Puthikunkim/capstone/software-team/SBOM.md

# Software Bill of Materials (SBoM)

This document lists all third party software dependencies used in this project, their versions, and their licenses.

> **Policy:** The total budget for software licenses, servers, cloud services, and infrastructure is **$0**.  
> The system is self-hosted and runs entirely on a local Windows laptop with no internet connectivity required.
