Puthikunkim/capstone/compsys-team/ProjectResource/Schematic/Adobe Scan 18 Mar 2026.pdf

D
8

6-

I

I

I

£!I ~ • II ···-,l. 1/1 ii/I 1.1/f • \,. 1• I~ f~ ••

2 3 4

liii1iiil ~ ' ( , I

Power bypass between battery and load A(.i<>~ I~ . I > MCU power : loo~f: n;4'1-.J' ~~11, • • ;i t;V I

--- ------------~-;---;, ,.~vi.:--------------::--:-~~:----_:-~:--:---------,/ ..

V0(..1 l\u1.-S~~, 'ti t I~ ~ ( .. , • t1"-1'ti~:{ r;1,.u~1vA-rtut.J ., / J f 1e.ttl1 ll->~\. ""---- LP~ /t'b ()" • v~Nt · V_bn/ I -~i<ooE,, ( '.fc,,'-,wcA {,!~II • (Or,F: (c,11u-f I\"~~ • SVO o-v '<ti '

-- -~(<?:._-'C:,fr-\/1· I I .... 2t_.::J':~~~')J''""""JC.(Hop) ( I/A B:,ttcry tcrmmnls , ,'>\) Lo d terminals • I I I 2V Power Connectors (1. V z 1 ,n • • • • " • • l!, I

~

\'l"\Cr' ;_., '\! LEDi I I [jP7. l"'f"l.___"m f~1~('110JJ LED21.)Vl!$~~L) I

P3 ~ Bl\-rr;~'< ~ ·• • ·o V ~ ~ I .2V0 . • /J~~,o....... ~ V_biu ..... . P2 n ~- :---1 ?o ~ I T ~ '\/b1,'X ().~I/ ~v l V c~v-l.jV) I -;> V bat t'~~ ,Z SVO I - - - -- I "~1f~~/' . ·• ~i~,o_\ 4 P'J!CA'\OI-. \Jc.i...11\CA&-~111-ct1~Gt 3 u2 2 /?, OVTP"f s - ~ - t'°o6-.{\.. I • ~ P4 k k k ', ~ ~\'IV .. .,. j1. P8 11.o Jl'P ~ - ...-i,.llJ. 00 ::. G,.,A_ V/ TP] 4 I • 6 Wl/1-.)~ > .I )'),1,.J .. ~..- f\ I ~--- ··::-.. • ~11>P..:, ) ~ ., ·,·" _,, I fuwE>~~~ I • ' ~ t-,otS&<: ~ 4w c)'.ole_ ~stl V - . t u, I 4M • I - ftl.1~"

-=-
_ t-•~ -=- R.~1lR.-t :').~ J:v_ .«.-:Gpv~) P·r l=l-~cc.oo-t~i'-1(J.<4~ .1..t.J~~- f":tt•1:

©ID -11.,.~"- ~&.~?~LG(... "~i~tCJ~ ... P:~c, -:- <oovt-- l-~l>1=-s-i:tv ""--_ 1~ \J s-~.LV - IA -=- V ((~-1.3) ll. -=- -=- I

--; • ~~ ,.... - <,is-,l\ G~ R LI J. = a tic-A- - "p. ;.' ~ .... \. l Jf~vs ..... .:: ) -~ll.. ' t_NDi. ~ 111A . • GND B

- --------------:---------~Tc,7;"~=~b5"";_,~tV ,,.::;,di-:~7:-~-,::;E;i~¢!~:r-~;--~4°":..:-~-:,~---;:.-J I ,---------------------~--------""'---~---""'-~"T--r,-----,'"'J---1'~ ---
- ~:- v_~ I N~a~1'1uf ftt.DJAf.(,( CJf~P Vi lta d C . , t F db k VE:.P: v- :'\J+ - - V bat ADC GP34 ,

1 • tr ,t,"dt. : o. g<t an u~en ee ac . , -: •. = ~\J. -..1..'Vo.,t~"v _ . _ ..

l :t:.rt-v--" ,i- ·-, • . • ( l c.1. ') - - - ..... I ... li.JltJ'•r• "r/. '' ~,

- - • • • • • • "'• " • -, • • ;. • • * • Vv\- ·- - V • ,, ~ ft n I bat ADC GP35 r\ '""'~ \V N Oct::. : • • ,. V ~- . " ., a - r . "'-\ s "-~ I

.- ;- ": o11,- -~Q~~1:.">vo~,-:.I\) '\J-+-:.,h ~u V""-='V· "' .... I •6Uf-f·f:~~,.,, ! o ' .. c., • : 12-i .. -v ·--=-v+ "' 1 •. '" •v0 vi - - . •

, °"'" 8 5V0 • ~ ltJ- .. .A -v :.) )./,,,.._ \/do;1-V!,. r, a.,.n_, I -luw/kfL,A r,\.S<- • ........ -. lk .. : . • ":") ·vz,-., - ~vr. . . ~ - -==;e=-0' :) I M'S• ..... ~J. I "'l,ilr\ ·.,J ~ I~~ ;: : UIA : ..• Low- PAs~; +-1<..18- 0~ ~ Hl.6>'-ffk,'t): : V I bat a ' ' \' •. P.'l- l ~ '-:,r 1"1 • F ll,"1 ~s ? .. I .. /i..2 ~ ••• , ...... _ 1 t·· -1.- _'i I ' ~ 1 :•Rn •v_bat_ADC .f "O _ -11 •ru..M 1 7 I\IOV{ V ' I 1 V ba Rl4 0~ , I ~ .,.,::i-7::::i;d k 'V, - ~ I I

: Of,.. ' lk 'V~ + t'out =:lk C2 : . I ut;yA.1/:\SriE.'.1 oA:1- 00 UIB IN1 1 'C
I Ji ' V \ \' I -svo • ~--(:>!- RI! (cl '') , 16 / • • \ _ _ • •• • .- •, ., • • •• I .JOOn: •. , l . A.. \,• l_bat_AD -1.. '-\ S" v

j I k ' ' '1. Or., I .,, I , ' • •u • -----+-+---=+ . lk '- • -
·-, \/~1 A~i ~ .. - .... ~ . I • , • Ics •• '.~~ . . t t,V\ -or~,:,. 11 I \,A1"'"«1
_- o1v1.0 .=- -..::;;;;::.....--~ - v-•·o [:--"---- cs'-) U---I . 4

GND_ {£~ GND ,1 o~_ ... -- .,, ... -~- .... -G~ • • V'"' ·; ~P2?. er.:~~tv11 .(l~"'t- ADc )-d _
/ -lN~1.~ ~ ; ',.r-12-6; Rut:.~ .:~-OJ··· -:::) ~-1":-:- ( (J~~o·~)I \Jov1 I/ /i

I f2\~: !.-.y.,ct ~~~ ..... ; ~ \\.d~ ( (j)

__ lltt\ ~- l·\~· e> - GND r ,. L:~ GND -: ---(.. (1: .-V ':"o =-~l~ // ' l . 1 / •/. 4 L' --.<. h , u ,,. V4'\ l)\J\ S<.:) I / 1 4'V\ )

, '("':t'). L""'':":ri ~·r1~«... '.~- ~ ,,- .. , . - ~w:· ~out::-~ =-o .• • .. ; .- .. o:. (>C -~ . I '- )l

# !~~P~~~_!.!::!:!_~_:_:~ P'!~----~~l~---------------------1 \l j

-------~--- ~ -+- • '1 : •• L-:,~·: _:"~'-S~(' -'\/~ {9-ioi,,IJ. (,( (j"4:i.,! ~ i"'~) Title CapstoncProject:Uni-Directiona!EncrgyMeter

Powet and Signal Conditioning Size Nwnber Revision 3

D

A4

Date: 2/2412026 Sheet! of 2

File: C:\Uscr..\.luni dir ene meter v3.SchJ)lilrawn By: TD, SK & AB

2 3 4
