Puthikunkim/capstone/compsys-team/ProjectResource/Lectures/L4 - Practical Circuits and RC Filters.pdf

Grant Covic and Duleepa Thrimawithana

## Signal Conditioning

# Electronics System Design

## ELECTENG 209

•

# Learning Objectives

Review of operational amplifier basics

- What are inverting and non-inverting amplifiers
- How are difference amplifiers created and why are they useful?
- Understanding practical signal conditioning circuits using single sided supplies
- What practical considerations are needed with voltage and current measurement circuits?
- How do we create RC filters and what are the design approaches in the frequency domain?
- Understanding the use and design of comparators for interrupt circuits
- Design guidelines for creating a regulated supply suited to your analogue and digital electronics.
2 Grant Covic and Duleepa Thrimawithana, Department of Electrical, Computer, and Software Engineering (2022)

# The Energy Monitor Hardware design

3

- Requires Voltage Sensing, Current Sensing as discussed earlier.
- Signal conditioning

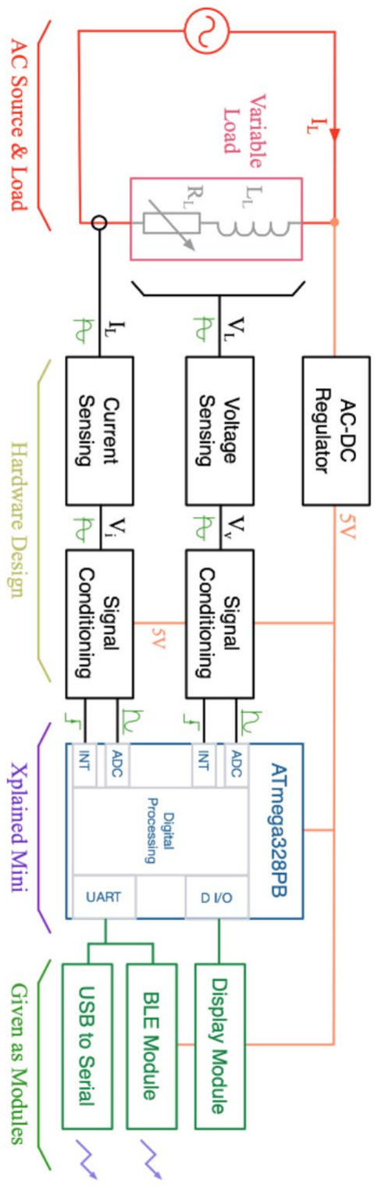
[picture p21: figure]

- Level shifting, amplification and noise reduction
- Generation of a suitable interrupt to trigger measurement from the microprocessor.
- Practical operation from a single 5V power regulator.

Grant Covic and Duleepa Thrimawithana, Department of Electrical, Computer, and Software Engineering (2022)

## Operation with Single Sided supplies

## Thevenin Equivalents

## Level Shifting

# Practical Signal Conditioning Circuits

# Signal Conditioning of the Voltage and Currents

23

The Analogue to Digital Converter (ADC) measurement in a microprocessor only samples positive voltages (0-5V),

while the AC signal has no DC component. We also normally only have one single supply to operate the op-amp off.

•

Therefore we need to
Add a DC offset to the signal, then amplify and filter as required
- Use an op-amp that is operating off a single 5V supply.
- The output will appear as a ±2.5V AC signal swing. 5 V

Range

ADC

0

v

VVVVVV

0

v

Grant Covic and Duleepa Thrimawithana, Department of Electrical, Computer, and Software Engineering (2022)

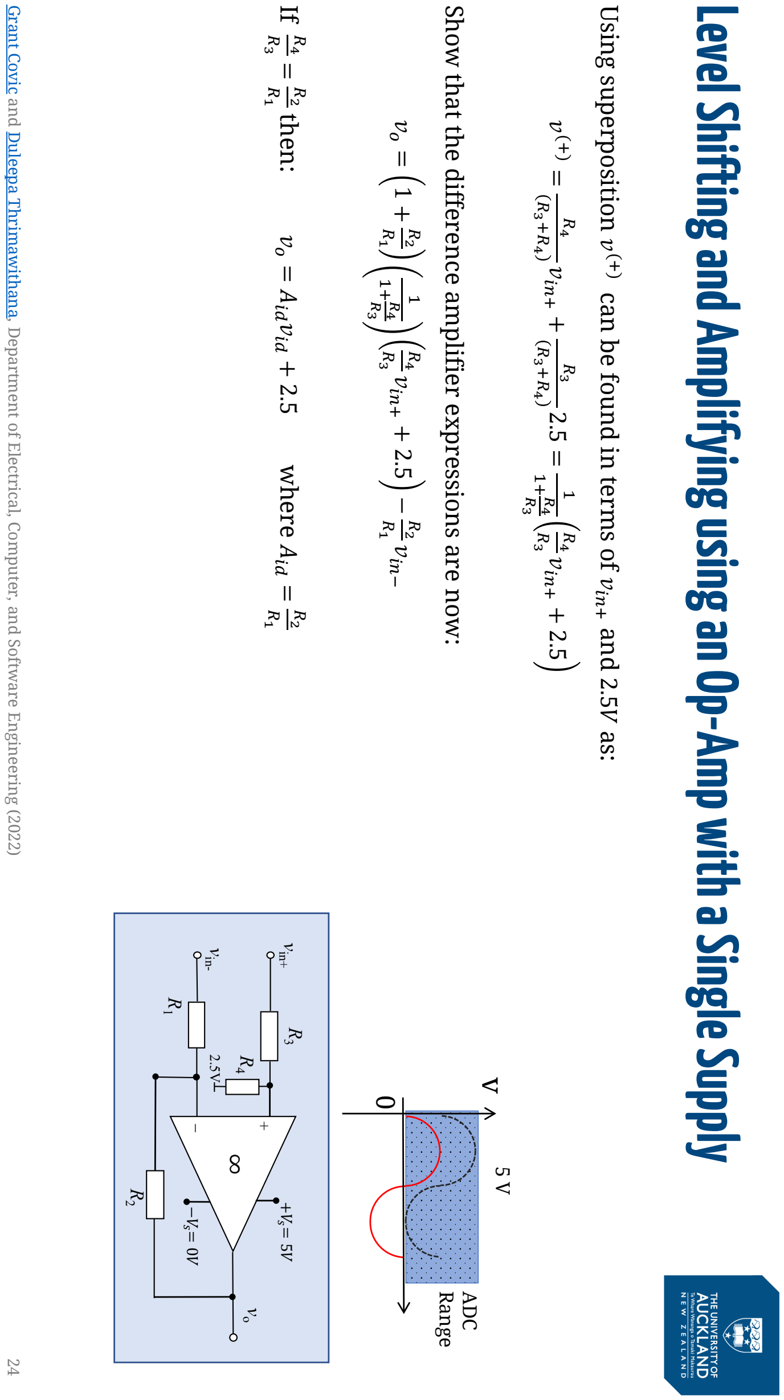
[picture p22: figure]
vviiii+ + RR3; RR3 vviiii+ + 2.5; vvoo = 1 + RR2; RR3 vviiii+ + 2.5 − RR2; vviiii−; RR1 then: vvoo =; AAiiiivviiii + 2.5 where; AAiiii; Range; ADC; ∞ vin-; R3 vin+; +VVss= 5VV; −VVss= 0VV

# Level Shifting and Amplifying using an Op-Amp with a Single Supply

Using superposition vv(+) can be found in terms of vviiii+ and 2.5VV as:

Show that the difference amplifier expressions are now:
Grant Covic and Duleepa Thrimawithana, Department of Electrical, Computer, and Software Engineering (2022)

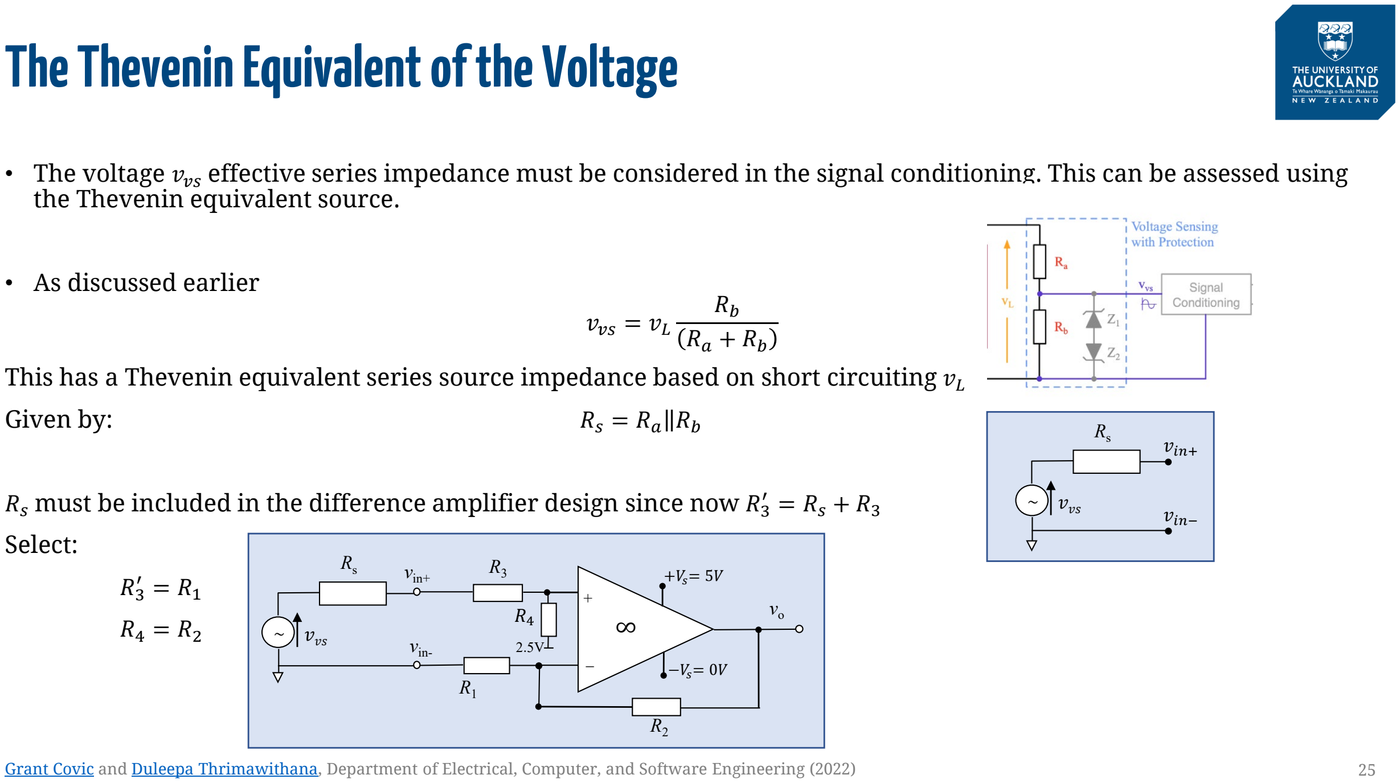
[picture p23: figure]
The Thevenin Equivalent of the Voltage; the Thevenin equivalent source.; • As discussed earlier; vvvvss = vvLL; RRbb RRaa + RRbb; Given by:; RRss = RRaa‖RRbb; Select:; vvvvvv; vviiii−; vviiii+; vin-; +VVss= 5VV; −VVss= 0VV

- The voltage vvvvss effective series impedance must be considered in the signal conditioning. This can be assessed using

This has a Thevenin equivalent series source impedance based on short circuiting vvLL

RRss must be included in the difference amplifier design since now RR3′ = RRss + RR3

Grant Covic and Duleepa Thrimawithana, Department of Electrical, Computer, and Software Engineering (2022)

# Output Voltage limitations of Op-Amps

Standard Op-Amps have outputs that cannot reach voltage supply rails, and current limits when sinking or sourcing. Voltage limits: The upper and lower voltage limits are LL+and LL−respectively. Trying to output a voltage above or below these limits will cause the signal to be clipped.
- E.G., the usable output range of the LM324/358 (in your design) has LL− = 5mmVV, LL+ = 3.5VV (when the supply is 5 V)
- A rail to rail Op-Amp could be used to improve accuracy
- Output could reach close to supply rails thus allowing to utilize full ADC range of 0 V to 5 V

0

vamp

Rail to rail Op-Amp

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
1.75V

+VVss= 5VV

−VVss= 0VV

VVVVVV

Rs

~
RRLL

IIoo

IL IF
0

voMAX

Standard Op-Amp

5 V

Grant Covic and Duleepa Thrimawithana, Department of Electrical, Computer, and Software Engineering (2022) | 26

# Output Current limitations of Op-Amps

Current Limits: the specified current limits (typically 20mA), include the total of the load and feedback circuit which the op-amp must supply, but the capability of the 358 to sink current at low voltage is poor.
- If there is an output load RRLL, when does the maximum current flow?
- At the peak voltage (3.5V), IIoooooooo = IIFF + IILL. If IIoooooooo > IILLLLoo then the waveform will clip. Choose resistors in kkΩ
- If there is an output filter there may be issues sinking the current into the op-amp to bring the load voltage down to < 1V that may mean we need smaller values for RRLL, RR2 and RR1to reduce the capacitor voltage in time

0

voMAX

Standard Op-Amp

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
1.75V

+VVss= 5VV

−VVss= 0VV

VVVVVV

Rs

~
RRLL

IIoo

IL IF

R1
R2

vo +

−

∞

R3

RR4

1.75V

+VVss= 5VV

−VVss= 0VV

VVVVVV

Rs

~
RRLL
Io | IL
IF | CL
vL | In general, choose:
R’s < 500k
C’s > 100pF

At minimum vvoo → 0

Grant Covic and Duleepa Thrimawithana, Department of Electrical, Computer, and Software Engineering (2022)

# Ex: Voltage Measurement

Design a differential amplifier, that can level shift vvvv measured by the voltage sensing circuit in the figure below to be within 0 to 3.5 V (within the op-amp and ADC range). Ignore the lower limitation on the Op-Amp.
- Design for a level shift of 3.5V/2 = 1.75 V
- Peak to peak level of sensed signal

vvvv(pppp−pppp) = 24 × 2 × 2 × 10pp 220pp+10pp = 2.95VV

The differential amplifier gain should be no more than 1.4, but choosing AAiiii~1 is sufficient
- Aim to achieve a 3 V signal swing at output, (0.25 V off the rail limit).
- The RMS Thevenin voltage source and resistance are: vvvvss = 24 × 10pp 220pp+10pp = 1.04VVRRooVV and RRss = 220pp×10pp 220pp+10pp = 9.6kkΩ
- If AAiiii = RR2RR1 = 1, then make RR1 = RR2 = RRss + RR3 .
- We can choose RR1 = RR2 = 100kkΩ and RR3 = 90.4kkΩ ≈ 22kkΩ + 68kkΩ by connecting two E12 value resistors in series.
24VVRRRRVV | RL

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
vvvv

RR2

1.75V

+VVss= 5VV

−VVss= 0VV

10kkΩ

220kkΩ

vvLL

Grant Covic and Duleepa Thrimawithana, Department of Electrical, Computer, and Software Engineering (2022) | 28

# Level Shifting with a Cap

A DC bias derived through for example a voltage bias and an AC coupling capacitor can be used for level-shifting
- An example of voltage measurement is shown in figure
- An AC coupling capacitor, CCaaii, used to add the sensed voltage, vvvv, with a 2.5VV bias derived through two RR1’s

CCaaii together with Thevenin resistances of vvvv and bias voltage all together form a high-pass filter
This arrangement can be used to eliminate the need for an Op-Amp
- The disadvantage is that this network cannot amplify the measured signal and will couple any high-frequency noise present, which is automatically suppressed by the op-amp due to its internal filtering.
- The capacitor can introduce some phase shift in the signal.
Grant Covic and Duleepa Thrimawithana, Department of Electrical, Computer, and Software Engineering (2022) | 29

# Ex: Current Measurement

Op-amp range 3.5V

ADC Range 0-5V

0

vout

1.75V

3.16V

0.34V

2.03V

1.47V

0

vi

0.141V

-0.141V

28mV

28mV

iL = 1 A and iL = 0.2 A

24VVRRRRVV

RL

~

10kkΩ

100kkΩ

vo

+

−

∞

10kkΩ

vvii 100kkΩ 1.75V

+VVss= 5VV

−VVss= 0VV

0.1Ω

vL iL

A 100 mΩ shunt resistor is used to sense the current flowing through a variable load.
The load current is in the range 0.2 ARMS to 1 ARMS.

Design a differential amplifier, that can amplify and level shift this signal to be within 0 to 3.5 V (op-amp range).

- Max and min peak-peak signal sensed by the shunt

vvii,oooooo(pppp−pppp) = ii pppp−pppp RRss = 2 2 × 1AARRooVV × 100mmΩ = 282mmVV

vvii,ooLLMM(pppp−pppp) = ii pppp−pppp RRss = 2 2 × 0.2AARRooVV × 100mmΩ = 56mmVV

Again design to achieve around a 3 V signal swing at output (0.25 V off either rail)

AAiiii = RR2RR1 = 3VV 0.282VV = 10.64

- Choosing a gain of AAiiii~ 10 would satisfy this.
- Choose RR1 = 10kkΩ and RR2 = 100kkΩ (E12 series)
- Min and Max voltage swings are: 0.56V and 2.82V

5V

Grant Covic and Duleepa Thrimawithana, Department of Electrical, Computer, and Software Engineering (2022) | 30

## Frequency domain filtering

## Frequency domain Bode plots

## A simple RC Circuit

# RC Filters and the Frequency Response

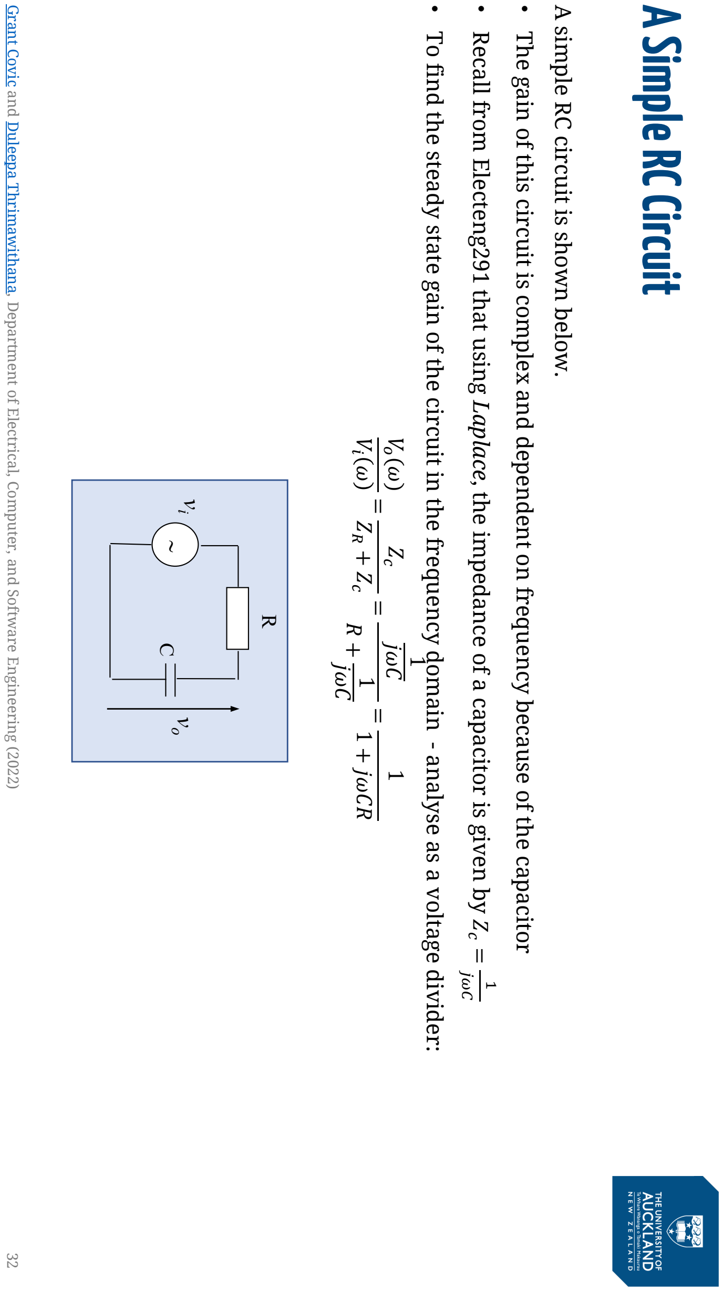
[picture p24: figure]
A simple RC circuit is shown below.; A Simple RC Circuit; ZZii = 1; jjωωωω; VVoo(ωω); VVii ωω; ZZii; ZZRR +; jjωωCC; = 1 1 + jjωωCCRR

The gain of this circuit is complex and dependent on frequency because of the capacitor

- Recall from Electeng291 that using Laplace, the impedance of a capacitor is given by
- To find the steady state gain of the circuit in the frequency domain - analyse as a voltage divider:

Grant Covic and Duleepa Thrimawithana, Department of Electrical, Computer, and Software Engineering (2022)

•

If the gain of a circuit is complex, then like any complex number if can be expressed in terms of its magnitude and phase.

# Frequency Domain Bode Plots

For zz = aa + jjjj

The magnitude of this complex number is: zz = aa + jjjj = aa2 + jj2

## The phase of this complex number is: ∠zz = tan−1 aabb

- In the case of the complex gain expression for the RC circuit, both phase and magnitude are changing with ωω

Bode plots are used to view separately how the magnitude and phase vary with frequency.
frequency range

However it is convenient to look at the impact using a logarithmic scale because the impact can be seen over a very wide

- often over many orders of magnitudes. Our ear also has a logarithmic response which makes this assessment useful. The “bel” scale was defined as the log-base-ten of the ratio of two signal intensities related to the power or
energy in the signal. As there are 10 decibels per bel the power ratio is defined as:

## 10llllll10 PPooPPii the power ratio in decibels (dB)

Power is proportional to the square of the voltage and therefore this is re-expressed as

## 20llllll10 VVooVVii (the voltage ratio in dB)

Here the voltages are in terms of their rms quantities.
33 Grant Covic and Duleepa Thrimawithana, Department of Electrical, Computer, and Software Engineering (2022)
In engineering base 10 is assumed as the default when

# Frequency Domain Bode Plots

log HH(ωω) is used.

- The Bode magnitude is a plot of the gain expression in dB 20 log VVoo ωω VVii ωω against log ωω

## - The Bode phase is a plot of tan−1 VVoo ωω VVii ωω against log ωω

•

Simple log rules are useful to remember
log AAAA = log AA + log AA and log ⁄AA AA = log AA − log AA

Creating the Bode plot

## - Defining the time constant TT = RRCC, then GG ωω = 1 1+jjωωjj

- Matlab can be used to plot the Bode expression for any given value of T.

34

T=10;

clc

% Time constant = 10s

num=1; % define numerator as 1

den=[T, 1]; % define denominator as sT+1 = jωT+1

sys = tf(num,den) % define the system transfer function

figure(1) % set up a figure to plot the system

bode(sys) % create the bode plot

grid % add a grid

Grant Covic and Duleepa Thrimawithana, Department of Electrical, Computer, and Software Engineering (2022)

For

Sketching approximate Bode plots

# Frequency Domain Bode Plots

GG ωω = 1

1+jjωωjj ,

Bode magnitude in dB is: GG ωω iidd = 20 log 1 1+jjωωjj = −20 log 1 + jjωωTT = − 20 log 1 + jj ⁄ ωω ( ⁄1 TT)

Bode phase is: ∠GG ωω = ∠ 1 1+jjωωjj = −∠ 1 + jjωωTT = − tan−1 ⁄ ωωTT 1 = − tan−1 ⁄ ωω ( ⁄1 TT)

The breakpoint frequency can be defined as ωωbb = ⁄1 TT

- When ωω = ωωbb, then GG(ωωbb) iidd ≅ −20 log 1 + jj1 = −20 log 2 = −3ddAA ∠GG ωω = − tan−1 ⁄1 1 = −45°

Asymptotes can be determined either side of ωωbb
- When ωω ≪ ωωbb, then GG ωω iidd = −20 log 1 + ⁄ jjωω ωωbb ≅ −20 log 1 = 0ddAA ∠GG ωω ≪ ωωbb = − tan−1 ⁄0 1 = 0
- When ω ≫ ωb, then G ω id = −20 log 1 + ⁄ jω ωb ≅ −20 log ⁄ jω ωb dA ∠G ω ≫ ωb = − tan−1 ⁄ ω ωb = −90°
Example: ωω = 10ωωbb gives GG(10ωωbb) iidd = −20 log ⁄ jj10ωωbb ωωbb = −20ddAA, ∠GG 10ωωbb − tan−1 10 = −84.3°

ω = 100ωωbb gives G(100ωωbb) id = −20 log jj100 = −40ddAA, ∠G 100ωωbb − tan−1 100 = −89.4°

35 Grant Covic and Duleepa Thrimawithana, Department of Electrical, Computer, and Software Engineering (2022)

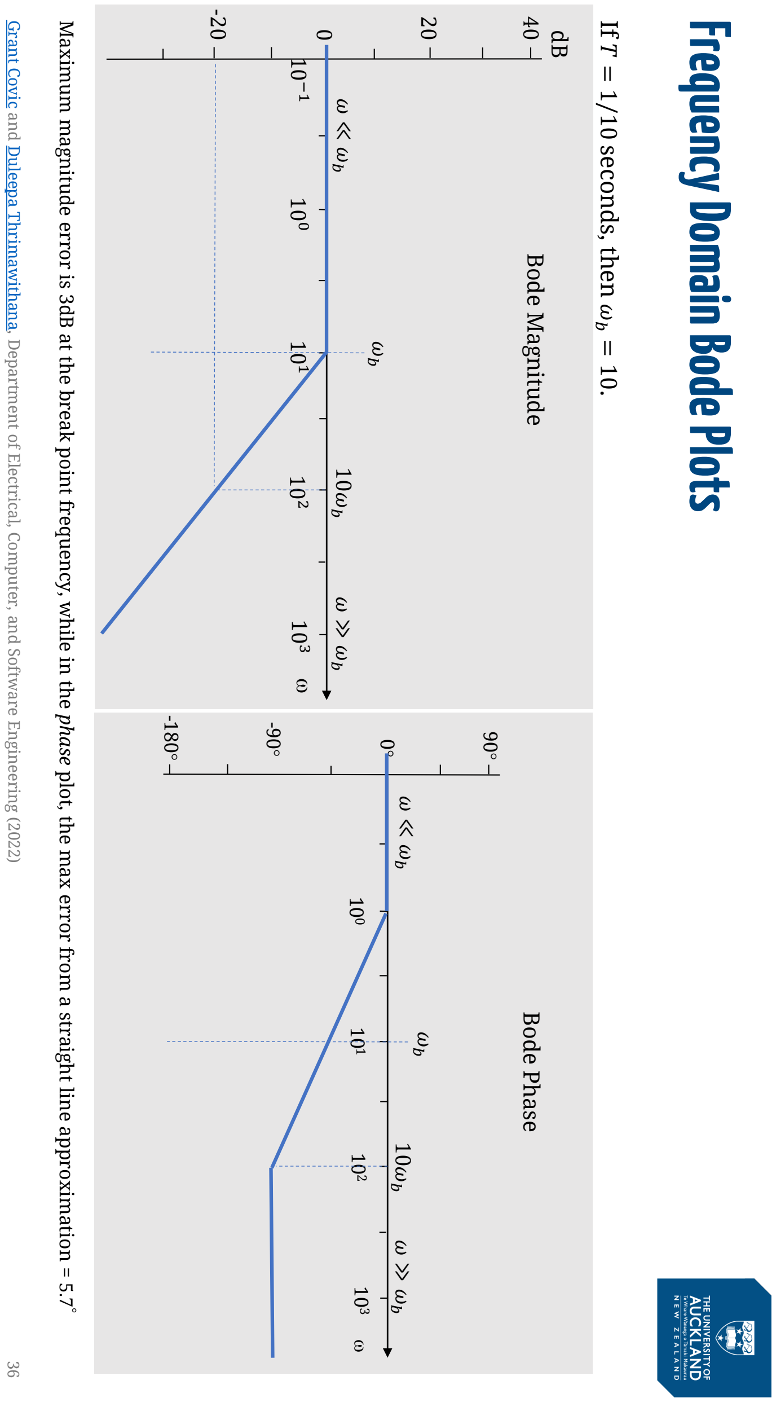
[picture p25: figure]
Frequency Domain Bode Plots; TT = 1/10 seconds, then ωωbb = 10.; ωωbb; ωω ≪ ωωbb ωω ≫ ωωbb 100 101 102 103 ω; ωω ≪ ωωbb ωω ≫ ωωbb; 10ωωbb; Bode Magnitude Bode Phase

Maximum magnitude error is 3dB at the break point frequency, while in the phase plot, the max error from a straight line approximation = 5.7°

Grant Covic and Duleepa Thrimawithana, Department of Electrical, Computer, and Software Engineering (2022)

components

From Electeng291 notes recall that a periodic waveform in the time domain is constructed of various frequency

All real world signals are made up of various frequencies.

# Frequency Domain Filtering

– and the magnitude of these can be determined from the Fourier series:

•

For example consider the square wave shown. When this waveform is passed through the filter: Frequencies at least a decade below ωωbb = 2ππffbb will have their magnitude and phase preserved.

- Frequencies above ωωbb will have their magnitude reduced (attenuated) and will also be shifted in phase.
- Ex: Assume an input waveform as: vvii = sin ωωfftt + 0.33 sin 3ωωfftt + nnlliivvnn

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
vvoocan be phase distorted if ωωff → ωωbb

third harmonic reduced and phase shifted

-1/3V

1/3V 0

vo

1V

-1V

-1/3V

1/3V

vvoo when ωωff ≪ ωωbb

no amplitude loss and no phase distortion

Ex: Square wave time domain v.s.

frequency component amplitudes & phases
Grant Covic and Duleepa Thrimawithana, Department of Electrical, Computer, and Software Engineering (2022)

# Questions?
