Puthikunkim/capstone/compsys-team/ProjectResource/Lectures/negativeFeebackLoop.pdf

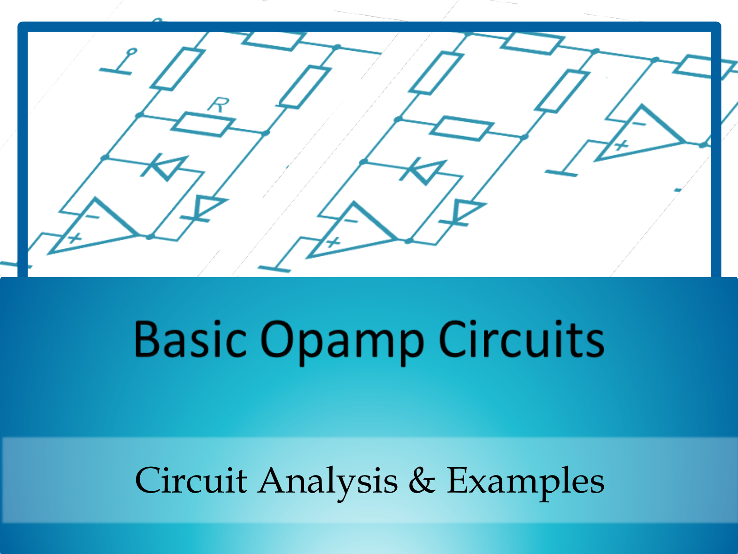
[picture p26: page 1]

### Circuit Analysis & Examples

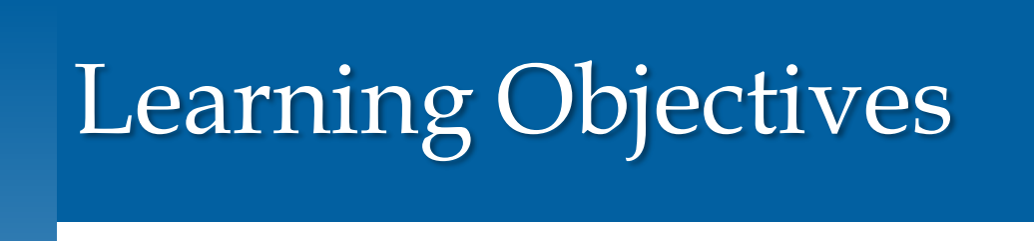
[picture p27: figure]
Learning Objectives

Prepared by Dulsha Kularatna-Abeywardana for ELECTENG 292

- Study the following commonly used circuits which are designed using opamps:
– Standard voltage amplifiers
✓Inverting amplifier
✓Non-inverting amplifier
– Summing amplifiers
– Differential amplifier
– Voltage follower
– Current to voltage converter – Integrator & differentiator

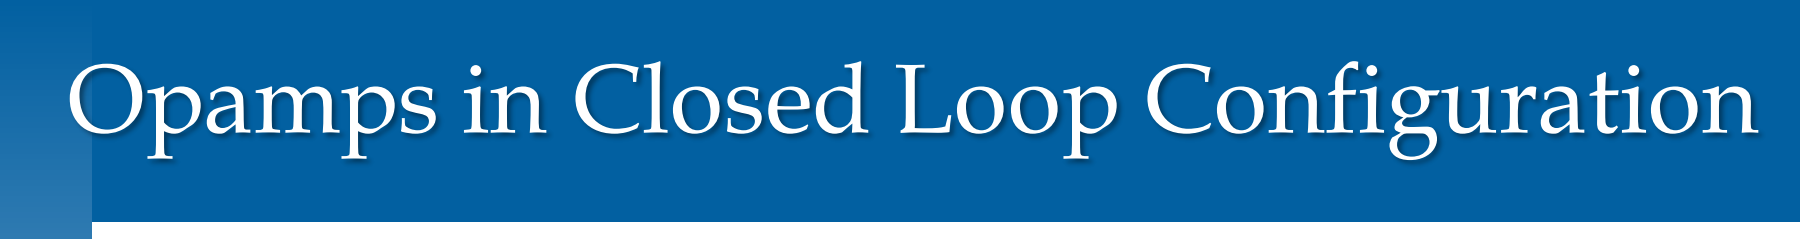
[picture p28: figure]
Opamps in Closed Loop Configuration

Prepared by Dulsha Kularatna-Abeywardana for ELECTENG 292

- Opamps are not very useful in their open loop configuration as the gain is too high.
- We will now investigate opamp circuits which have their output fed back to the input.
- This is known as the closed loop configuration.
- The closed loop gain G is dependent on the component values of the opamp circuit.
- G is independent of the open loop gain A.

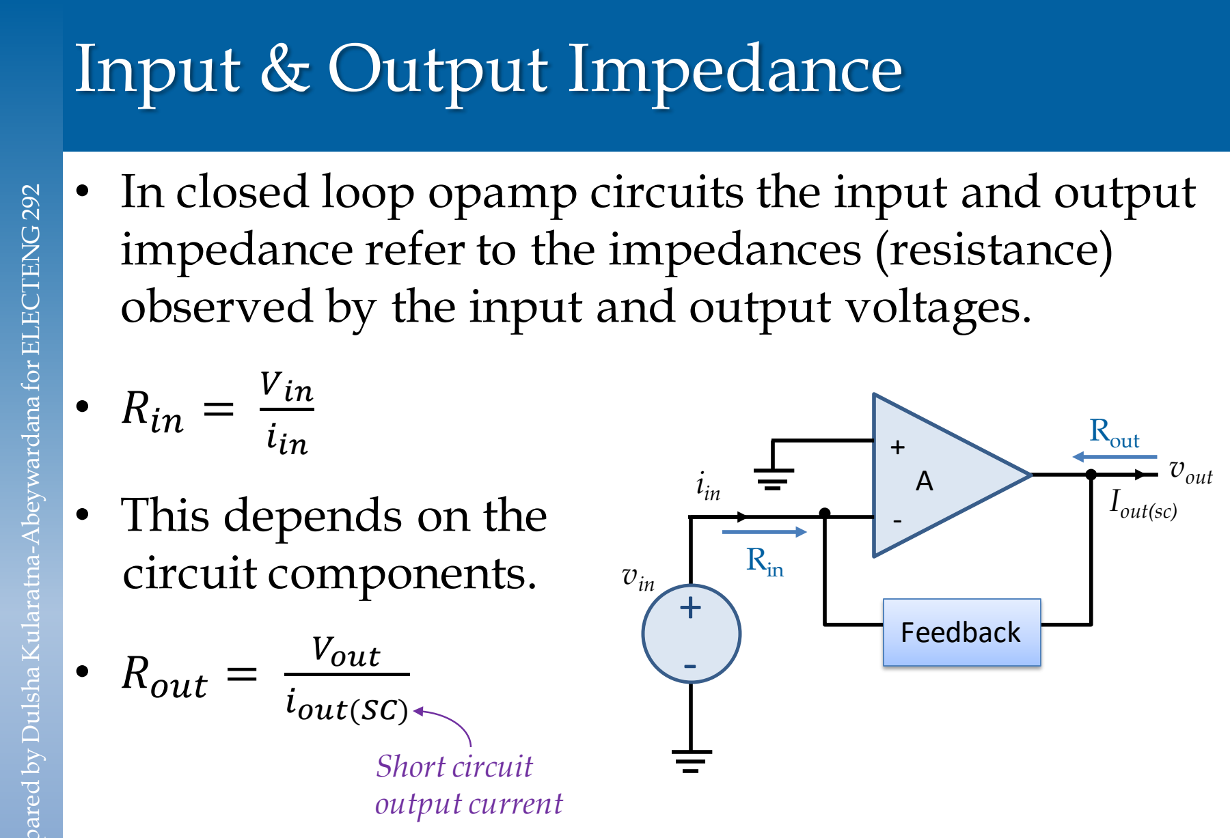
[picture p29: figure]
Input & Output Impedance • RRiiii =; VViiii iiiiii; • This depends on the circuit components. • RRoooooo =; VVoooooo iioooooo(SSSS); vout; Iout(sc); vin; Feedback; iin; Rin; Rout; Short circuit output current

Prepared by Dulsha Kularatna-Abeywardana for ELECTENG 292

- In closed loop opamp circuits the input and output impedance refer to the impedances (resistance) observed by the input and output voltages.

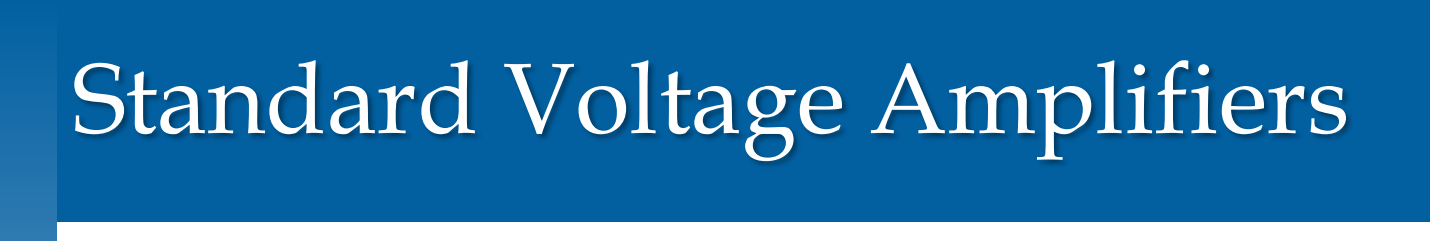
[picture p30: figure]
Standard Voltage Amplifiers

Prepared by Dulsha Kularatna-Abeywardana for ELECTENG 292

- Two basic configurations:
– Inverting amplifier: Input and output are opposite in polarity
– Non-inverting amplifier: Input and output have the same polarity

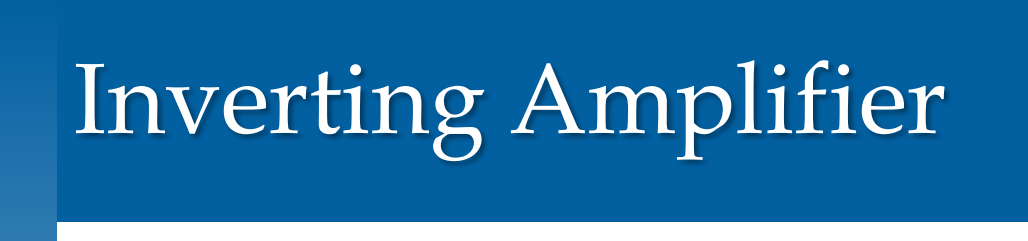
[picture p31: figure]
Inverting Amplifier

Prepared by Dulsha Kularatna-Abeywardana for ELECTENG 292

- The output has the opposite polarity to the input voltage.

Vin

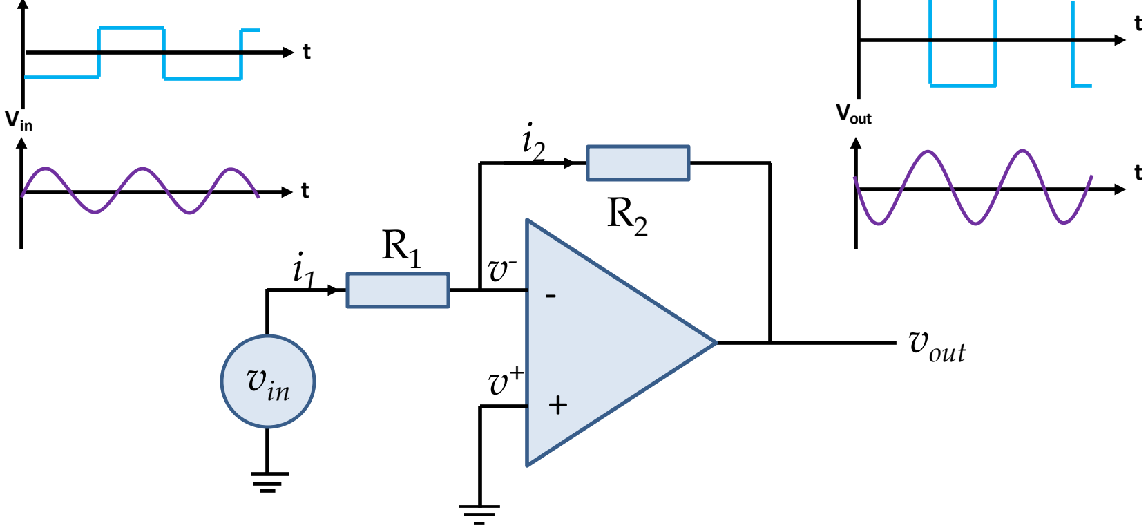
[picture p32: figure]
vout; vin; Vin; Vout

Vout

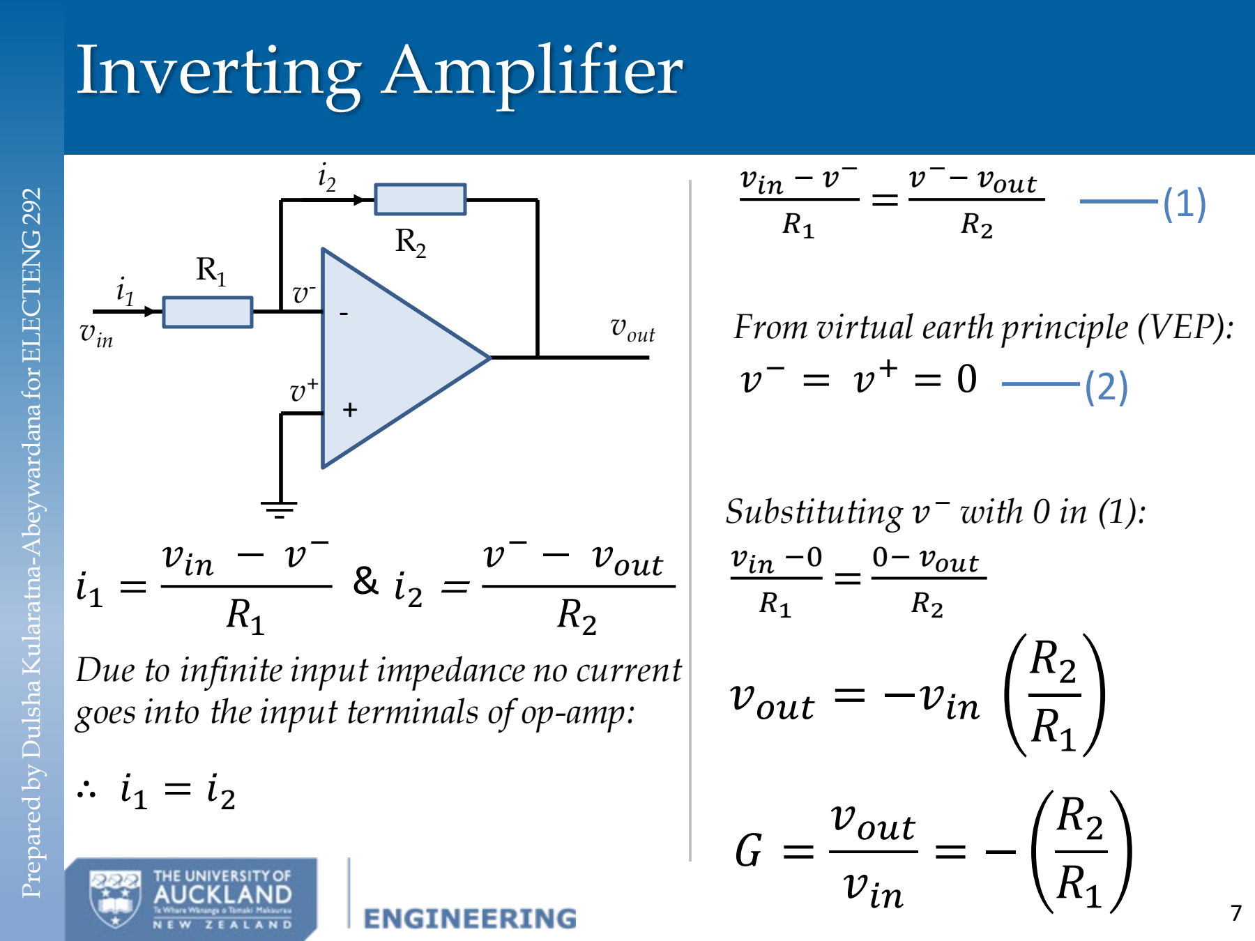
[picture p33: figure]
Inverting Amplifier; vout; vin; vv− − vvoooooo RR2; vviiii − vv− RR1 ∴ ii1 = ii2; vviiii − vv− RR1; vv−− vvoooooo RR2; From virtual earth principle (VEP):; vvoooooo = −vviiii; vviiii −0 RR1; 0− vvoooooo RR2; Substituting vv− with 0 in (1):; vvoooooo vviiii

Prepared by Dulsha Kularatna-Abeywardana for ELECTENG 292

Due to infinite input impedance no current goes into the input terminals of op-amp:

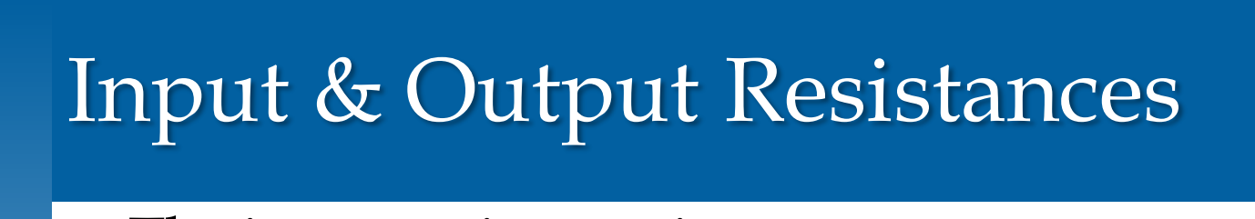
[picture p34: figure]
Input & Output Resistances

Prepared by Dulsha Kularatna-Abeywardana for ELECTENG 292

- The input resistance is:

## RRiiii =

VViiii
iiiiii

=

VViiii
ii1

= RR1

- To avoid signal loss a high input resistance is needed.
- A large resistance must be chosen for R1.
- If a large gain is required (G = R2/R1), R2 might become impractically large.
- Inverting amplifiers suffer from a low input resistance.
- The output voltage and current are taken at the terminals of the ideal voltage source at output, the output resistance is zero.

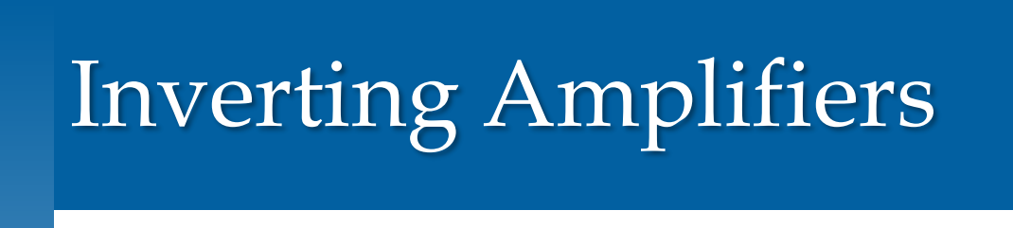
[picture p35: figure]
Inverting Amplifiers

Prepared by Dulsha Kularatna-Abeywardana for ELECTENG 292

- It follows the negative feedback.
- The gain factor of these amplifiers is very high.
- The output generated will be out of phase with the applied input signal.
- The potential values at both inverting and non-inverting terminals will be maintained at zero.
- Practical uses include:
– Phase shifter as the output is 180-degrees out of phase – Integration
– To balance signals
– Amplifiers for sensors

## Inverting Amplifier: Example

# ii1 = vviiii − vv−

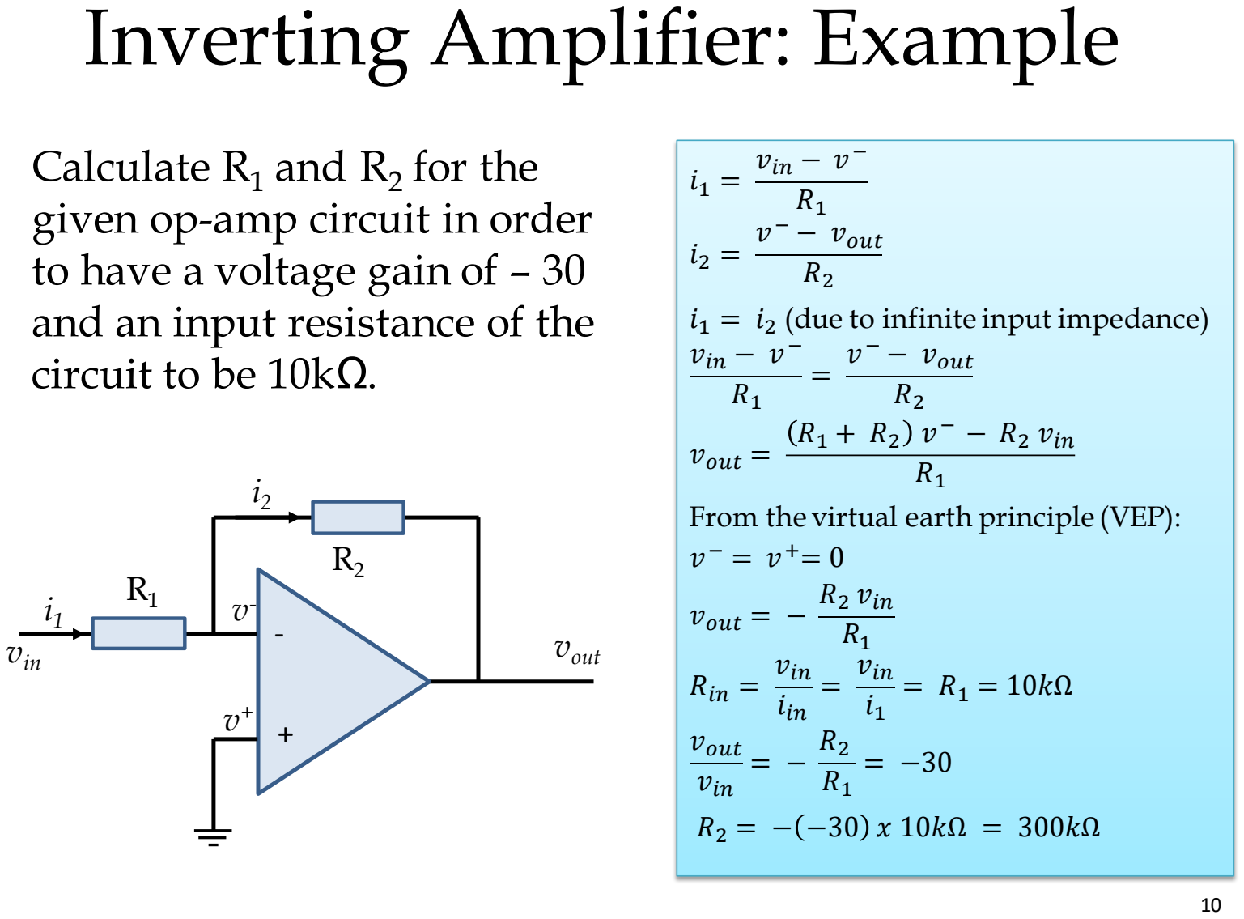
[picture p36: page 10]

Calculate R1 and R2 for the given op-amp circuit in order to have a voltage gain of – 30 and an input resistance of the circuit to be 10kΩ.

RR1

# ii2 = vv− − vvoooooo

RR2
ii1 = ii2 (due to infinite input impedance)

# vviiii − vv−

RR1

# = vv− − vvoooooo

RR2

# vooo = RR1 + RR2 v− − RR2 vii

RR1

From the virtual earth principle (VEP):

# vv− = vv+= 0

# vooo = − RR2 vii

RR1

# Rii = vii

iiiiii

= vviiii
ii1

# = RR1 = 10kkΩ

vvoooooo
vviiii

= − RR2
RR1

= −30

# RR2 = − −30 xx 10kkΩ = 300kkΩ

vout

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
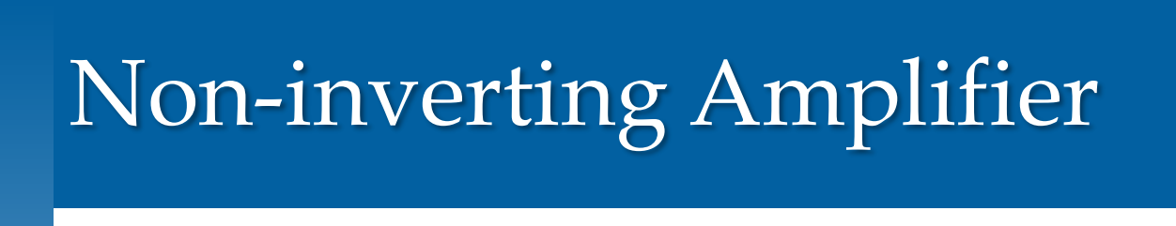
[picture p37: figure]
Non-inverting Amplifier

Prepared by Dulsha Kularatna-Abeywardana for ELECTENG 292

- Known as the ‘non-inverting amplifier’ because the output has the same polarity as input voltage.

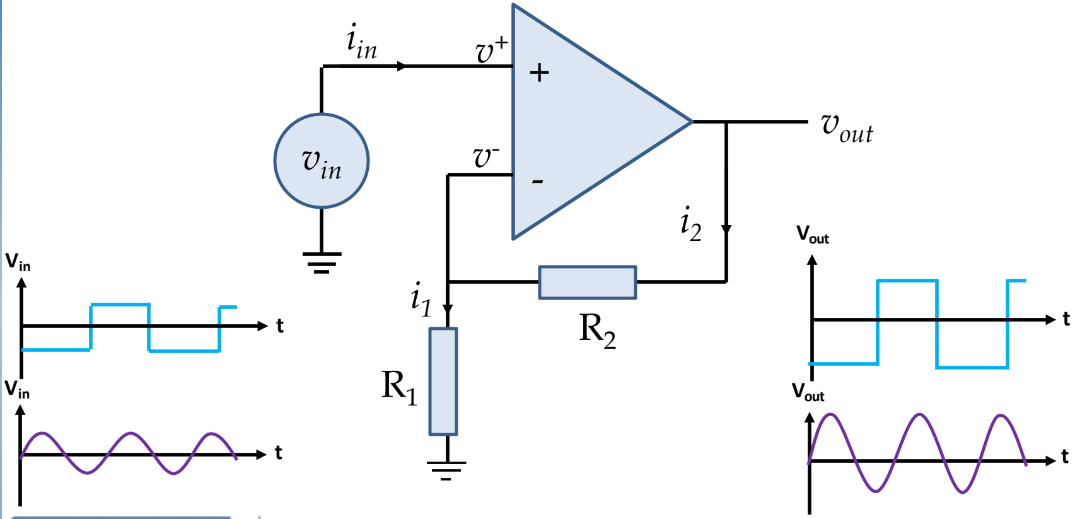
[picture p38: figure]
vout; - vin; iin; Vin; Vout

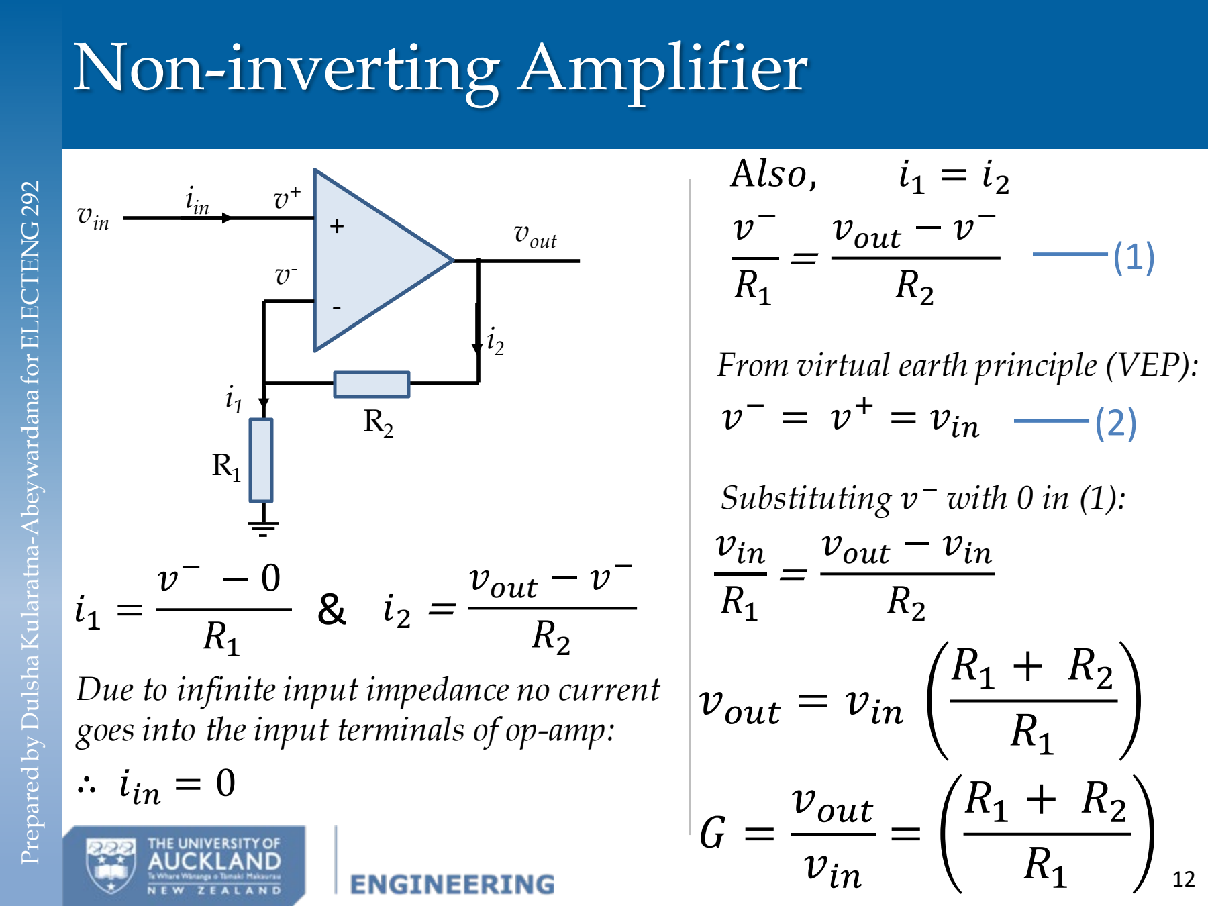
[picture p39: figure]
Non-inverting Amplifier; vvoooooo − vv− RR2; Allllll, ii1 = ii2; From virtual earth principle (VEP):; vv− = vv+ = vviiii; vout; vin; iin; ∴ iiiiii = 0; vvoooooo = vviiii; Substituting vv− with 0 in (1):; vviiii RR1; vvoooooo − vviiii RR2; vvoooooo vviiii

Prepared by Dulsha Kularatna-Abeywardana for ELECTENG 292

Due to infinite input impedance no current goes into the input terminals of op-amp:

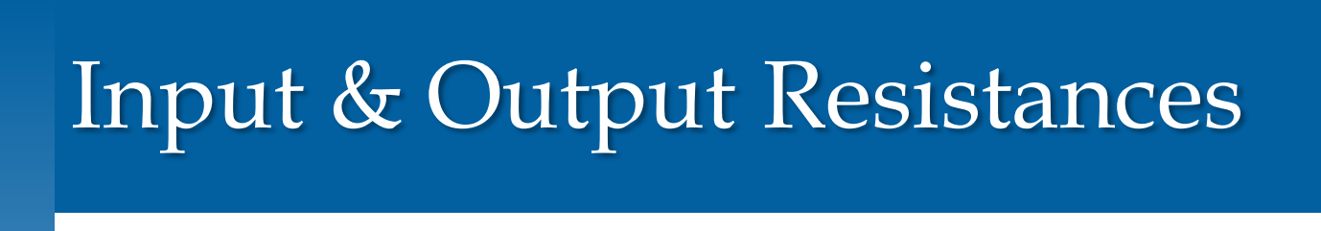
[picture p40: figure]
Input & Output Resistances

Prepared by Dulsha Kularatna-Abeywardana for ELECTENG 292

- The input resistance is:

# RRiiii =

VViiii
iiiiii

=

VViiii
0

= ∞

- This is advantageous in some cases.
- The output voltage and current are taken at the terminals of the ideal voltage source at output, the output resistance is zero.

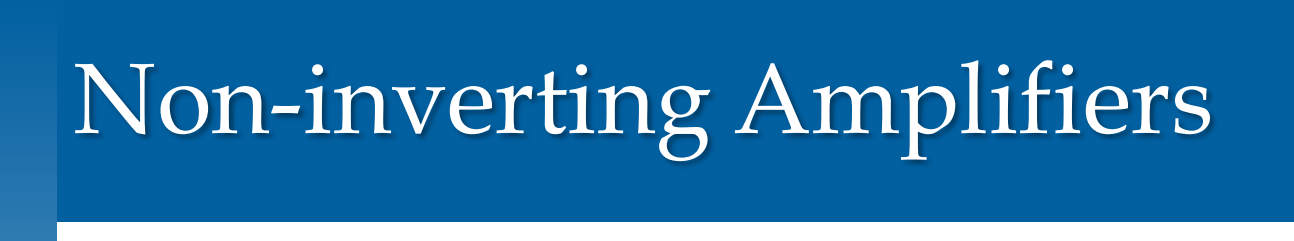
[picture p41: figure]
Non-inverting Amplifiers

Prepared by Dulsha Kularatna-Abeywardana for ELECTENG 292

- The voltage gain is always greater than one.
- The voltage gain is positive, and the output is inphase with the input signal (for AC) and the output polarity has the same as the input (for DC).
- These are used in
– Circuits that require a high input impedance
– To isolate the respective cascaded circuits

## Non-inverting Amplifier: Example

=> ∞

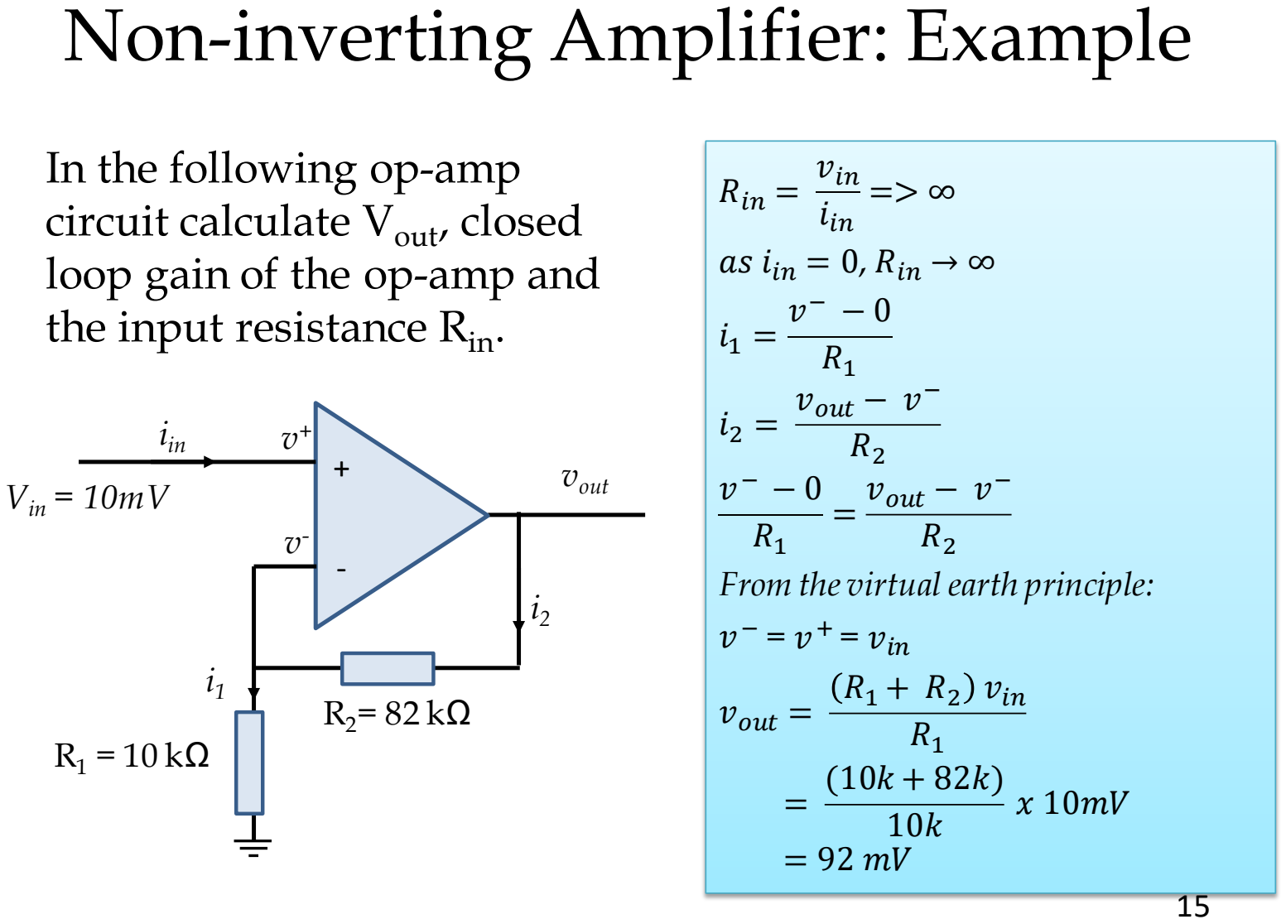
[picture p42: page 15]

In the following op-amp
circuit calculate Vout, closed loop gain of the op-amp and the input resistance Rin.

RRiiii =

vviiii
iiiiii

# aa iiiiii = 0, RRiiii → ∞

ii1 =

vv− − 0
RR1
ii2 =

# vvoooooo − vv−

RR2
vv − − 0
RR1

=

# vvoooooo − vv−

RR2

From the virtual earth principle:

# vv − = vv + = vviiii

## vvoooooo =

# RR1 + RR2 vviiii

RR1
=

# (10kk + 82kk) 10kk xx 10mm

= 92 mm

v⁺

v-

vout

R2= 82 kΩ
R1 = 10 kΩ

+

Vin = 10mV

iin

i1

i2

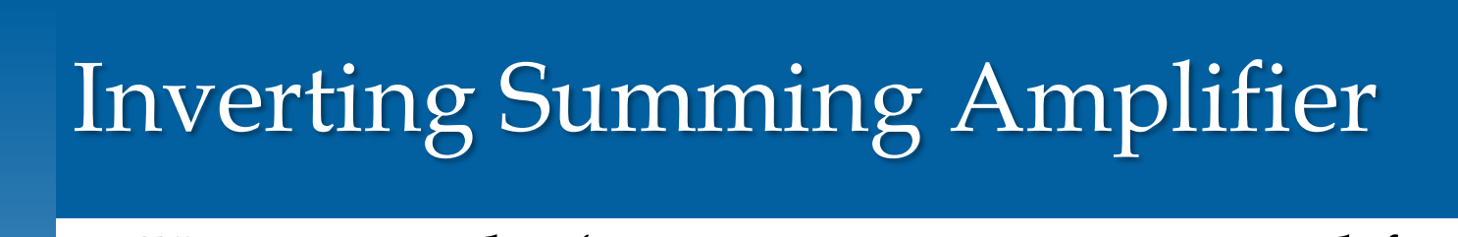
[picture p43: figure]
Inverting Summing Amplifier

Prepared by Dulsha Kularatna-Abeywardana for ELECTENG 292

- Known as the ‘inverting summing amplifier’ as the output is a weighted sum of the input voltages,

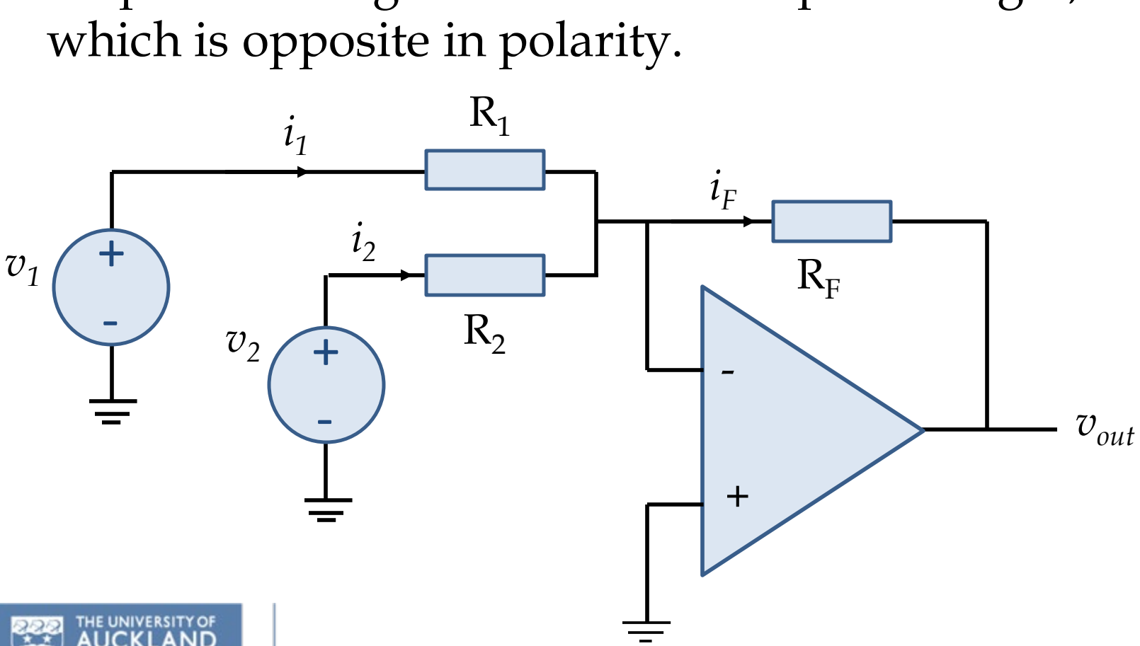
[picture p44: figure]
which is opposite in polarity.; vout

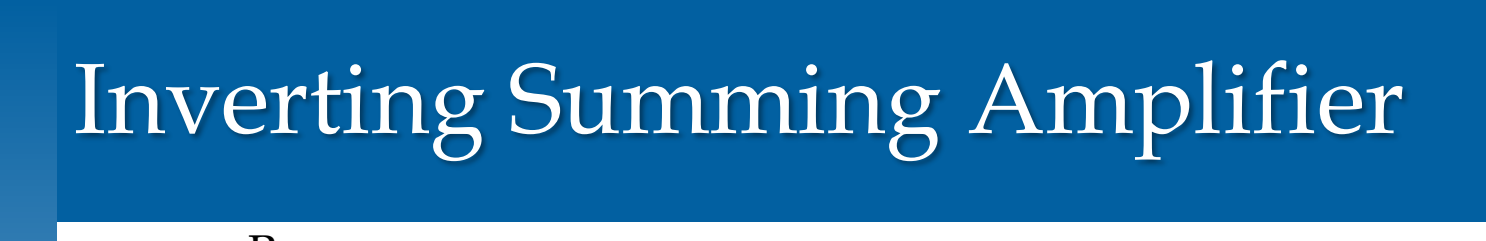
[picture p45: figure]
Inverting Summing Amplifier

Prepared by Dulsha Kularatna-Abeywardana for ELECTENG 292

vout

R1

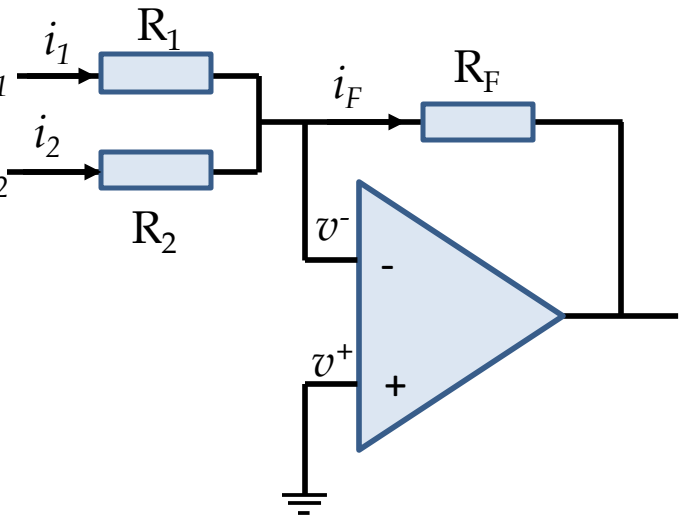
[picture p46: figure]

v2

v1

ii2 =

# vv2 − vv−

RR2

ii1 =

# vv1 − vv−

RR1
iiFF =

# vv− − vvoooooo

RRFF

&

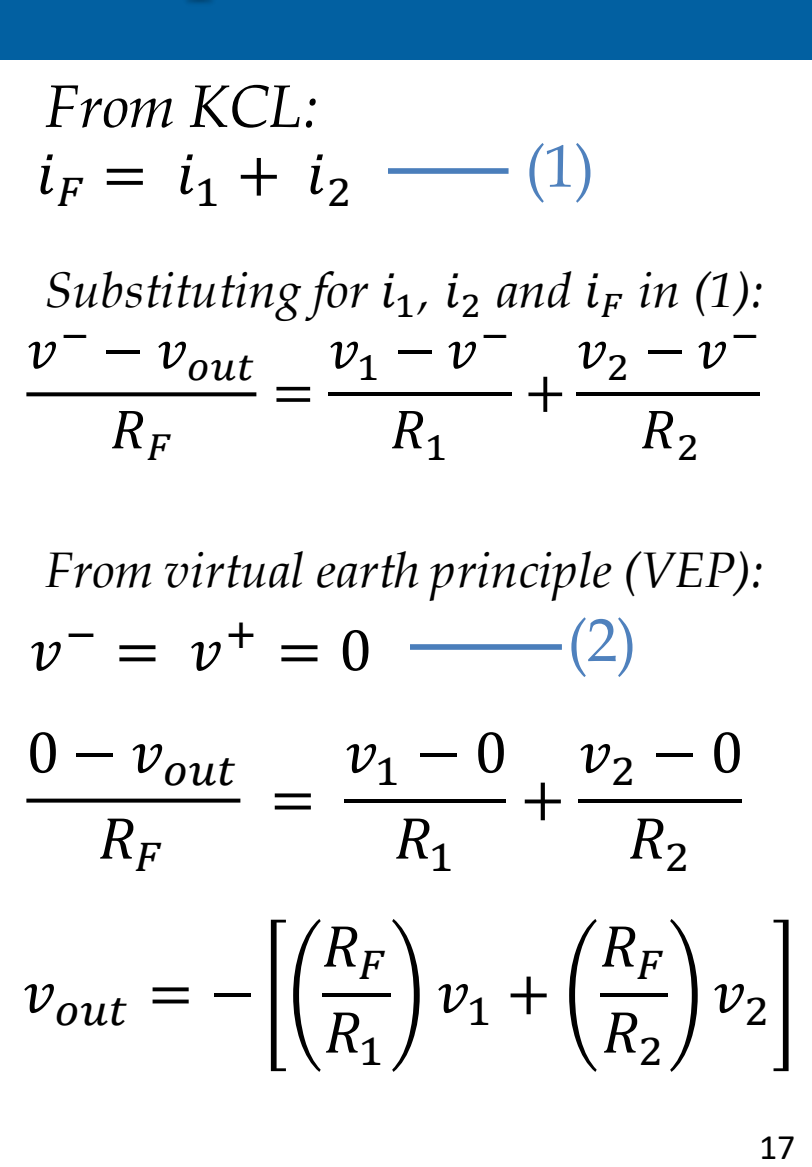
[picture p47: figure]
From KCL:; From virtual earth principle (VEP):; iiFF = ii1 + ii2 vv− − vvoooooo RRFF; vvoooooo = − RRFF RR1; RRFF RR2; 0 − vvoooooo RRFF

Substituting for ii1, ii2 and iiFF in (1):

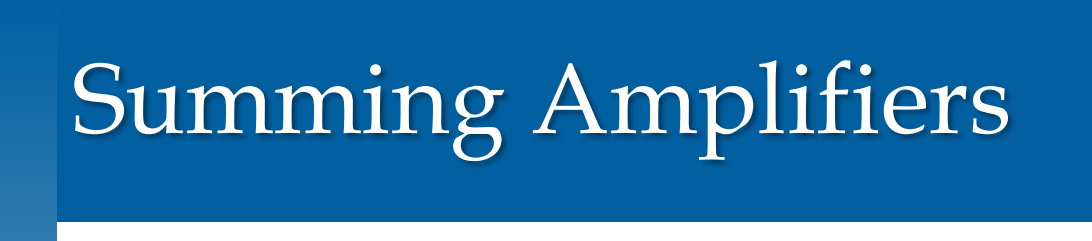
[picture p48: figure]
Summing Amplifiers

Prepared by Dulsha Kularatna-Abeywardana for ELECTENG 292

- Summing amplifiers can also be designed in the non-inverting configuration.
- These non-inverting summing amplifiers are useful when a phase-shift or inversion of the input is signal is undesirable.
- Summing amplifiers are used in:
– Digital to Analog Converters (DAC)
– Audio mixers

## Digital to Analog Converter (DAC)

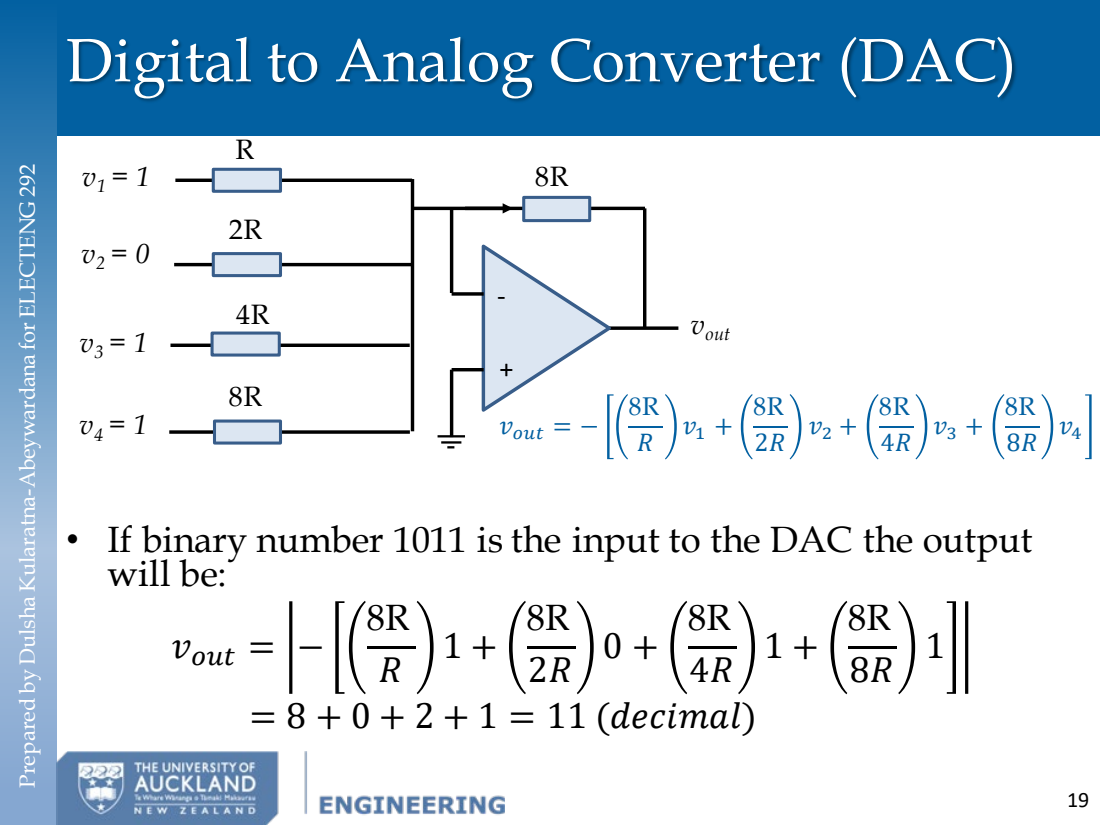
[picture p49: page 19]
vvoooooo = − 8R; = 8 + 0 + 2 + 1 = 11 (dddddd ); vout

Prepared by Dulsha Kularatna-Abeywardana for ELECTENG 292

• If binary number 1011 is the input to the DAC the output will be:

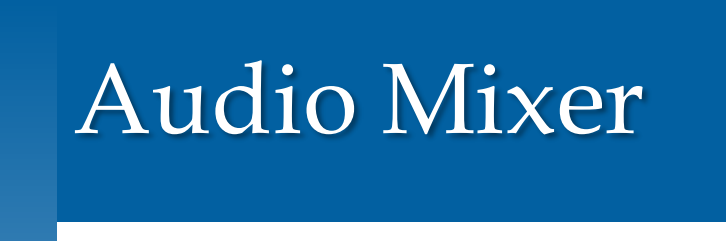
[picture p50: figure]
Audio Mixer

Prepared by Dulsha Kularatna-Abeywardana for ELECTENG 292

- Summing amplifiers are used for adding multiple signals in audio mixers.

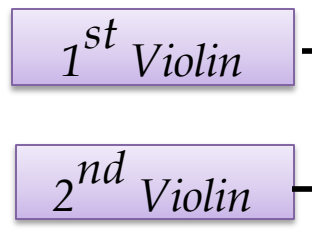
[picture p51: figure]
nd Violin; st Violin
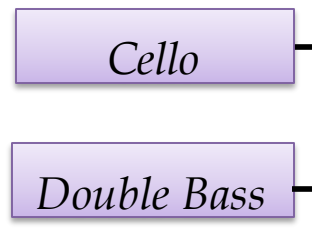
[picture p52: figure]
Double Bass; Cello

vout

RF

R1

+

R2

R3

R4

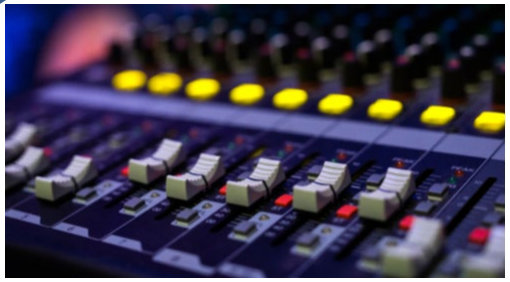
[picture p53: figure]

Image source: https://resources.pcb.cadence.com/blog/2020-summing-amplifierinversion-properties-and-op-amp-varieties (https://resources.pcb.cadence.com/blog/2020-summing-amplifier-inversion-properties-and-op-amp-varieties)

## Inverting Summing Amplifier: Example

# vv− = vv+= 0

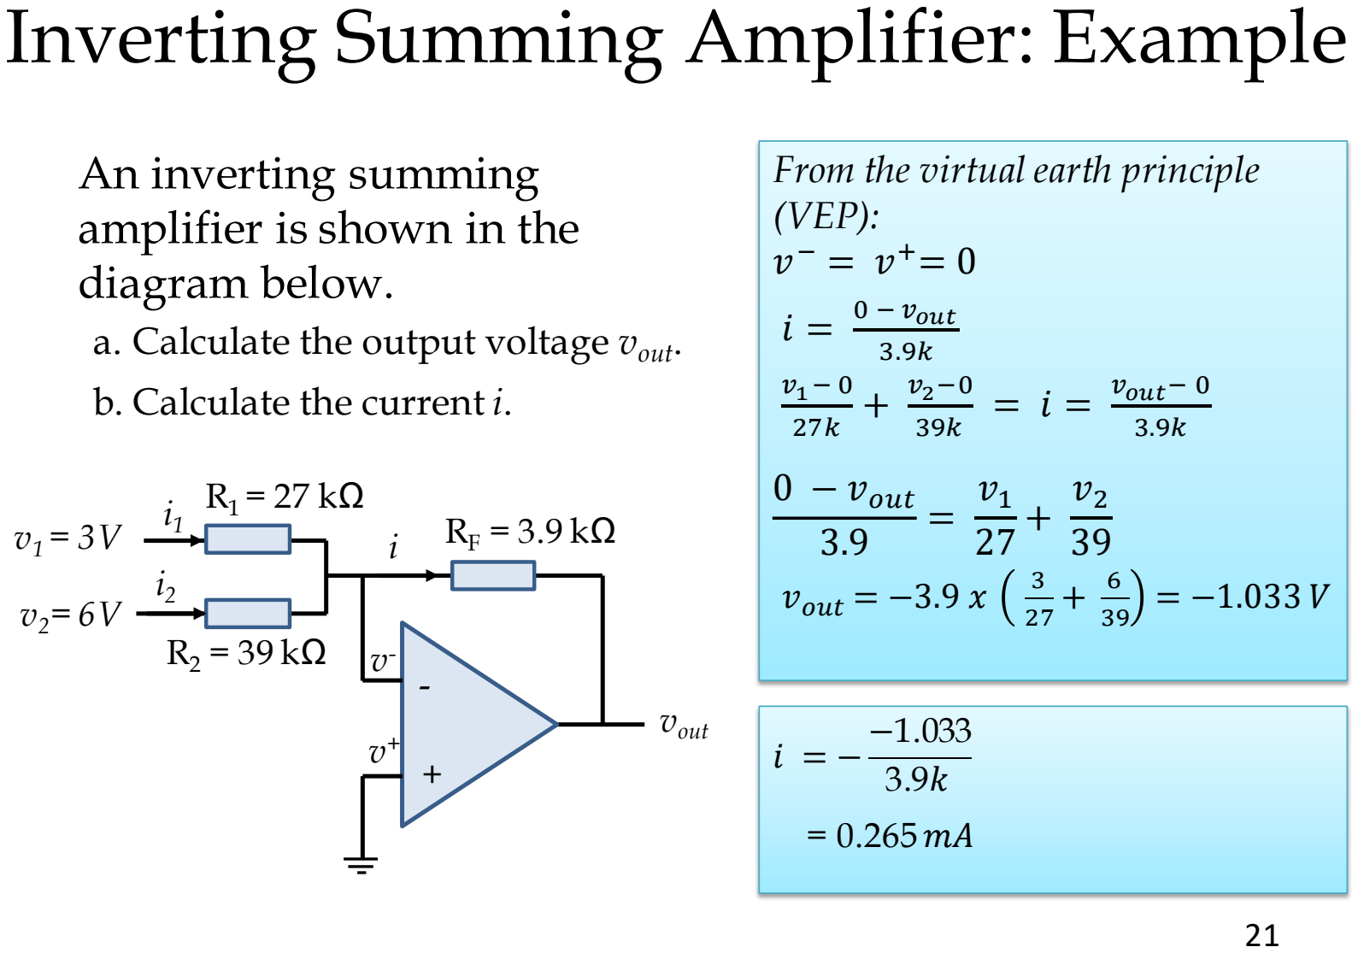
[picture p54: page 21]

An inverting summing
amplifier is shown in the
diagram below.
a. Calculate the output voltage vout.
b. Calculate the current i.

From the virtual earth principle (VEP):
ii =

# 0 − vvoooooo

3.9kk
vv1− 0
27kk

+ vv2−0
39kk

= ii =

# vvoooooo− 0

3.9kk

# 0 − vvoooooo

3.9

=

vv1
27 +

vv2
39

# vvoooooo = −3.9 xx

3
27

+ 6
39

= −1.033 VV

v-

v⁺

vout

RF = 3.9 kΩ

R1 = 27 kΩ

+

v2= 6V

v1 = 3V

R2 = 39 kΩ

i1
i2

i
ii = − −1.033
3.9kk

# = 0.265 mmAA

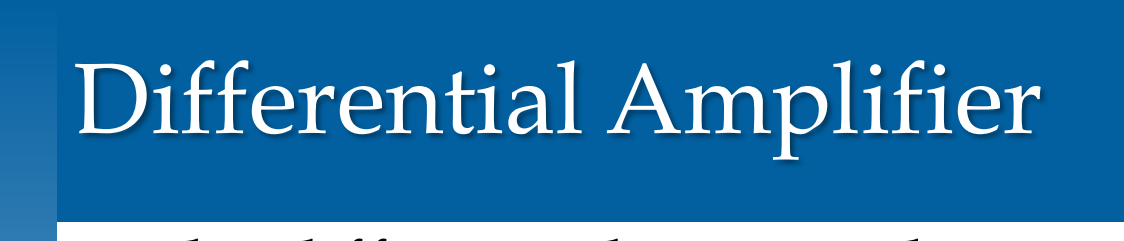
[picture p55: figure]
Differential Amplifier
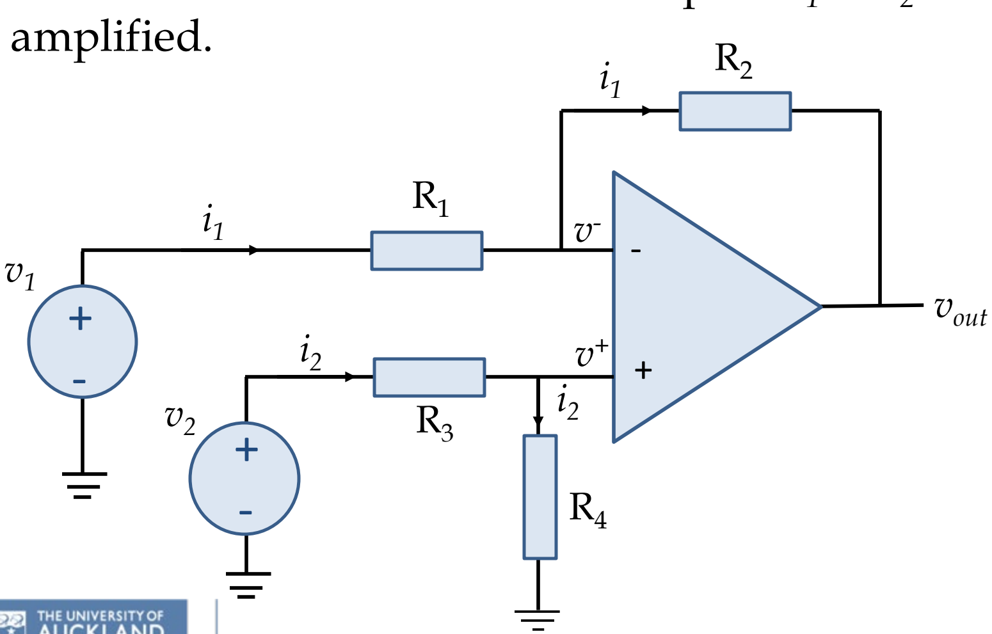
[picture p56: figure]
amplified.; vout

Prepared by Dulsha Kularatna-Abeywardana for ELECTENG 292

- The difference between the two inputs v1 & v2 is

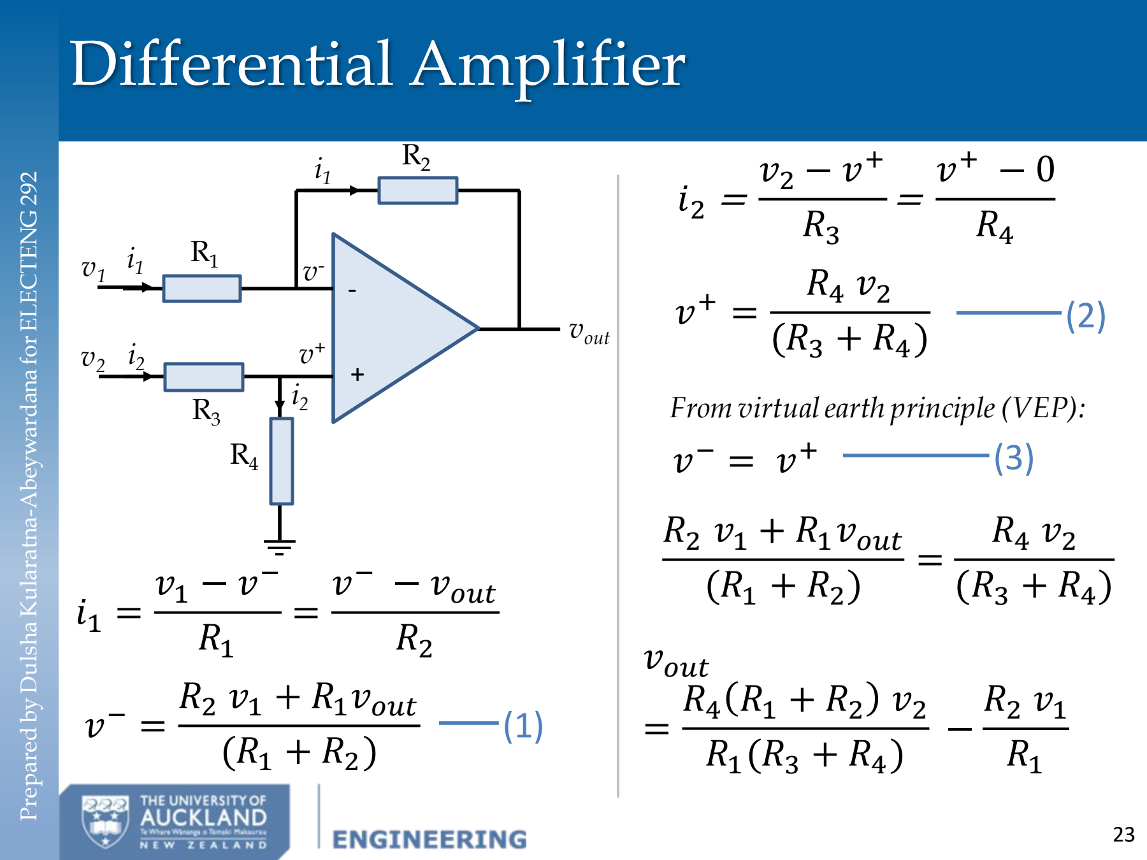
[picture p57: figure]
Differential Amplifier ii2 =; vv− − vvoooooo RR2; From virtual earth principle (VEP):; vout; RR2 vv1 + RR1vvoooooo (RR1 + RR2); vvoooooo =

Prepared by Dulsha Kularatna-Abeywardana for ELECTENG 292

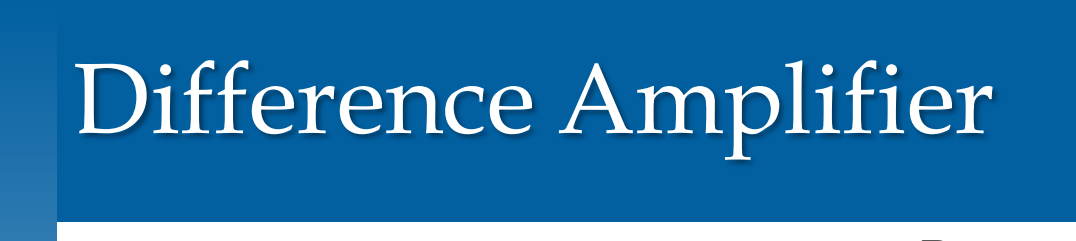
[picture p58: figure]
Difference Amplifier
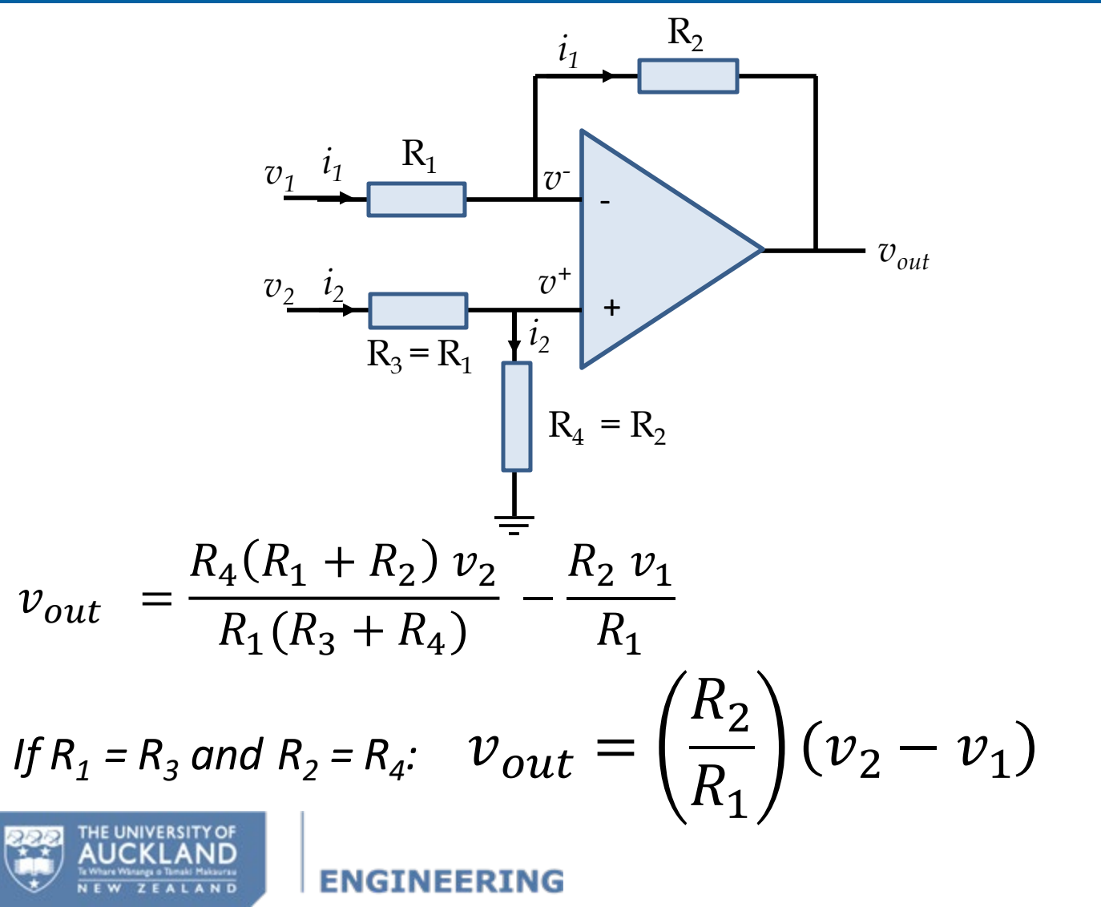
[picture p59: figure]
vout; 3 and R; vvoooooo

Prepared by Dulsha Kularatna-Abeywardana for ELECTENG 292

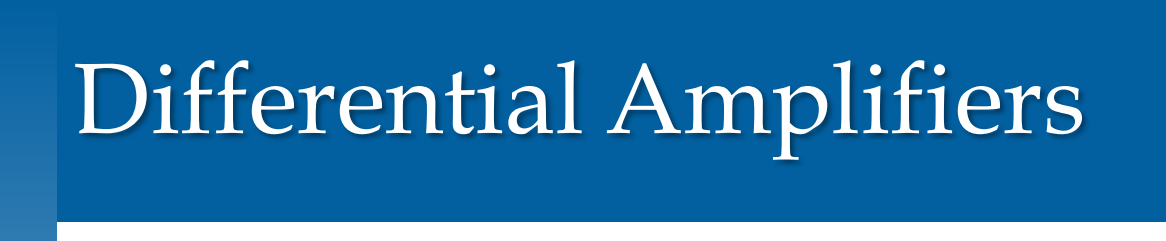
[picture p60: figure]
Differential Amplifiers

Prepared by Dulsha Kularatna-Abeywardana for ELECTENG 292

- Used to amplify the difference between two input voltages while suppressing any voltage common to the two inputs.
- These are used in:
– Noise suppression
– Instrumentation amplifiers – Motor control circuits
– Volume control circuits

## Differential Amplifier: Example

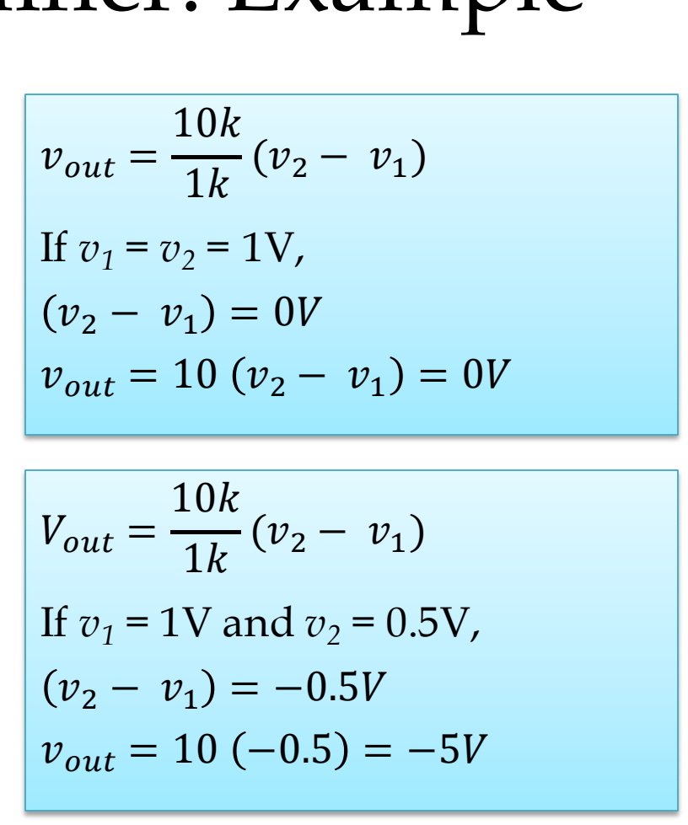
[picture p61: figure]
vooo =; vv2 − vv1 = 0VV vooo = 10 vv2 − vv1 = 0VV Vooo =; If v1 = 1V and v2 = 0.5V,; vv2 − vv1 = −0.5VV vooo = 10 −0.5 = −5VV

An operational amplifier
circuit is shown below:
a. If v1 = v2 = 1V, what is the output voltage?
b. If v1 = 1V and v2 = 0.5V, what will the output voltage be?

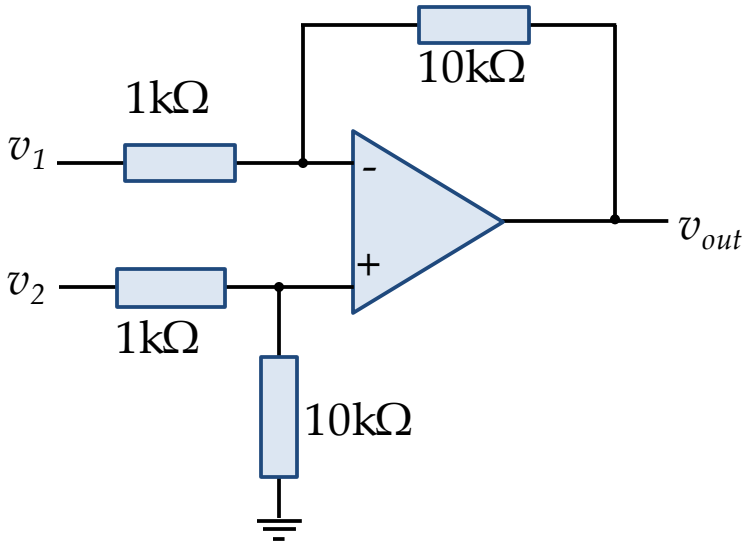
[picture p62: figure]
vout

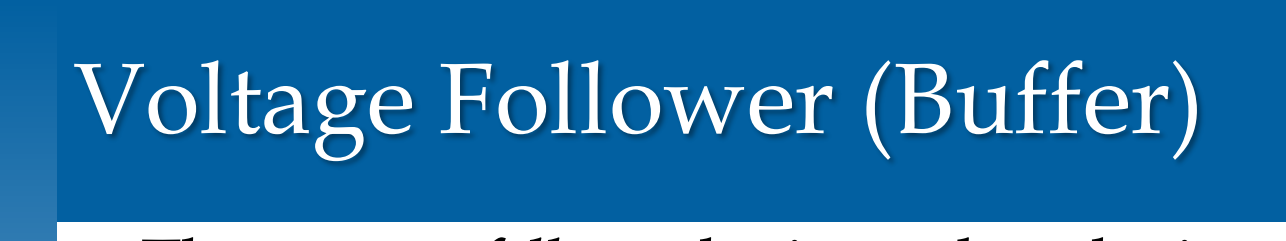
[picture p63: figure]
Voltage Follower (Buffer)

Prepared by Dulsha Kularatna-Abeywardana for ELECTENG 292

- The output followsthe input but the input signal does not get ‘loaded’ by the output stage, and to ensure that the output stage does not draw current from the input signal.
- Also referred to as unity-gain amplifier or buffer.
- Used to isolate input and output in a circuit.

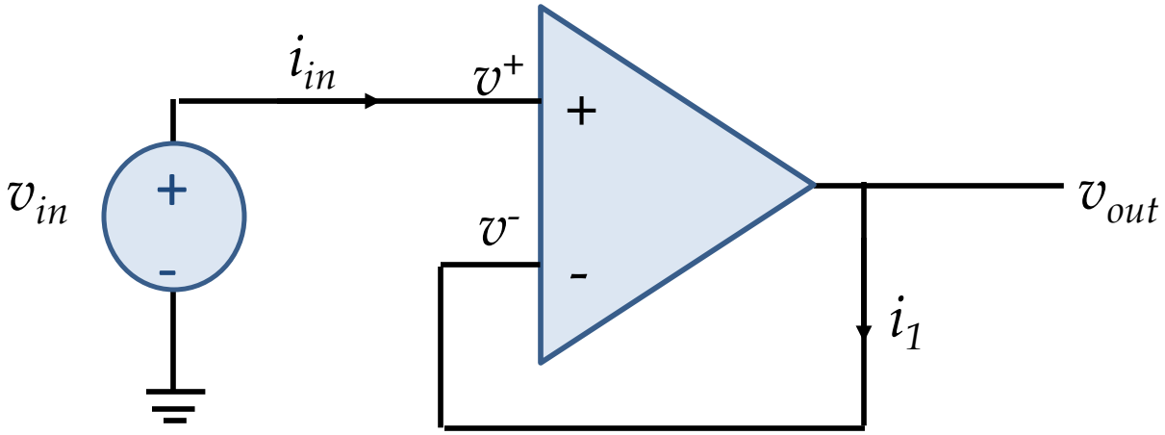
[picture p64: figure]
vout; vin; iin

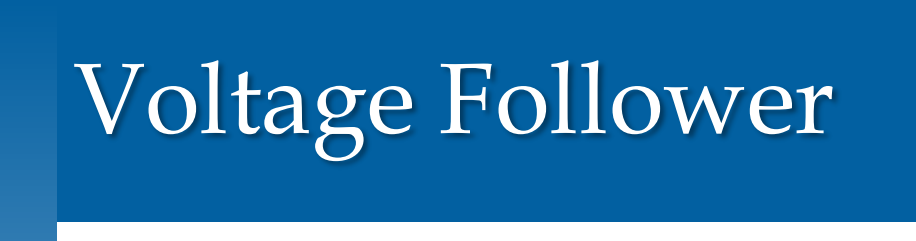
[picture p65: figure]
Voltage Follower

Prepared by Dulsha Kularatna-Abeywardana for ELECTENG 292

# iiiiii = 0

ii1 = 0

From virtual earth principle (VEP):

# vv− = vv+

(2)

# vv+ = vviiii

vout

+

vin

iin

i1

v⁺
v⁻

# vv− = vvoooooo

(1)

# vii = vooo

Due to infinite input impedance no current goes into the input terminals of op-amp:

## RRiiii =

vviiii
iiiiii

=

vviiii
0

= ∞

# RRoooooo = 0

Input & output resistances:

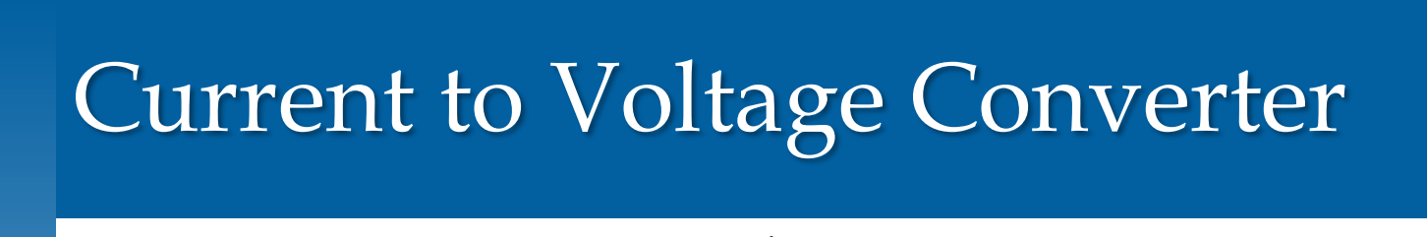
[picture p66: figure]
Current to Voltage Converter

Prepared by Dulsha Kularatna-Abeywardana for ELECTENG 292

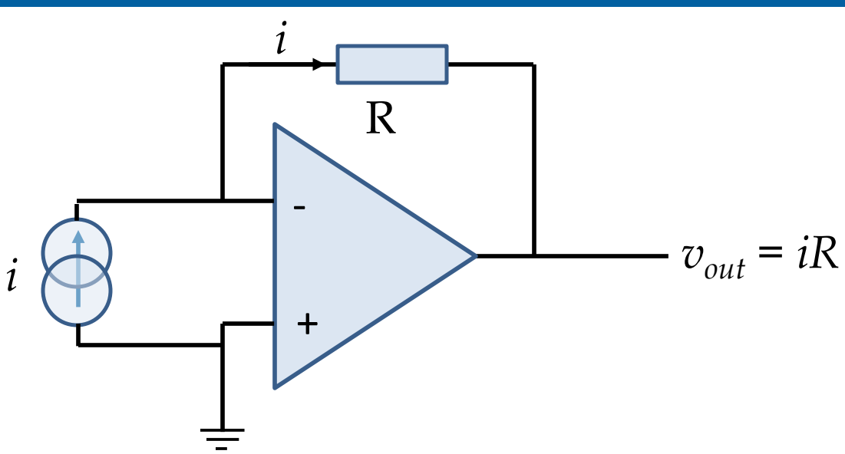
[picture p67: figure]
vout = iR

- If the resistance R is fixed vout is dependent on i.
- These are often used in photodetectors where light is turned to a current and then output as a voltage which is directly proportional to the current.

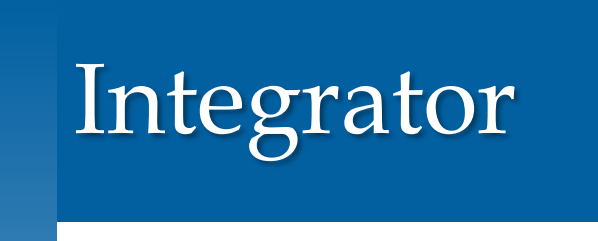
[picture p68: figure]
Integrator

Prepared by Dulsha Kularatna-Abeywardana for ELECTENG 292

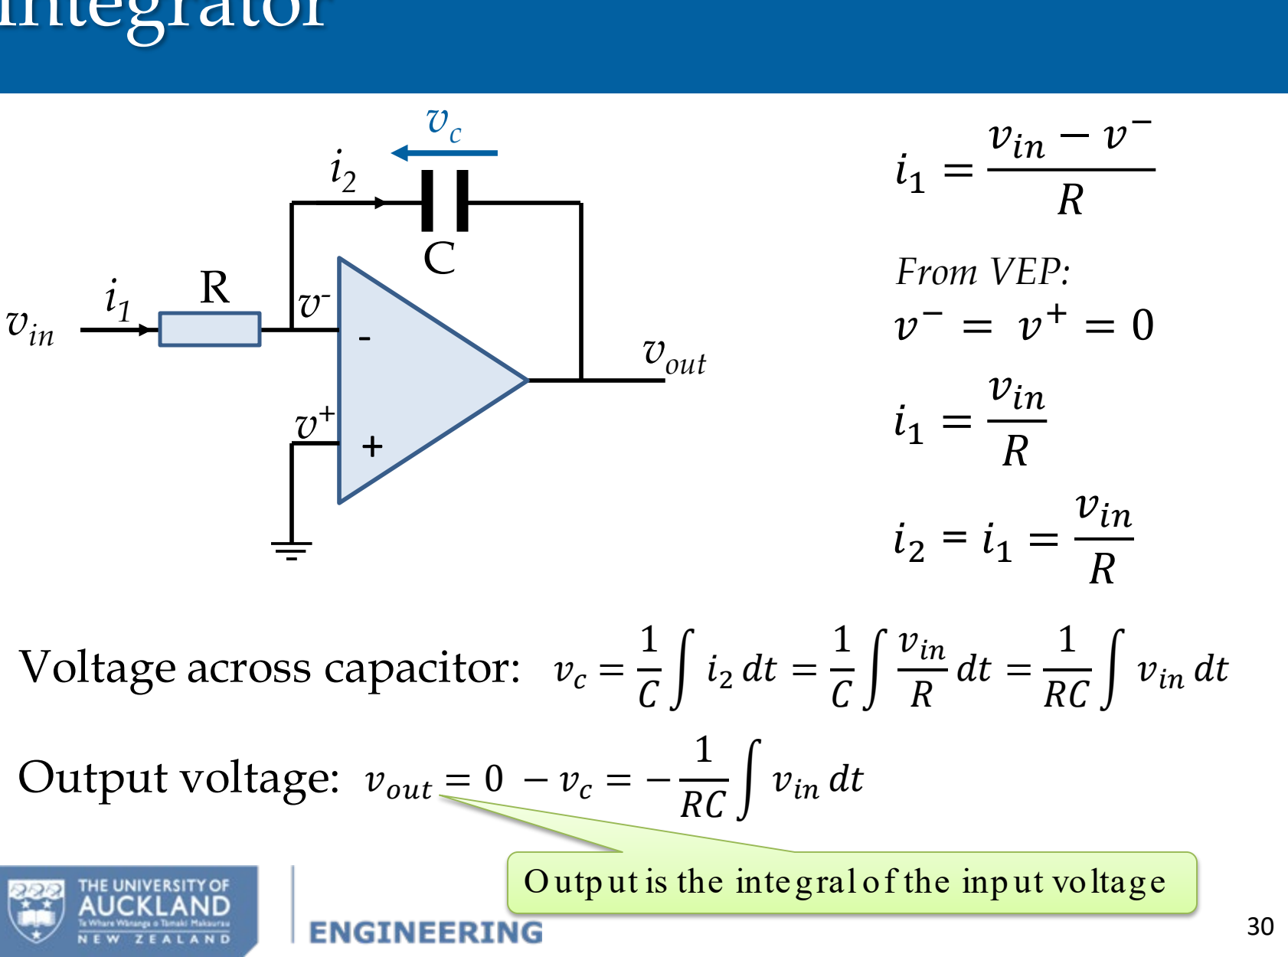
[picture p69: figure]
Voltage across capacitor:; Output voltage:; vout; vin; vviiii RR; vviiii − vv− RR; From VEP:; vvcc =; 1 CC  ii2 dddd =; CC  vviiii RR dddd =; 1 RRCC  vviiii dddd; vvoooooo = 0 − vvcc = − 1 RR  vviiii dddd

O utp ut is the integral of the inp ut voltage

## Integrator Waveforms

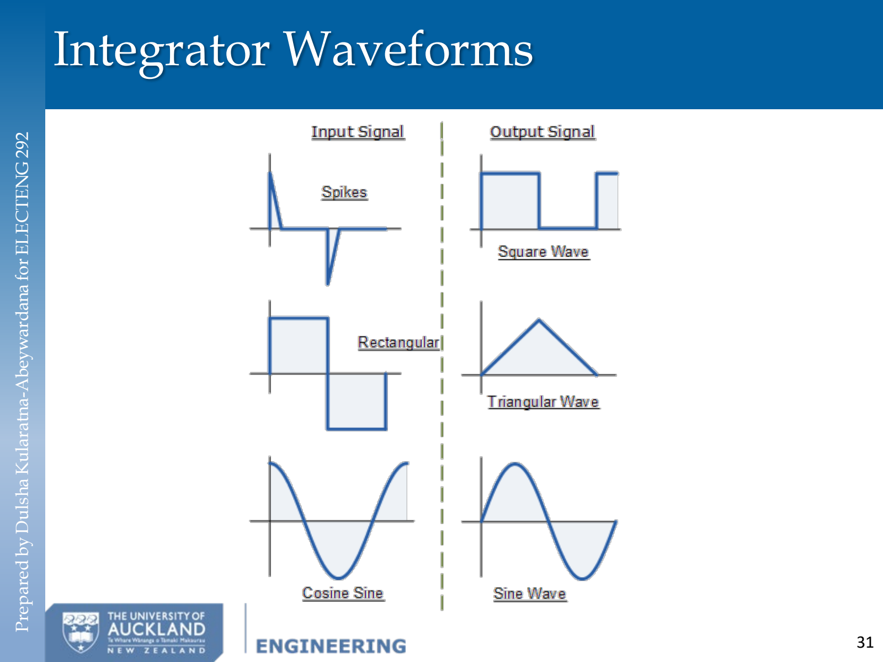
[picture p70: page 31]

Prepared by Dulsha Kularatna-Abeywardana for ELECTENG 292

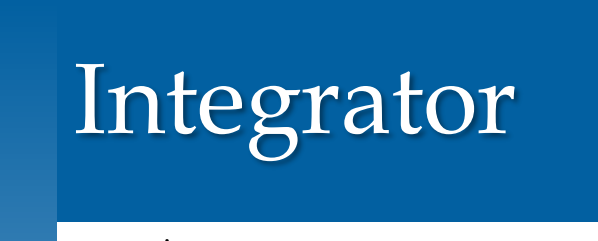
[picture p71: figure]
Integrator

Prepared by Dulsha Kularatna-Abeywardana for ELECTENG 292

- A square wave can be used to generate a triangular wave using this integrator circuit.
- If the input signal has a low frequency the capacitor may appear as an open circuit and then the opamp will behave as if it was in the open loop configuration.
- To avoid this in real integrators a resistor is connected in parallel with the capacitor.
- Op-amp integrating amplifiers are used in: – Calculus operations performers in analogue computers

– Analogue-to-digital converters
– Ramp generators
– Wave shaping applications

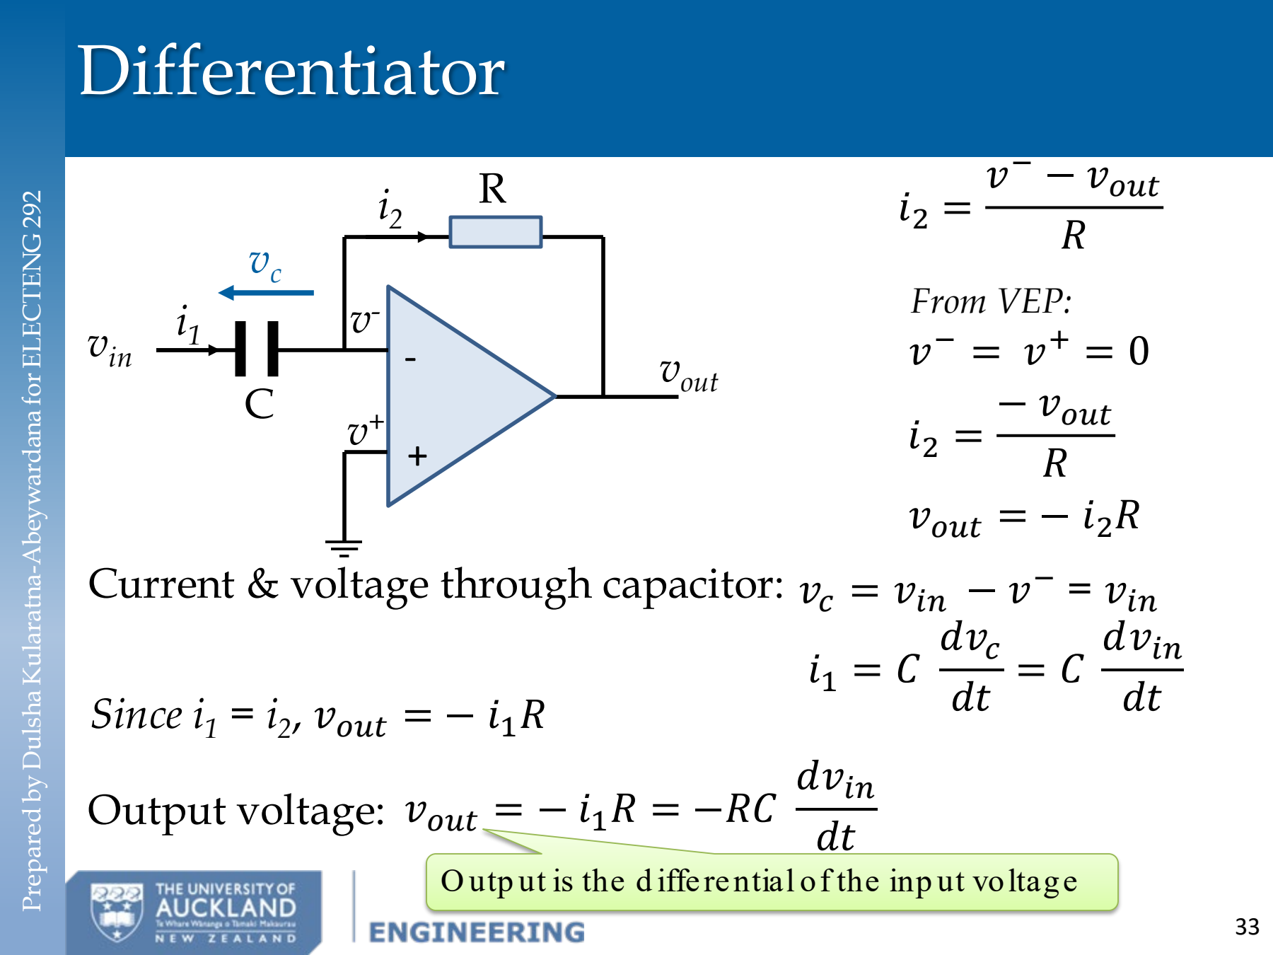
[picture p72: figure]
Differentiator; Current & voltage through capacitor:; vout C; vin; vvoooooo = − ii2RR; vv− − vvoooooo RR; From VEP:; vv− = vv+ = 0 ii2 = − vvoooooo RR; ddvvcc dddd; ddvviiii dddd; Output voltage:; vvcc = vviiii − vv− = vviiii; Since i1 = i2, vvoooooo = − ii1RR vvoooooo = − ii1RR = −RR

Prepared by Dulsha Kularatna-Abeywardana for ELECTENG 292

O utp ut is the d ifferential of the inp ut voltage

## Differentiator Waveforms

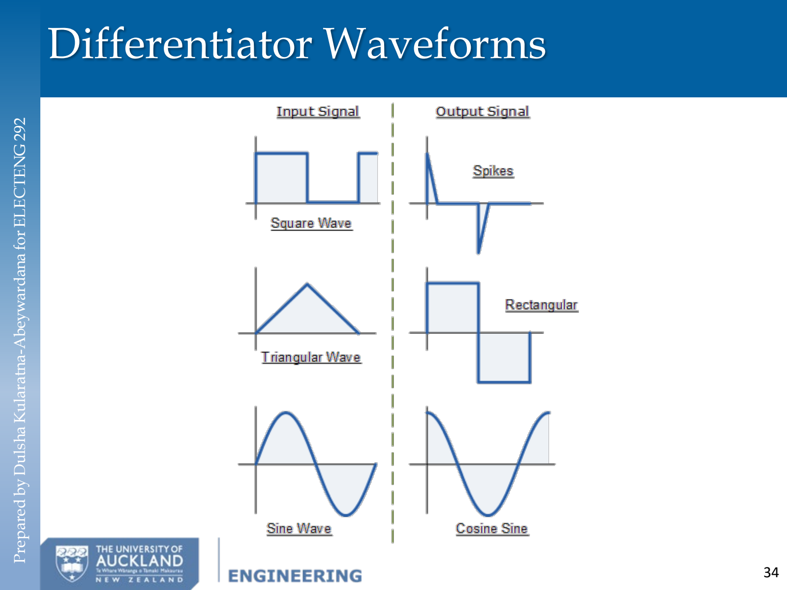
[picture p73: page 34]

Prepared by Dulsha Kularatna-Abeywardana for ELECTENG 292

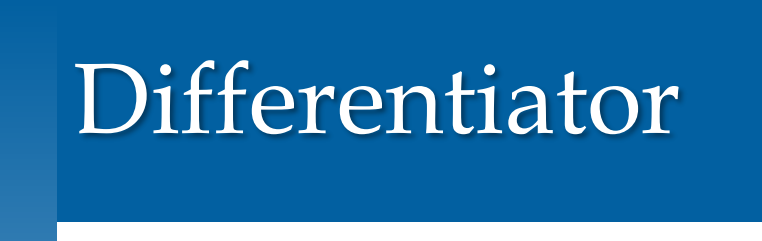
[picture p74: figure]
Differentiator

Prepared by Dulsha Kularatna-Abeywardana for ELECTENG 292

- One of the most widely used circuits.
- Essentially a high pass filter.
- It can be used as:
– Square wave generators for a triangle wave input – Wave shaping and signal processing circuits
– Calculation modules in analogue computers
– PID controllers
– rate-of-change detectors in frequency modulators
