Puthikunkim/capstone/compsys-team/ProjectResource/Lectures/positiveFeedbackLoop.pdf

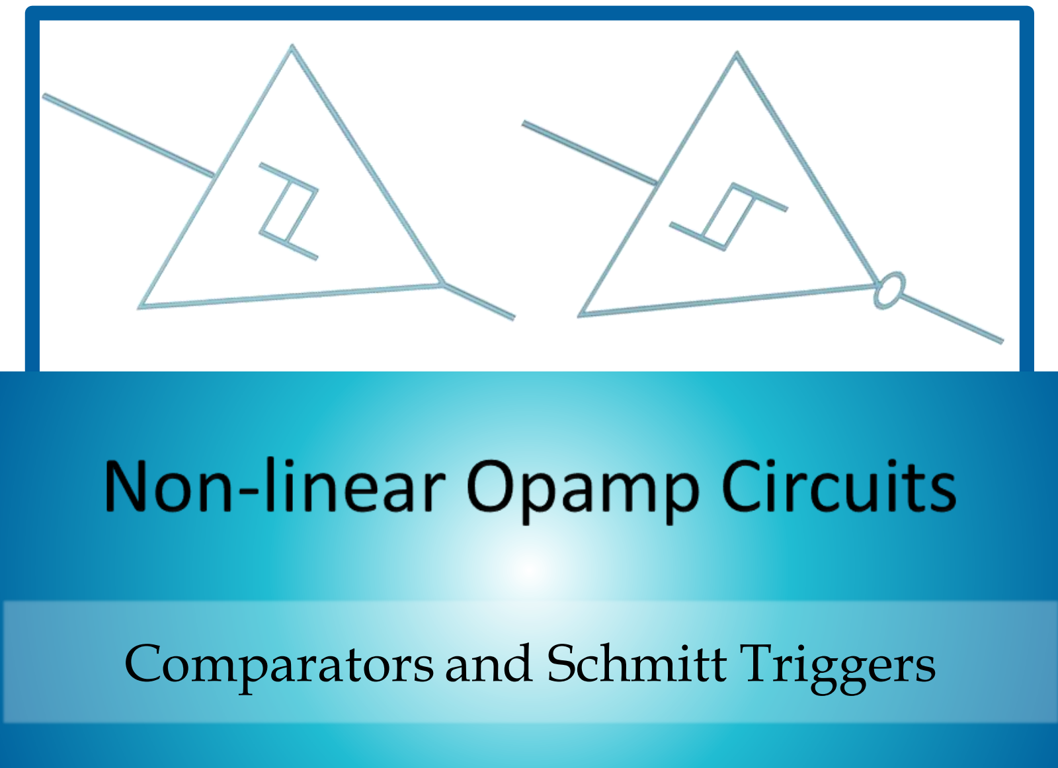
[picture p75: page 1]

# Comparators and Schmitt Triggers

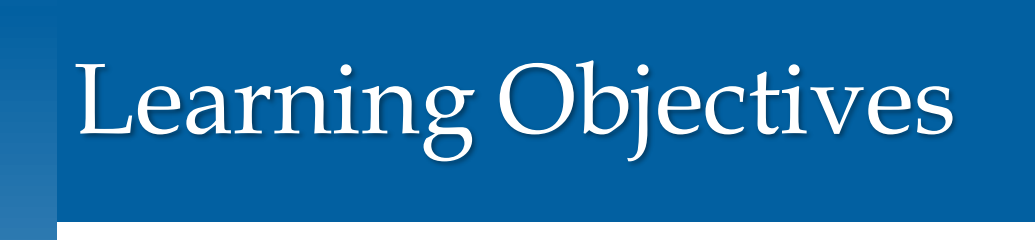
[picture p76: figure]
Learning Objectives

Prepared by Dulsha Kularatna-Abeywardana for ELECTENG 292

## - Understand the difference between linear and non-

linear opamp circuits.

## - Understand and analyse opamps used in the

positive feedback configuration.

## - Analyse and design Schmitt triggers and

comparators.

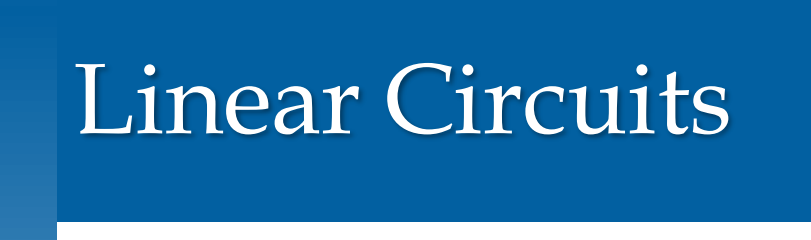
[picture p77: figure]
Linear Circuits

Prepared by Dulsha Kularatna-Abeywardana for ELECTENG 292

### - Linear circuits produce an output which is a linear

combination of its input signals.
- Linear circuit obey the superposition principle.
- They amplify and process electronic signals without distortion.
- The parameters of a linear circuit such as resistance,

### capacitance, inductance are constant and do not change with

respect to the voltage and current.

### - For example, if a sinusoidal input voltage or current of frequency f is applied at the input the steady-state output of

the circuit is also sinusoidal with frequency f.
- Linear circuit examples: Amplifiers, differentiators, integrators, linear electronic filters etc.

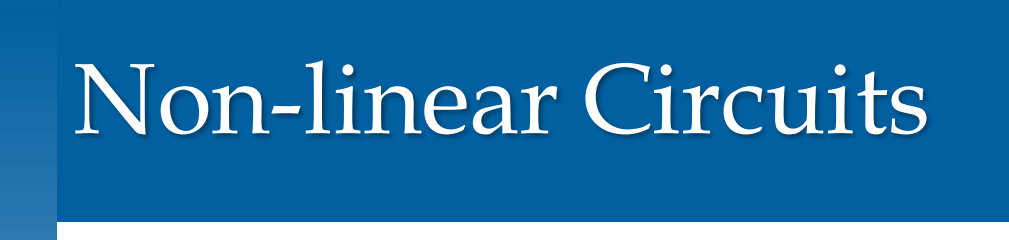
[picture p78: figure]
Non-linear Circuits

Prepared by Dulsha Kularatna-Abeywardana for ELECTENG 292

- A nonlinear circuit’s parameters such as resistance,

### inductance, capacitance, waveform and frequency are varied

with respect to current and voltage and do not stay constant.
- Non-linear circuit can shape (or distort) an input signal, whether sinusoidal or not.

### - Significant in both the frequency and time domains in circuits

with saturation and feedback.

### - For example, if a sinusoidal input voltage or current of frequency f is applied at the input the steady-state output

cannot be expected to also be a sinusoidal with frequency f.
- Non-linear circuit examples: Schmitt triggers, comparators,

### modulators, rectifiers, radio receiver detectors, digital logic

circuits.

# Opamp Feedback Types

## - Feedback loop between output and input can be

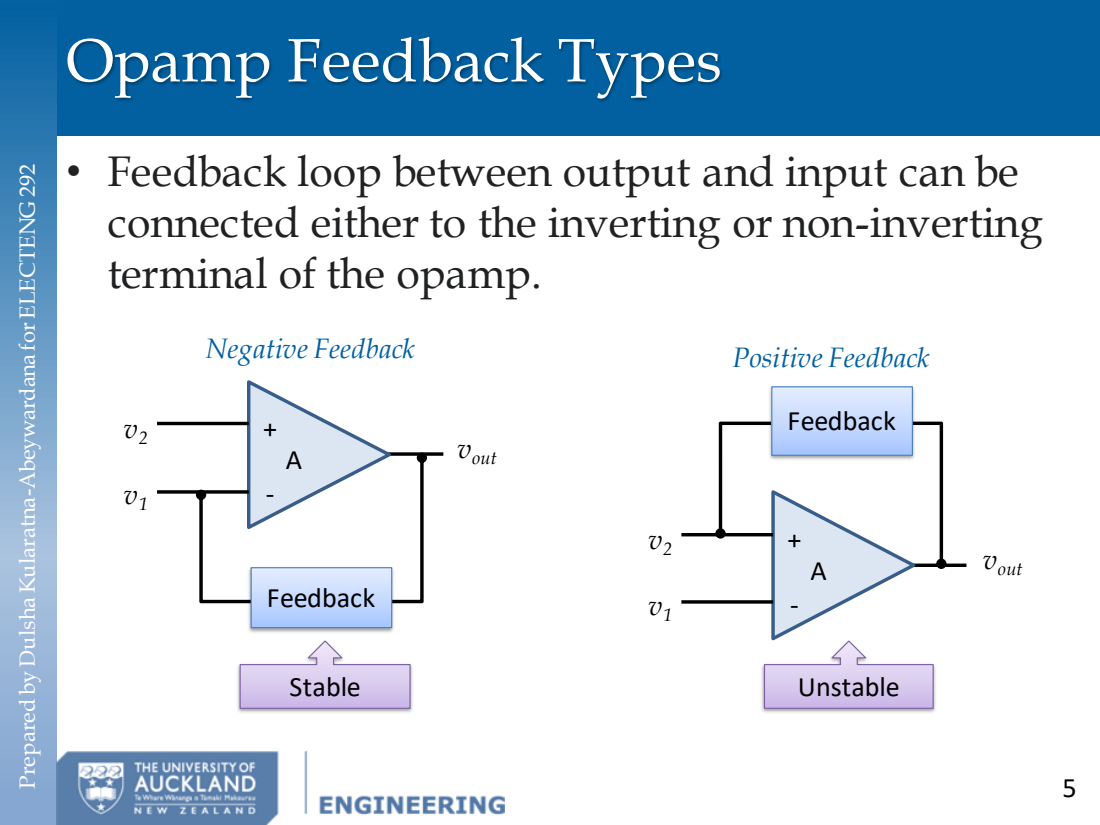
[picture p79: page 5]
vout; Feedback; Negative Feedback; Positive Feedback; Stable; Unstable

Prepared by Dulsha Kularatna-Abeywardana for ELECTENG 292
connected either to the inverting or non-inverting
terminal of the opamp.

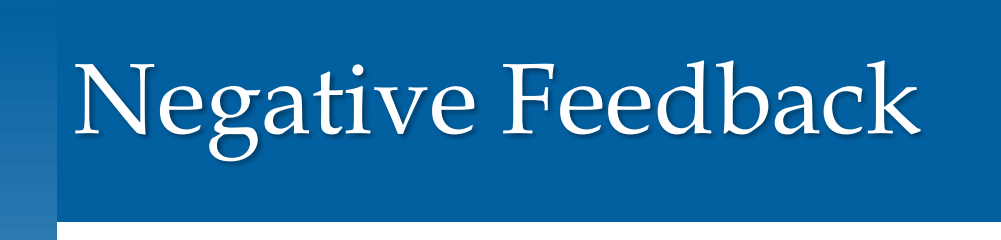
[picture p80: figure]
Negative Feedback

Prepared by Dulsha Kularatna-Abeywardana for ELECTENG 292

- Negative feedback allows to create all these practical circuits, with precisely set gains, rates, and other significant parameters.

### - Negative feedback makes these circuits stable and self-

correcting.

### - The basic principle of negative feedback is that the output is

driven to equilibrium (balance).

### - With negative feedback, the output voltage “fed back” to the inverting input, the circuit tends to prevent itself from driving the output to full saturation and instead drives the output voltage only as high or as low as needed to balance the two

inputs’ voltages.

### - All opamp circuits we analysed so far have been in the negative

feedback arrangement.

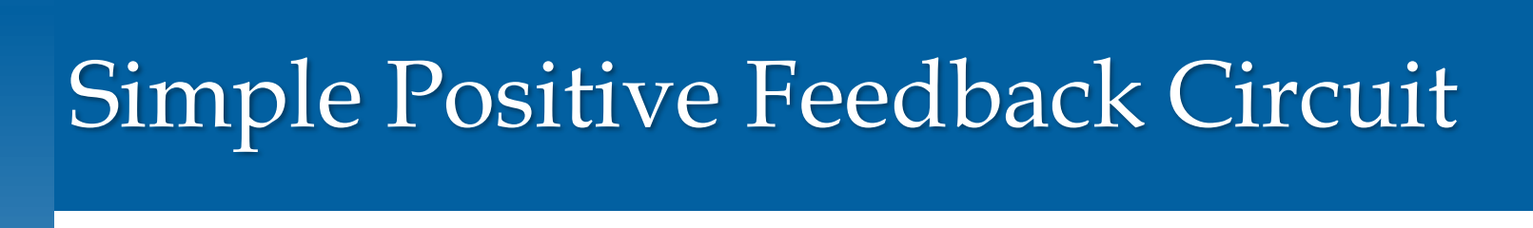
[picture p81: figure]
Simple Positive Feedback Circuit

Prepared by Dulsha Kularatna-Abeywardana for ELECTENG 292

- The output voltage is fed back to the noninverting input in a back and forth iterative process, which will result in full positive output saturation.
- Similarly if the noninverting input starts out negative the op-amp’s output will be driven to negative saturation.
- This is a bistable stable circuit with two possible states (saturated positive or saturated negative).
- Once the output reaches one of those saturated states, it will remain unchanged.

vout

+

v

+

v

- Connecting a straight piece of wire from output to the non-inverting input.
- Inverting input is disconnected from the feedback loop, and can be connected to any external voltage.
- If the non-inverting input voltage becomes positive, the op-amp will drive its output positive as well as the opamp internally makes vout = A (v

+ − v

−).

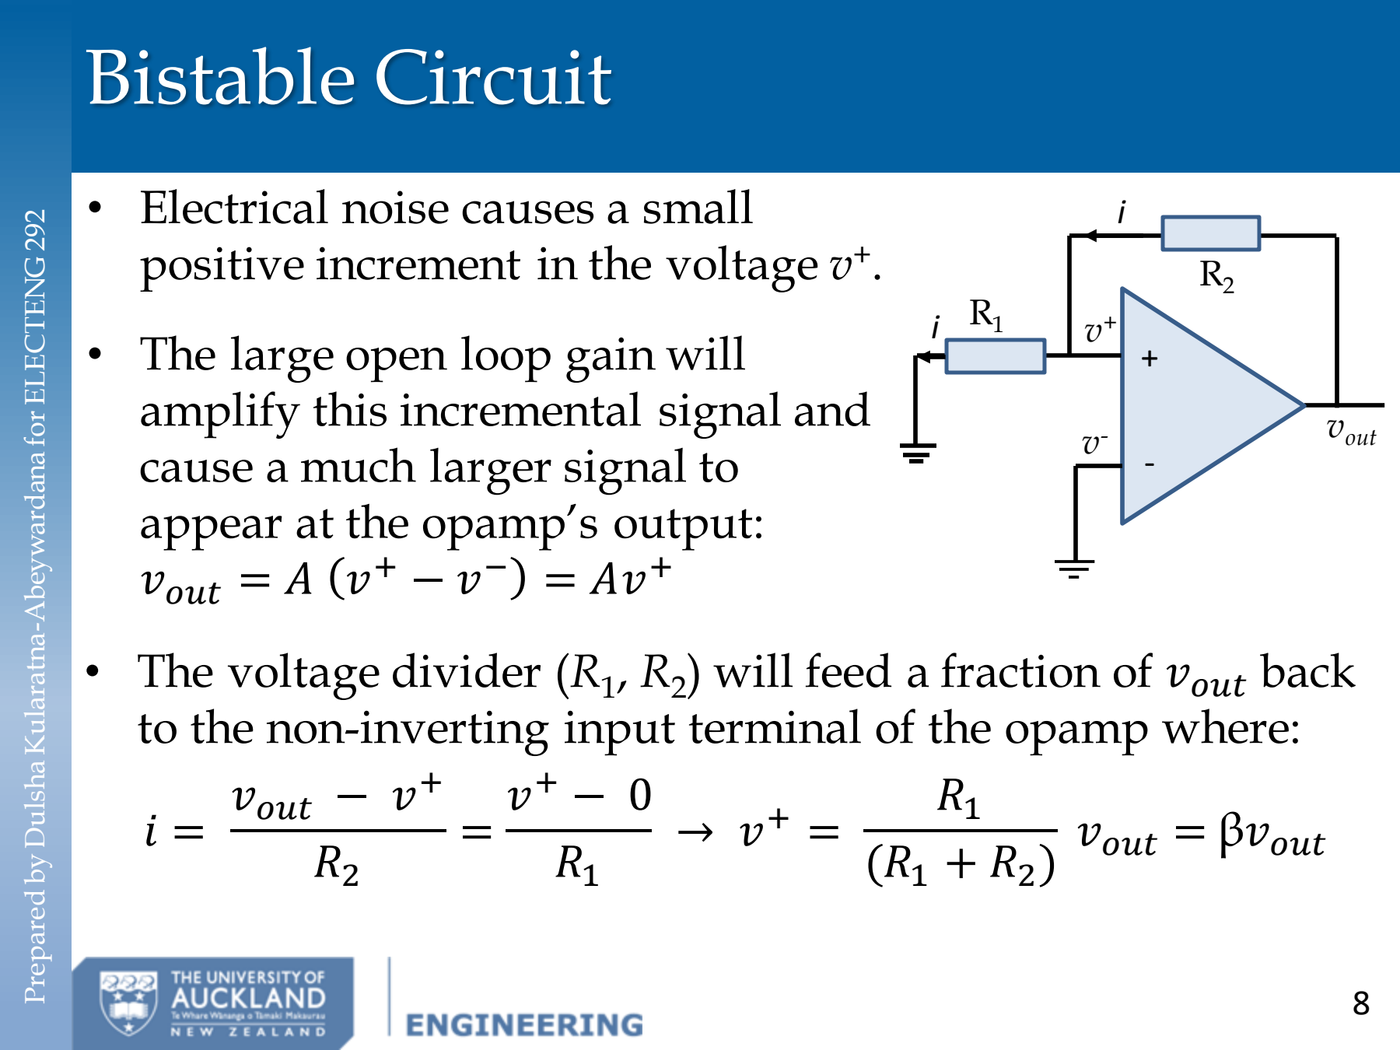
[picture p82: figure]
Bistable Circuit; • The voltage divider (R1 , R2; ) will feed a fraction of vout back; vout − v; vout = βvout; vout; • Electrical noise causes a small positive increment in the voltage v; • The large open loop gain will amplify this incremental signal and cause a much larger signal to appear at the opamp’s output: vout = A v

Prepared by Dulsha Kularatna-Abeywardana for ELECTENG 292

## to the non-inverting input terminal of the opamp where:

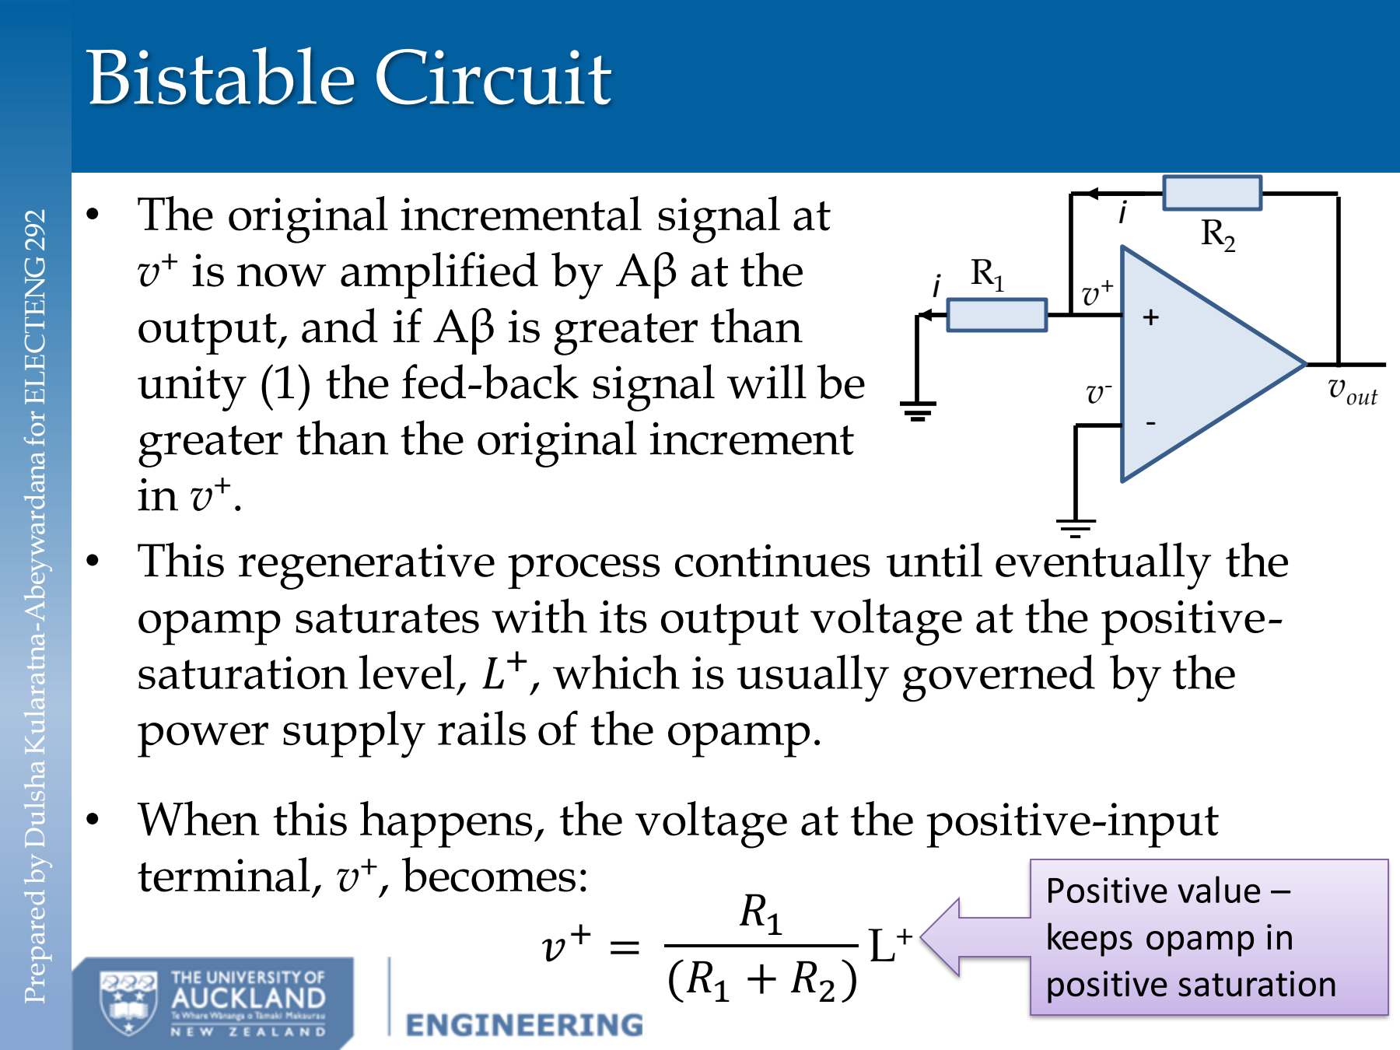
[picture p83: figure]
Bistable Circuit; saturation level, L; +, which is usually governed by the power supply rails of the opamp.; terminal, v; +, becomes:; Positive value – keeps opamp in positive saturation; • The original incremental signal at v; + is now amplified by Aβ at the output, and if Aβ is greater than unity (1) the fed-back signal will be greater than the original increment in v; vout

Prepared by Dulsha Kularatna-Abeywardana for ELECTENG 292

## - This regenerative process continues until eventually the

### opamp saturates with its output voltage at the positive-

### - When this happens, the voltage at the positive-input

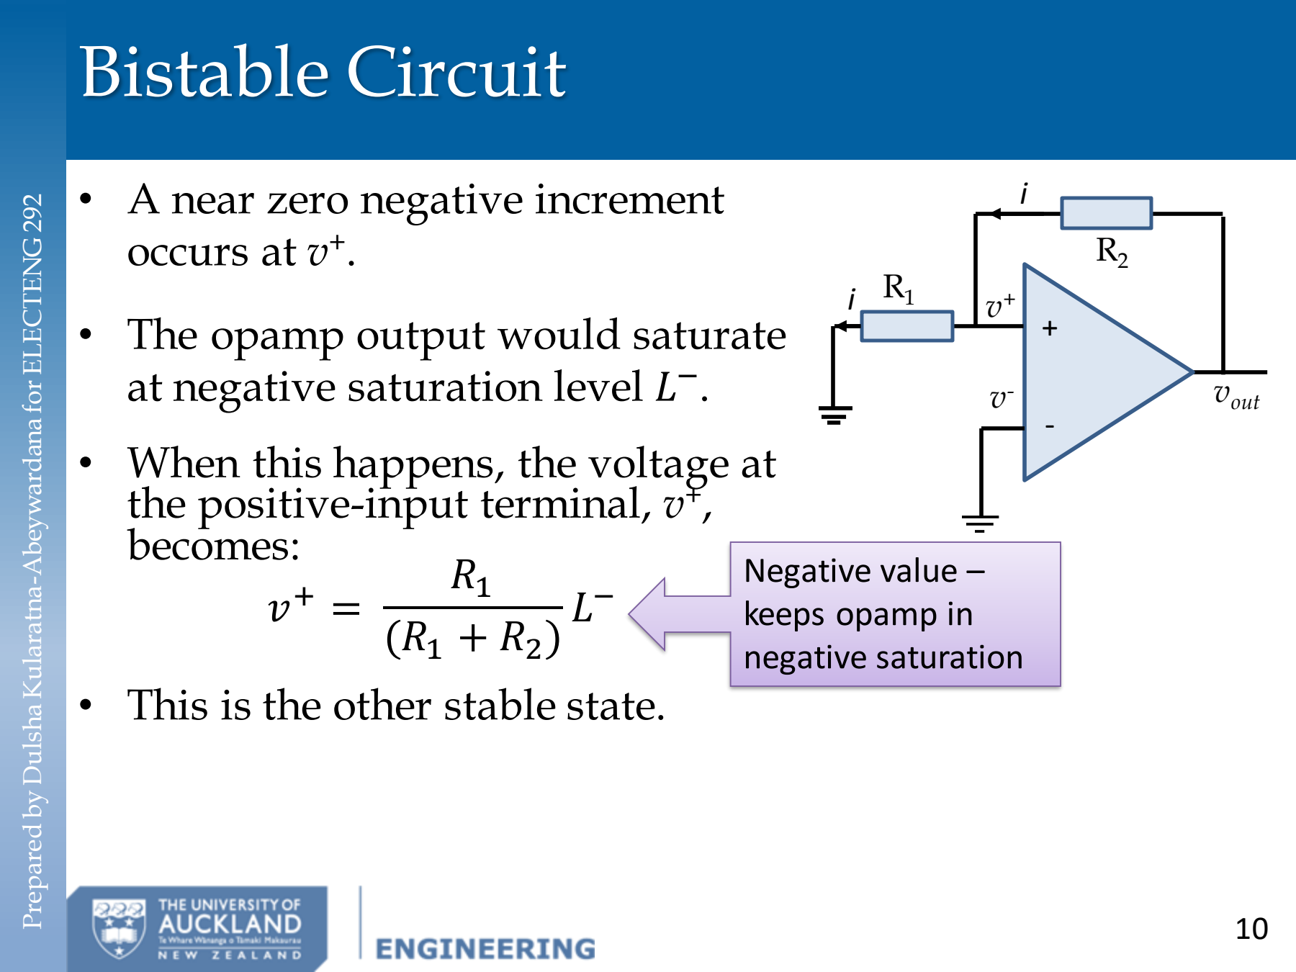
[picture p84: figure]
Bistable Circuit; • A near zero negative increment occurs at v; • The opamp output would saturate at negative saturation level L; • When this happens, the voltage at the positive-input terminal, v; becomes: v; • This is the other stable state.; Negative value – keeps opamp in negative saturation; vout

Prepared by Dulsha Kularatna-Abeywardana for ELECTENG 292

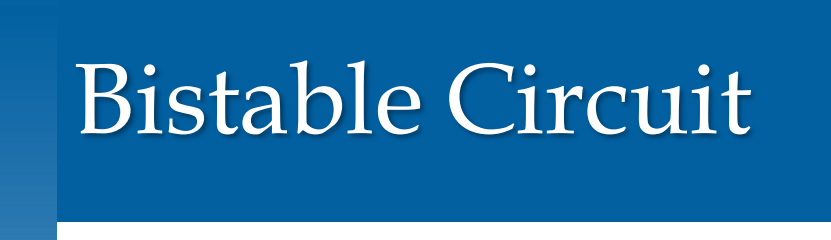
[picture p85: figure]
Bistable Circuit

Prepared by Dulsha Kularatna-Abeywardana for ELECTENG 292

### - The circuit can exist in either of these two states

indefinitely.

## - Circuit cannot exist in the state for which v

## + = 0 and vout = 0

for any length of time.

### - This state of unstable equilibrium (also known as a

## metastable state) can be easily driven into one of the two

stable states by any disturbance, such as electrical noise.

## - In negative feedback circuits a virtual short circuit appears

### between the op amp’s input terminals and maintains this

virtual short circuit in the face of disturbances.

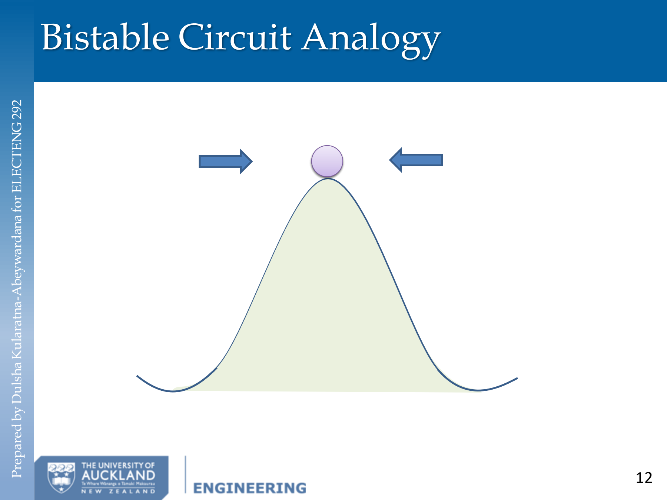
[picture p86: figure]
Bistable Circuit Analogy

Prepared by Dulsha Kularatna-Abeywardana for ELECTENG 292

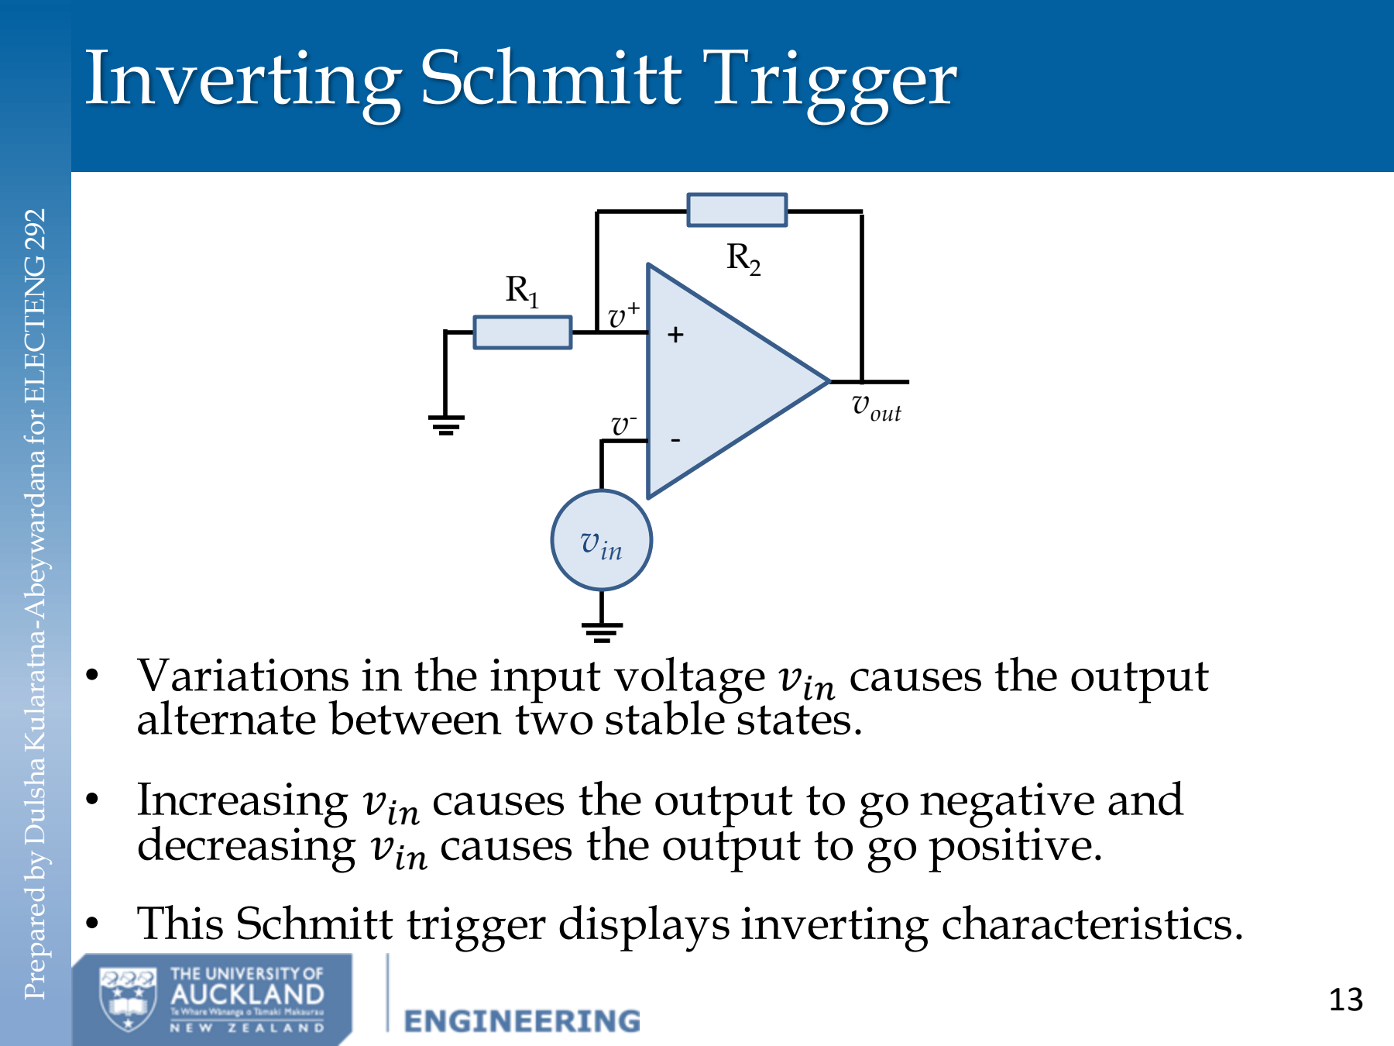
[picture p87: figure]
Inverting Schmitt Trigger; alternate between two stable states.; vout; vin

Prepared by Dulsha Kularatna-Abeywardana for ELECTENG 292

### - Variations in the input voltage vin causes the output

## - Increasing vin causes the output to go negative and

decreasing vin causes the output to go positive.

- This Schmitt trigger displays inverting characteristics.

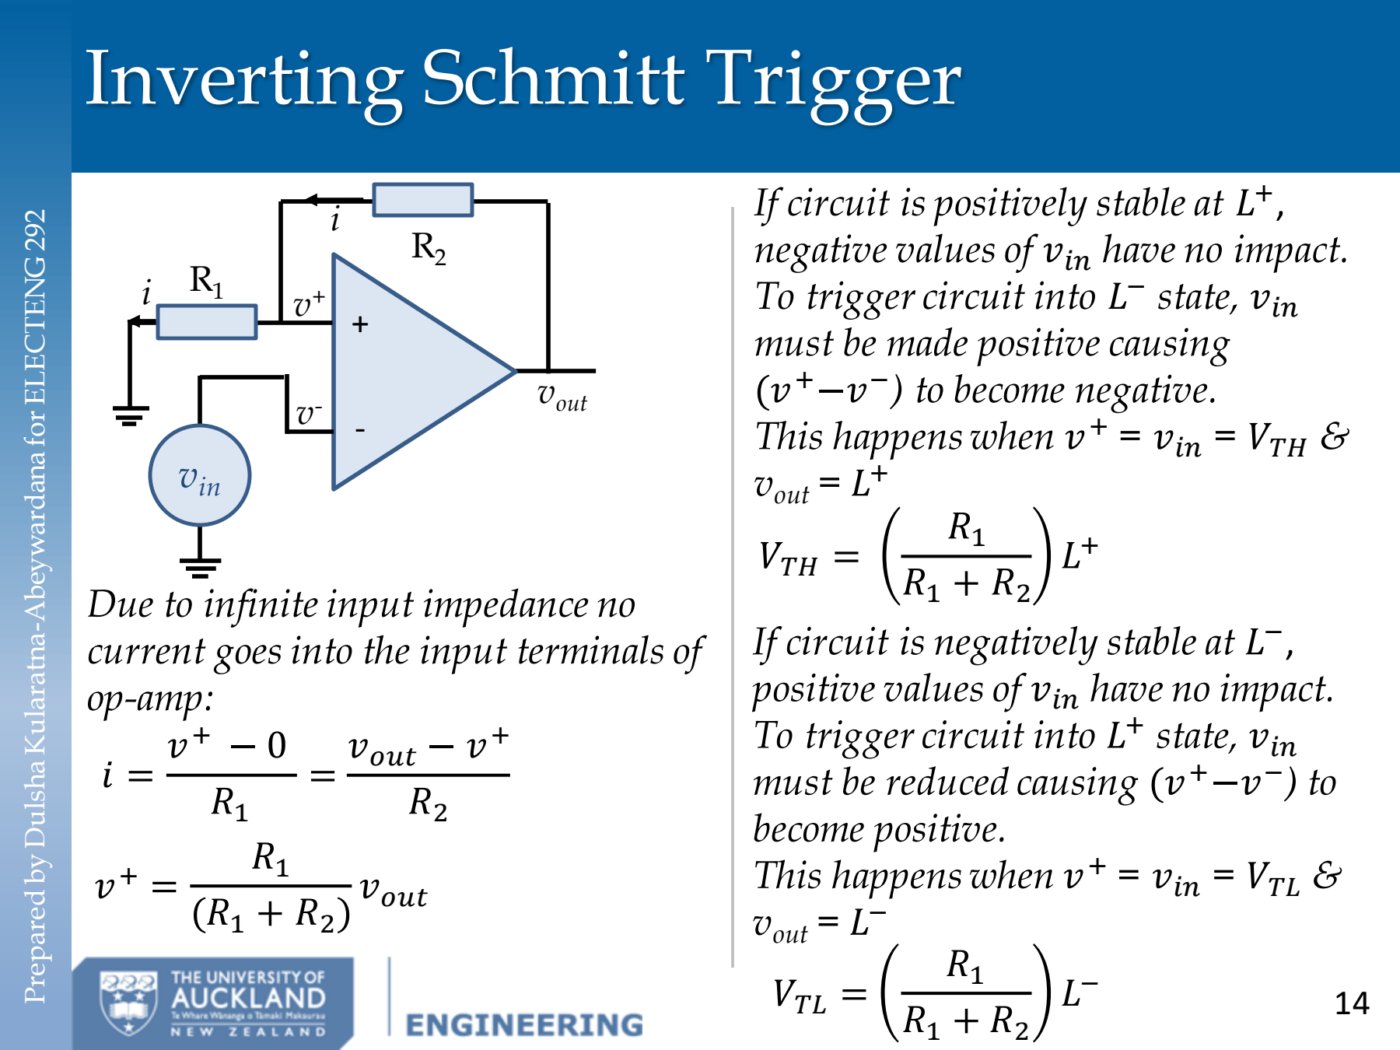
[picture p88: figure]
Inverting Schmitt Trigger; vout − v; Due to infinite input impedance no; op-amp:; vout; If circuit is positively stable at L; , negative values of vin have no impact. To trigger circuit into L; − state, vin must be made positive causing (v; −) to become negative. This happens when v; + = vin = VTH &; vout = L; VTH =; If circuit is negatively stable at L; −, positive values of vin have no impact. To trigger circuit into L; + state, vin must be reduced causing (v; become positive. This happens when v; + = vin = VTL &; VTL =; vin

Prepared by Dulsha Kularatna-Abeywardana for ELECTENG 292

current goes into the input terminals of

Prepared by Dulsha Kularatna-Abeywardana for ELECTENG 292

vout

vin

# Transfer Characteristics

- Assume vout is at one of its two possible levels, L

+, and thus v

+ = βL

+.

- As vin is gradually increased beyond v

+(= βL

+) the differential input to the opamp becomes negative and causes the output to become negative according to: vout = A v

+ − v

− .

- The voltage divider then causes v+ to go negative, thus increasing the net negative input to the opamp and keeps the regenerative process going.
- Opamp output saturates at L

−, and thus v

+ = βL

−.

- Increasing vin further has no impact on the circuit’s behaviour.

vout

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
Prepared by Dulsha Kularatna-Abeywardana for ELECTENG 292

vout

vin

# Transfer Characteristics

- vout is now in its negative saturation level, L

−, and thus v

+ = βL

−.

- As vin is gradually decreased beyond v

+(= βL

−) the differential input to the opamp becomes positive and causes the output to become positive according to: vout = A v

+ − v

− .

- The voltage divider then causes v+ to go positive, thus increasing the net positive input to the opamp and keeps the regenerative process going.
- Opamp output saturates at L

+, and thus v

+ = βL

+.

- Decreasing vin further has no impact on the circuit’s behaviour.

L

+

L

−

VTL | VTH

vout

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
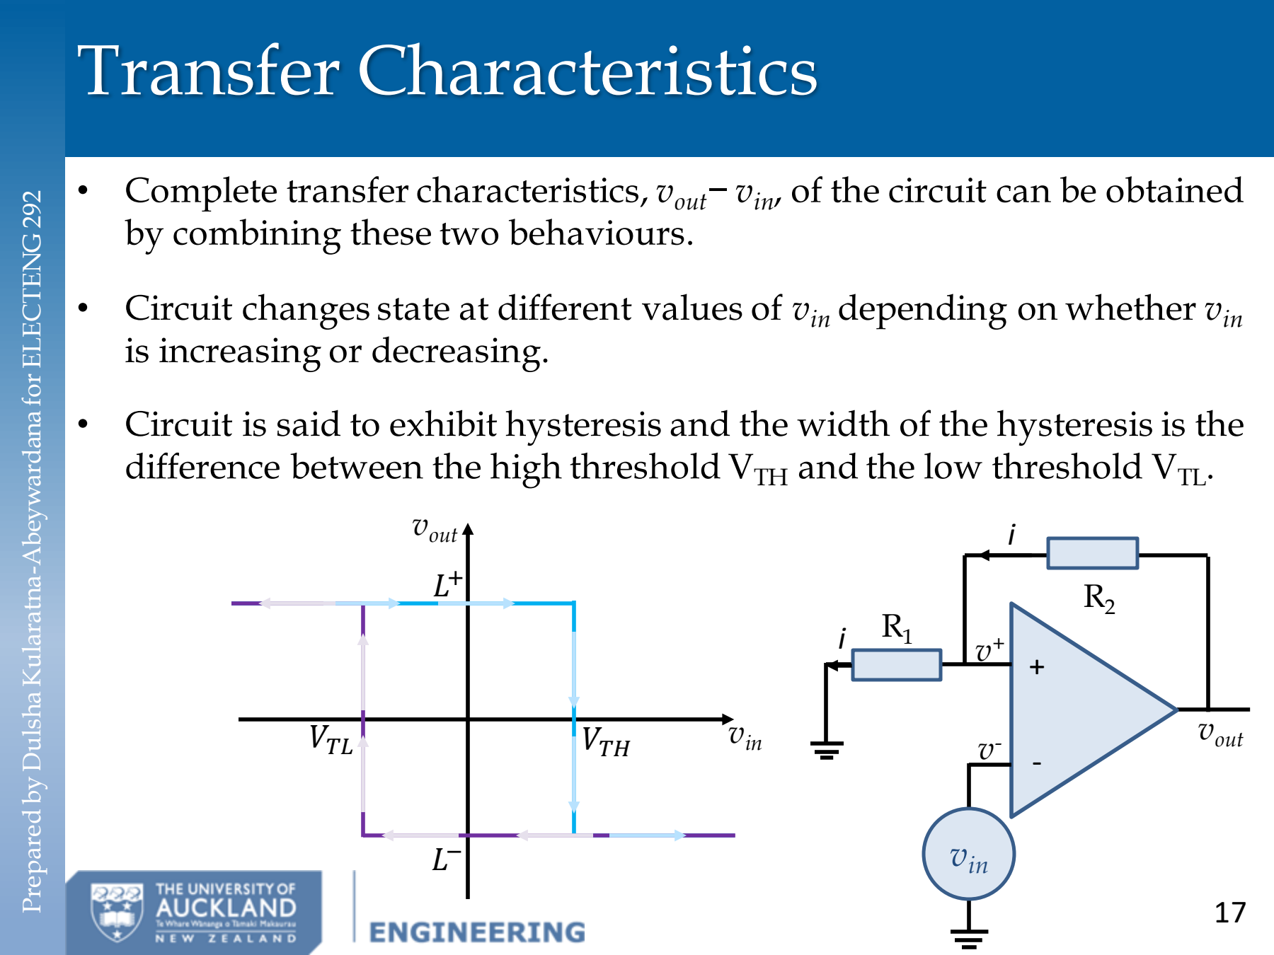
[picture p89: figure]
vout; vin; Transfer Characteristics; by combining these two behaviours.; is increasing or decreasing.; VTL; VTH

Prepared by Dulsha Kularatna-Abeywardana for ELECTENG 292

- Complete transfer characteristics, vout− vin, of the circuit can be obtained
- Circuit changes state at different values of vin depending on whether vin
- Circuit is said to exhibit hysteresis and the width of the hysteresis is the difference between the high threshold VTH and the low threshold VTL.

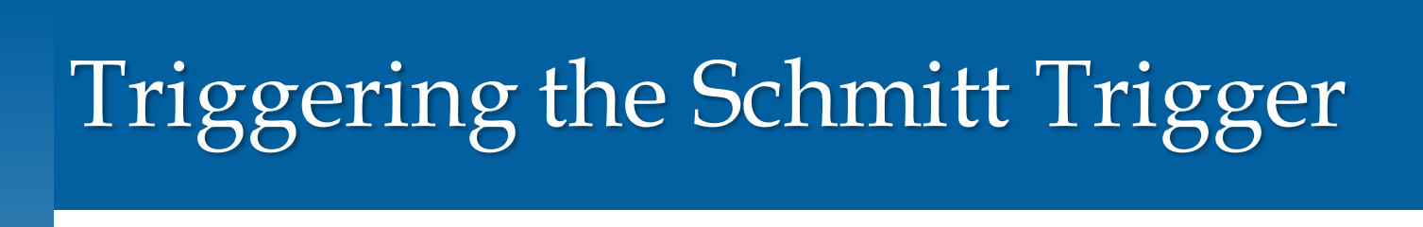
[picture p90: figure]
Triggering the Schmitt Trigger

Prepared by Dulsha Kularatna-Abeywardana for ELECTENG 292

### - If the circuit is in the L

### + state it can be switched to the L

−

### state by applying an input vin of value greater than the

## positive threshold voltage VTH = βL

+.

### - The net negative input between the opamp’s input terminals triggers a regenerative cycle that drives the

## output to the stable state of L

−.

## - Since vin only triggers the switching process it can be a

short pulse, or a trigger signal.

### - Similarly applying a negative trigger signal at vin of

## magnitude greater than the negative threshold voltage

### VTL = βL

−.

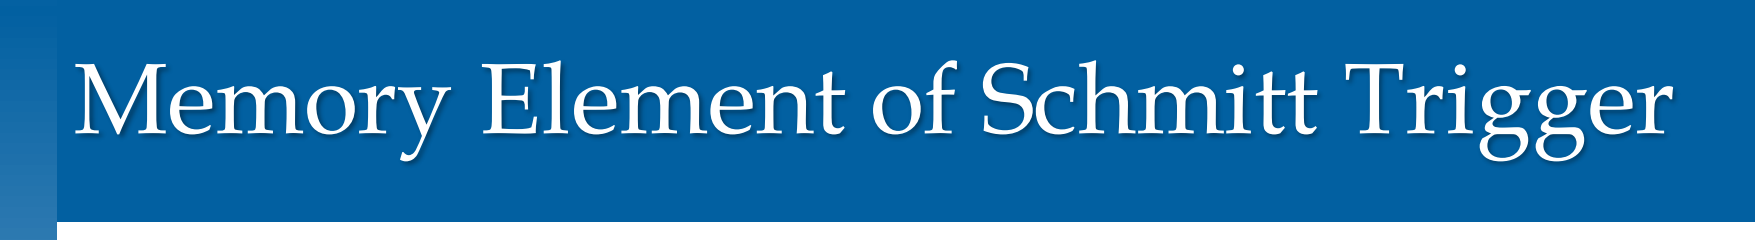
[picture p91: figure]
Memory Element of Schmitt Trigger

Prepared by Dulsha Kularatna-Abeywardana for ELECTENG 292

## - For input voltages in the range VTL < vin < VTH, the output can be either L+ or L−, depending on the

state that the circuit is already in.

## - The output is determined by the previous value of

the trigger signal.

- The circuit exhibits memory.

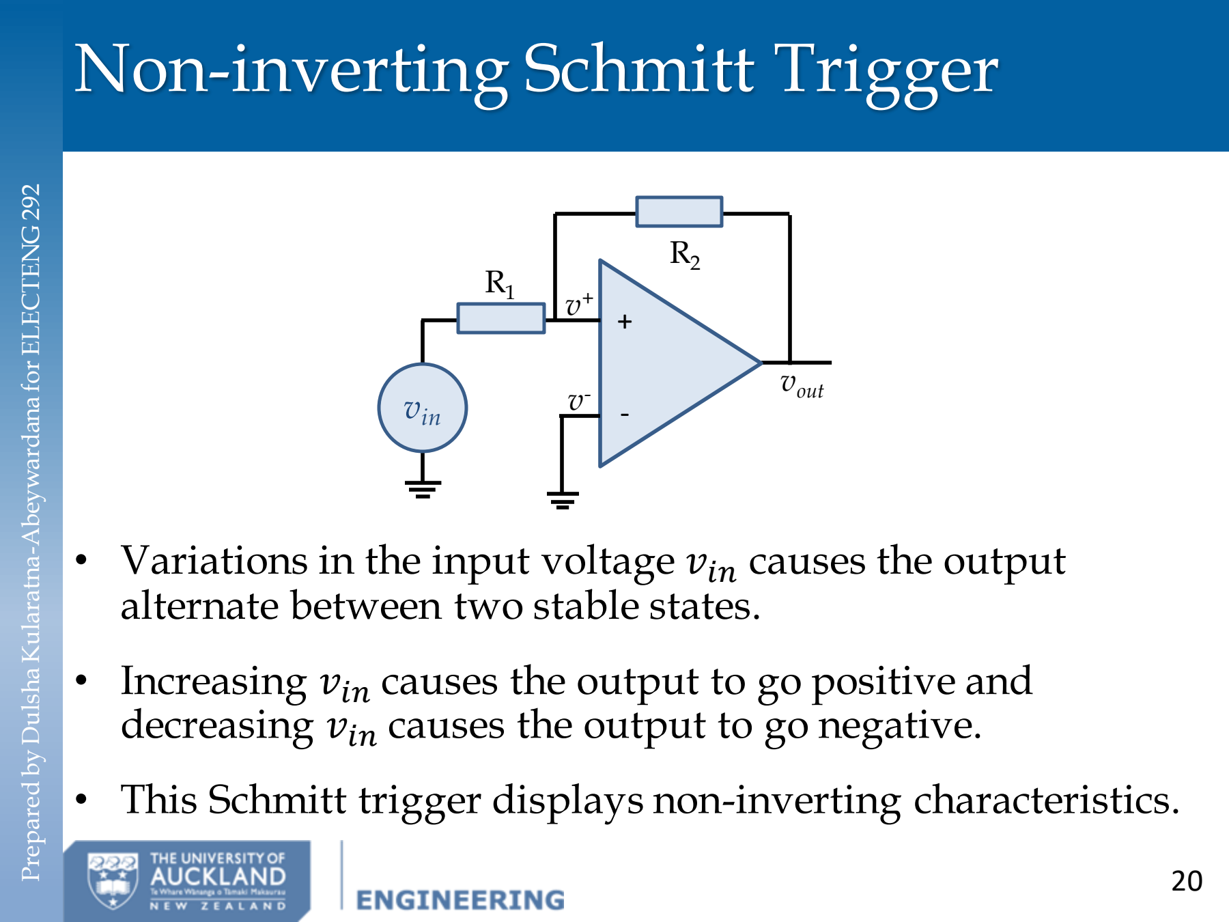
[picture p92: figure]
Non-inverting Schmitt Trigger; alternate between two stable states.; vout; vin

Prepared by Dulsha Kularatna-Abeywardana for ELECTENG 292

## - Variations in the input voltage vin causes the output

## - Increasing vin causes the output to go positive and

decreasing vin causes the output to go negative.

- This Schmitt trigger displays non-inverting characteristics.

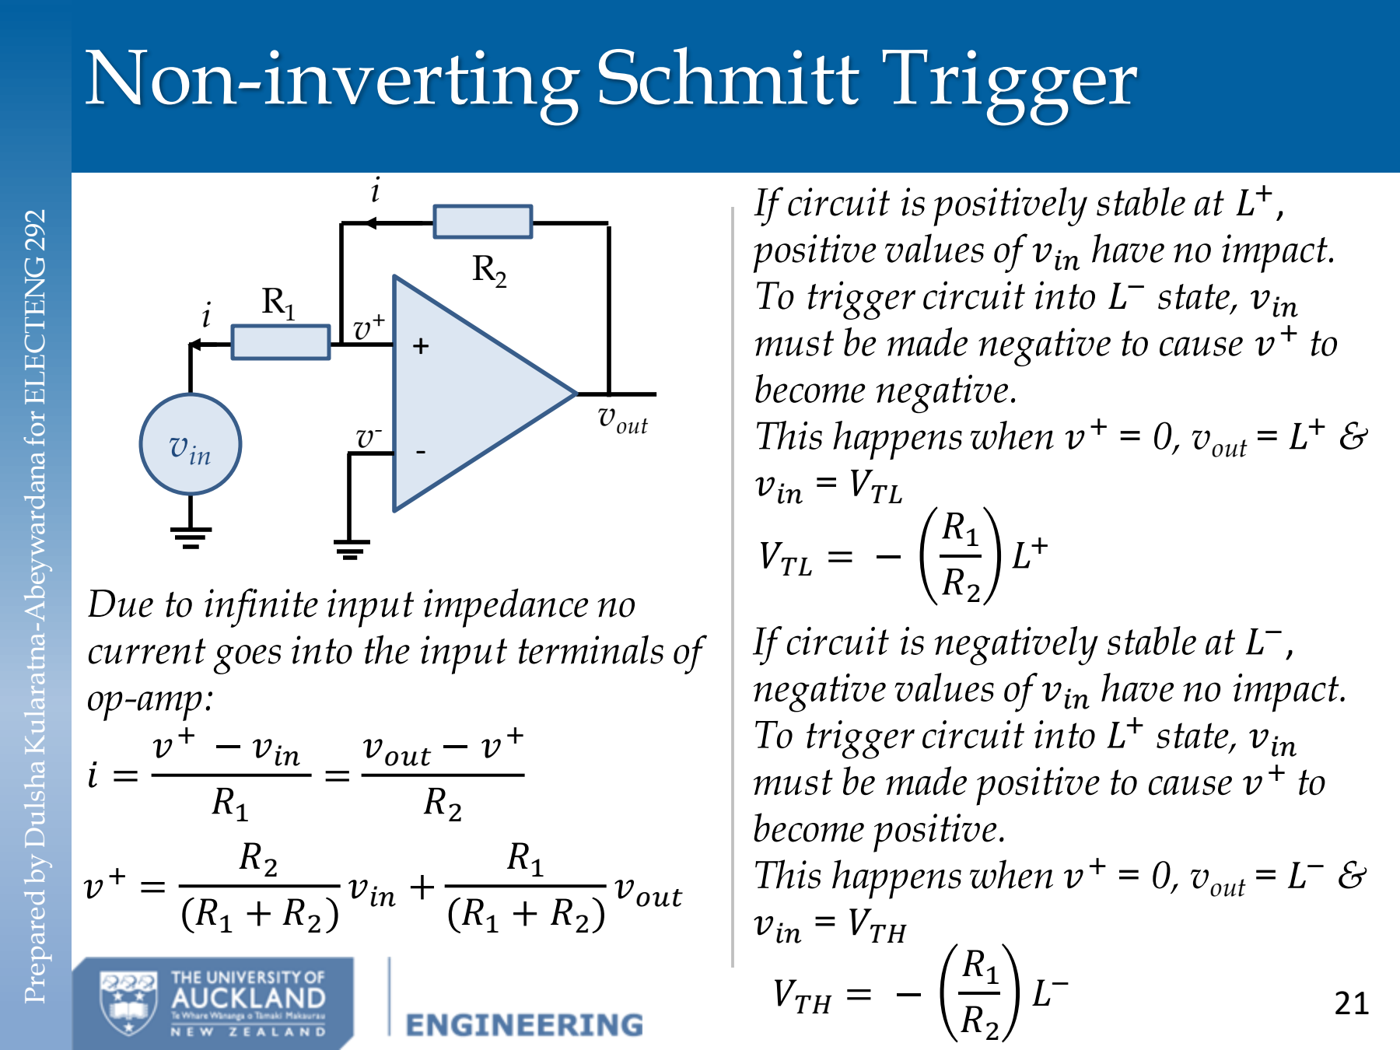
[picture p93: figure]
Non-inverting Schmitt Trigger; + − vin; vout − v; Due to infinite input impedance no; op-amp:; vout; vin; vin +; If circuit is positively stable at L; , positive values of vin have no impact. To trigger circuit into L; − state, vin must be made negative to cause v; become negative. This happens when v; + = 0, vout = L; vin = VTL; VTL = −; If circuit is negatively stable at L; −, negative values of vin have no impact. To trigger circuit into L; + state, vin must be made positive to cause v; become positive. This happens when v; vin = VTH; VTH = −

Prepared by Dulsha Kularatna-Abeywardana for ELECTENG 292

current goes into the input terminals of

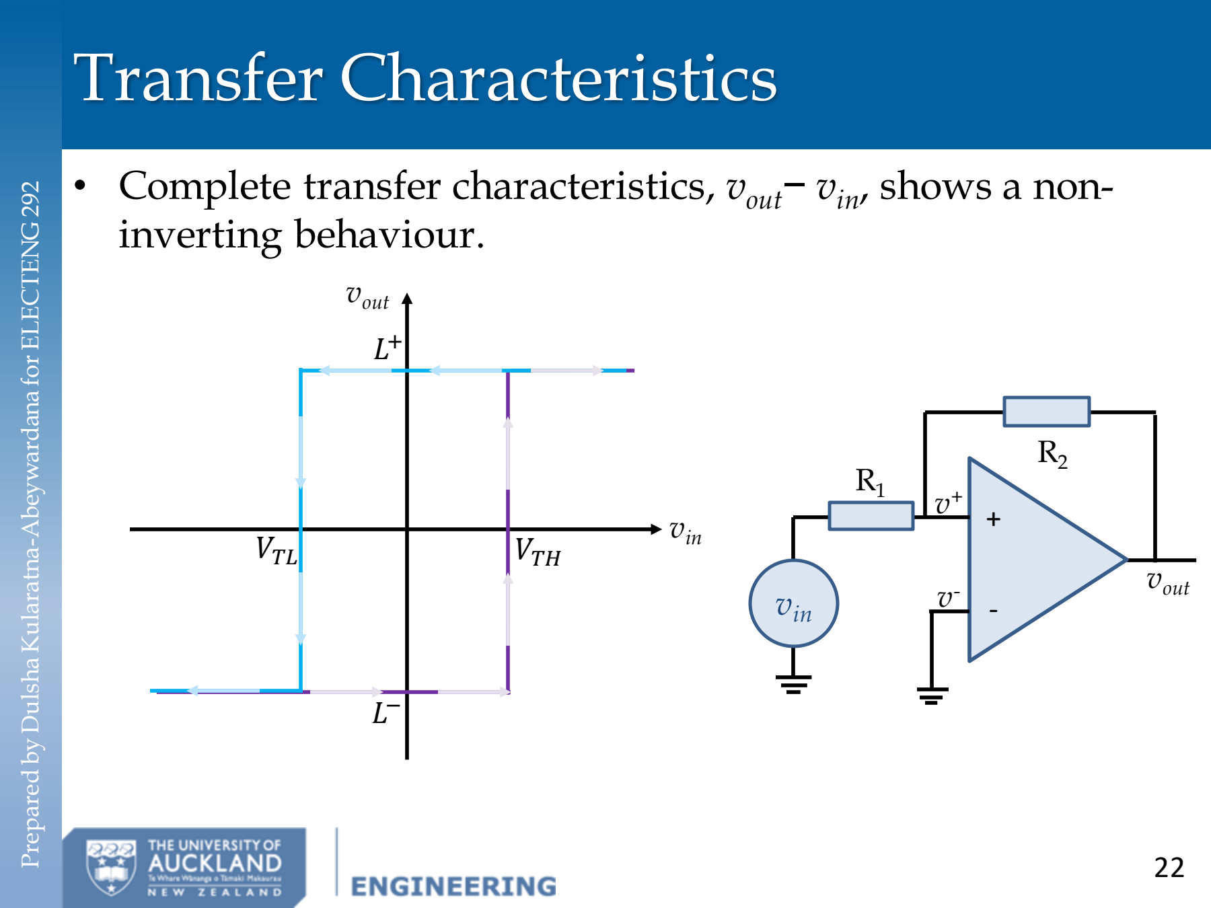
[picture p94: figure]
vout; vin; Transfer Characteristics; inverting behaviour.; VTL; VTH

Prepared by Dulsha Kularatna-Abeywardana for ELECTENG 292

### - Complete transfer characteristics, vout− vin, shows a non-

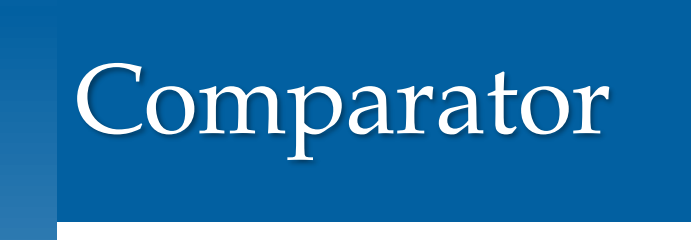
[picture p95: figure]
Comparator

Prepared by Dulsha Kularatna-Abeywardana for ELECTENG 292

## - A comparator compares one analogue voltage

level with another, or a preset reference voltage,

## VREF and produces an output signal based on this

voltage comparison.

## - Compares the magnitudes of two voltage inputs to

determine which is the largest of the two.

## - Comparators are used to detect the level of an input signal relative to a preset threshold value, to

design of analog-to-digital (A/D) converters, detect zero crossings in a signal etc.

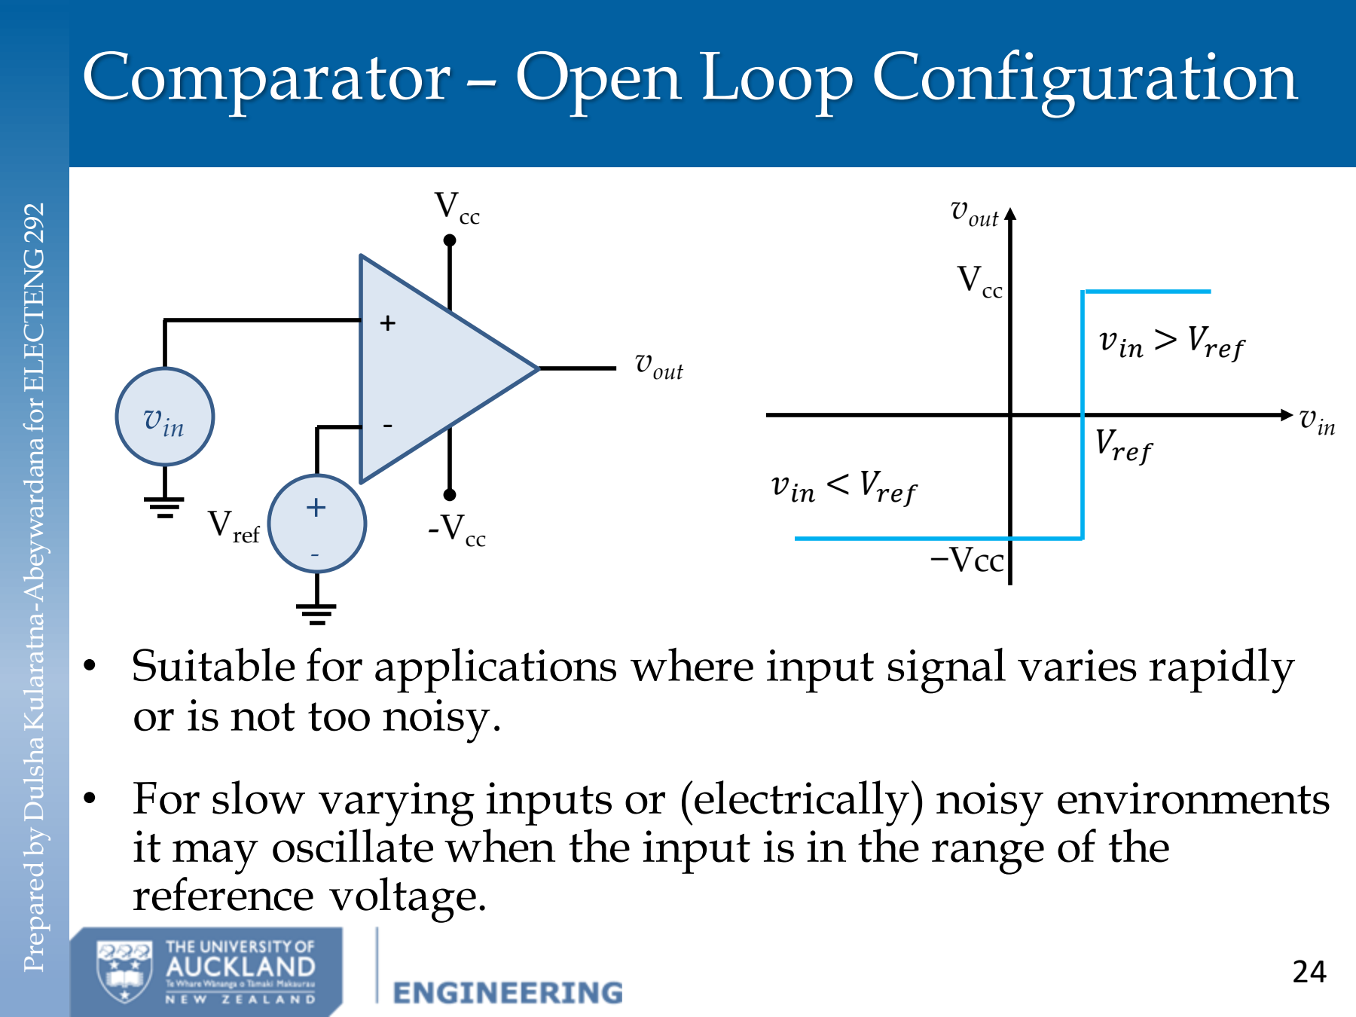
[picture p96: figure]
Comparator – Open Loop Configuration; vout; -Vcc; Vcc; vin; Vref; −Vcc; vin > Vref; vin < Vref; or is not too noisy.; reference voltage.

Prepared by Dulsha Kularatna-Abeywardana for ELECTENG 292

### - Suitable for applications where input signal varies rapidly

### - For slow varying inputs or (electrically) noisy environments

## it may oscillate when the input is in the range of the

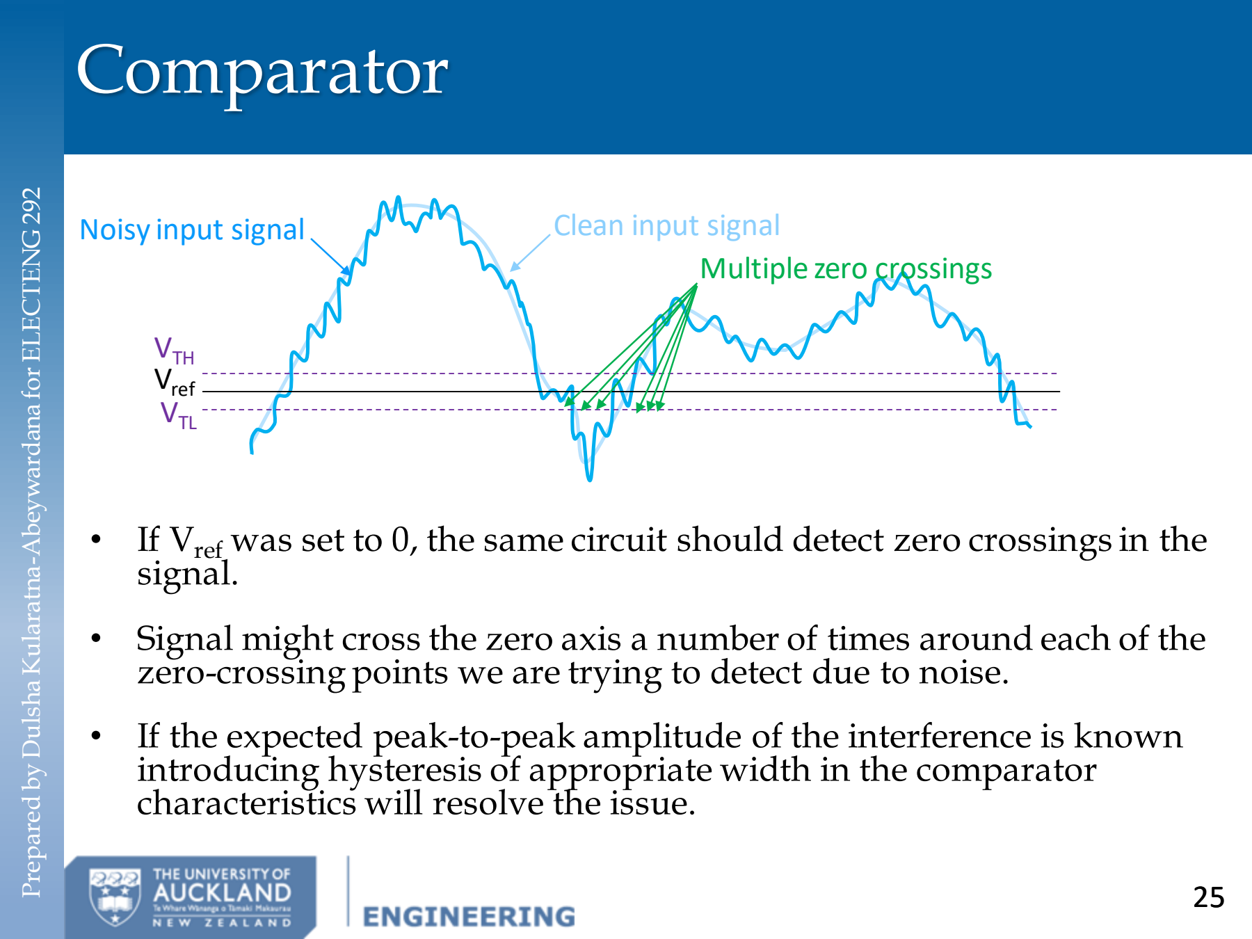
[picture p97: figure]
Comparator; signal.; characteristics will resolve the issue.; Vref; VTL; VTH; Noisy input signal; Multiple zero crossings; Clean input signal

Prepared by Dulsha Kularatna-Abeywardana for ELECTENG 292

- If Vref was set to 0, the same circuit should detect zero crossings in the
- Signal might cross the zero axis a number of times around each of the zero-crossing points we are trying to detect due to noise.
- If the expected peak-to-peak amplitude of the interference is known introducing hysteresis of appropriate width in the comparator

# Comparator with Feedback

### - Vref, VTH and VTL need to be designed according to the

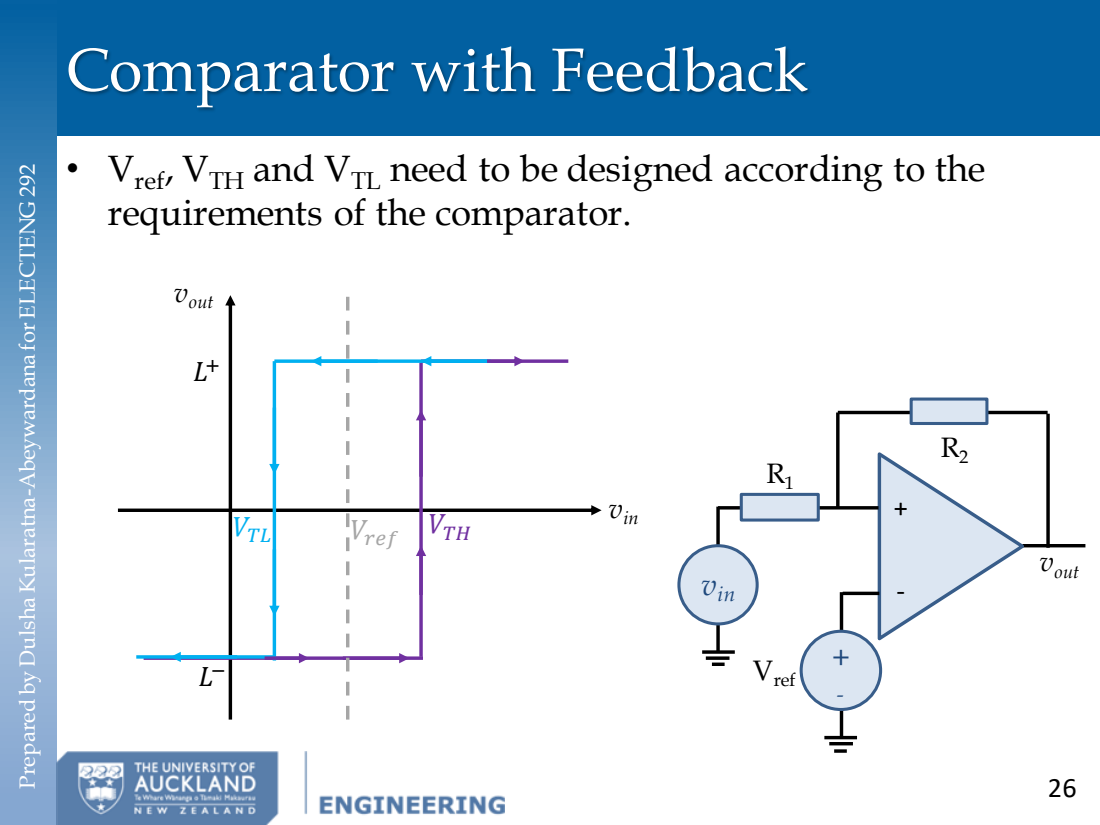
[picture p98: page 26]
vin; vout; VTL; VTH; Vref

Prepared by Dulsha Kularatna-Abeywardana for ELECTENG 292
requirements of the comparator.

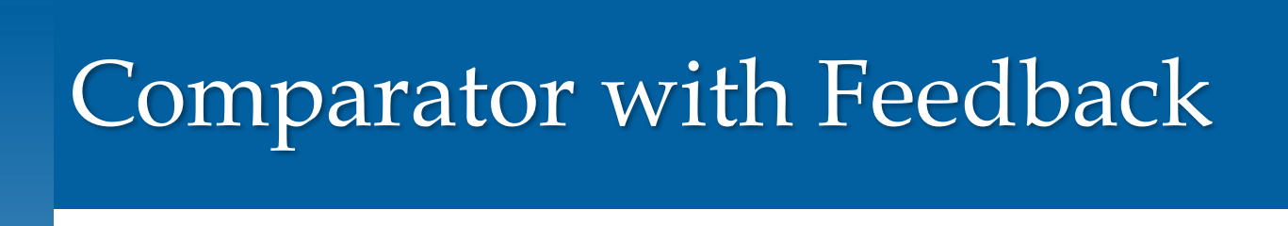
[picture p99: figure]
Comparator with Feedback

Prepared by Dulsha Kularatna-Abeywardana for ELECTENG 292

## - If the input signal is increasing in magnitude the comparator with hysteresis will remain in the low state until the input level exceeds the high

threshold VTH.

## - Subsequently the comparator will remain in the high state even if, owing to interference, the signal

decreases below VTH.

## - The comparator will switch to the low state only if the input signal is decreased below the low

threshold VTL.
