Puthikunkim/capstone/compsys-team/ProjectResource/Altium209/EE209_RecommendedDesign_TH.pdf

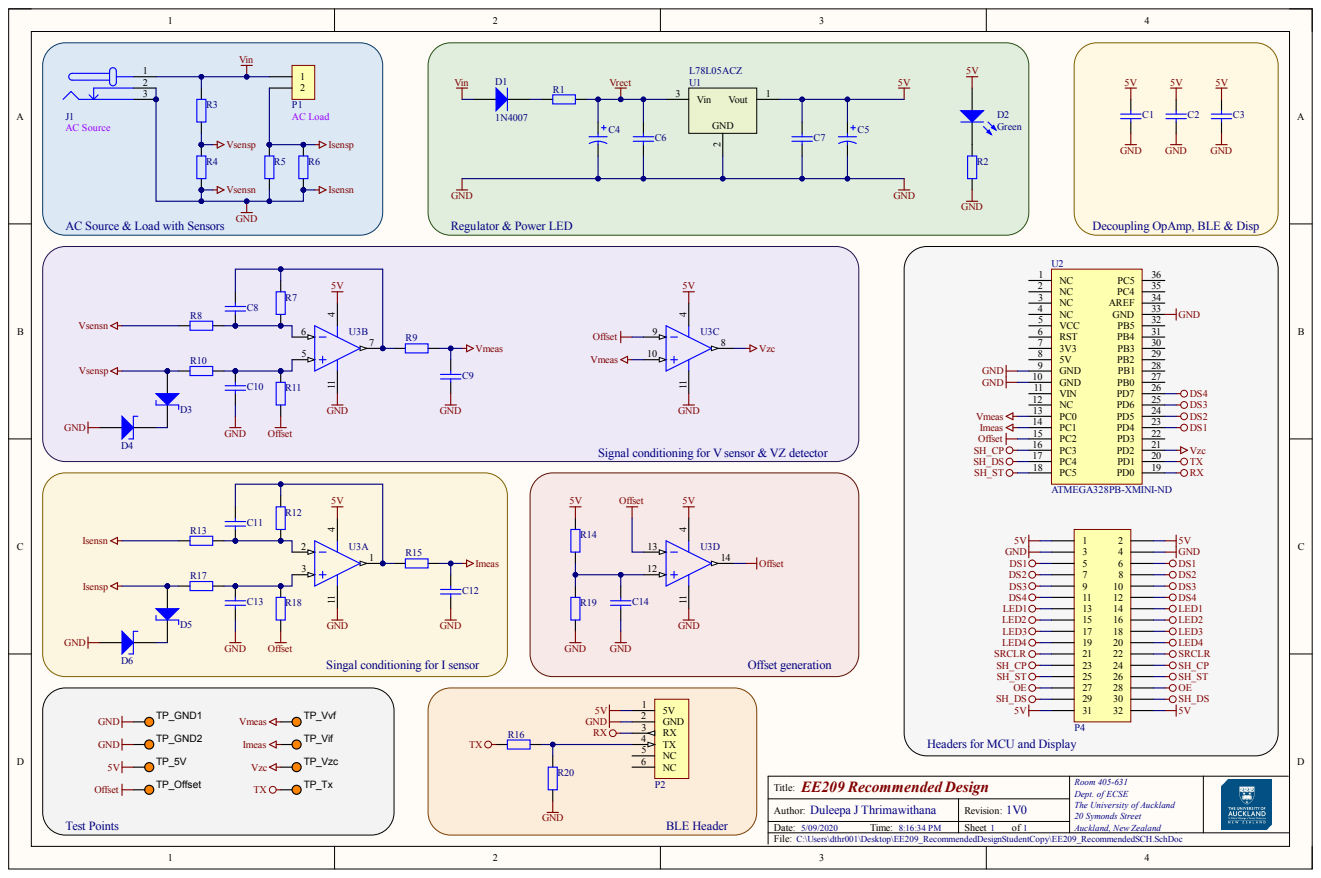
[picture p100: page 1]

Signal conditioning for V sensor & VZ detector

Headers for MCU and Display

Room 405-631
Dept. of ECSE
The University of Auckland
20 Symonds Street

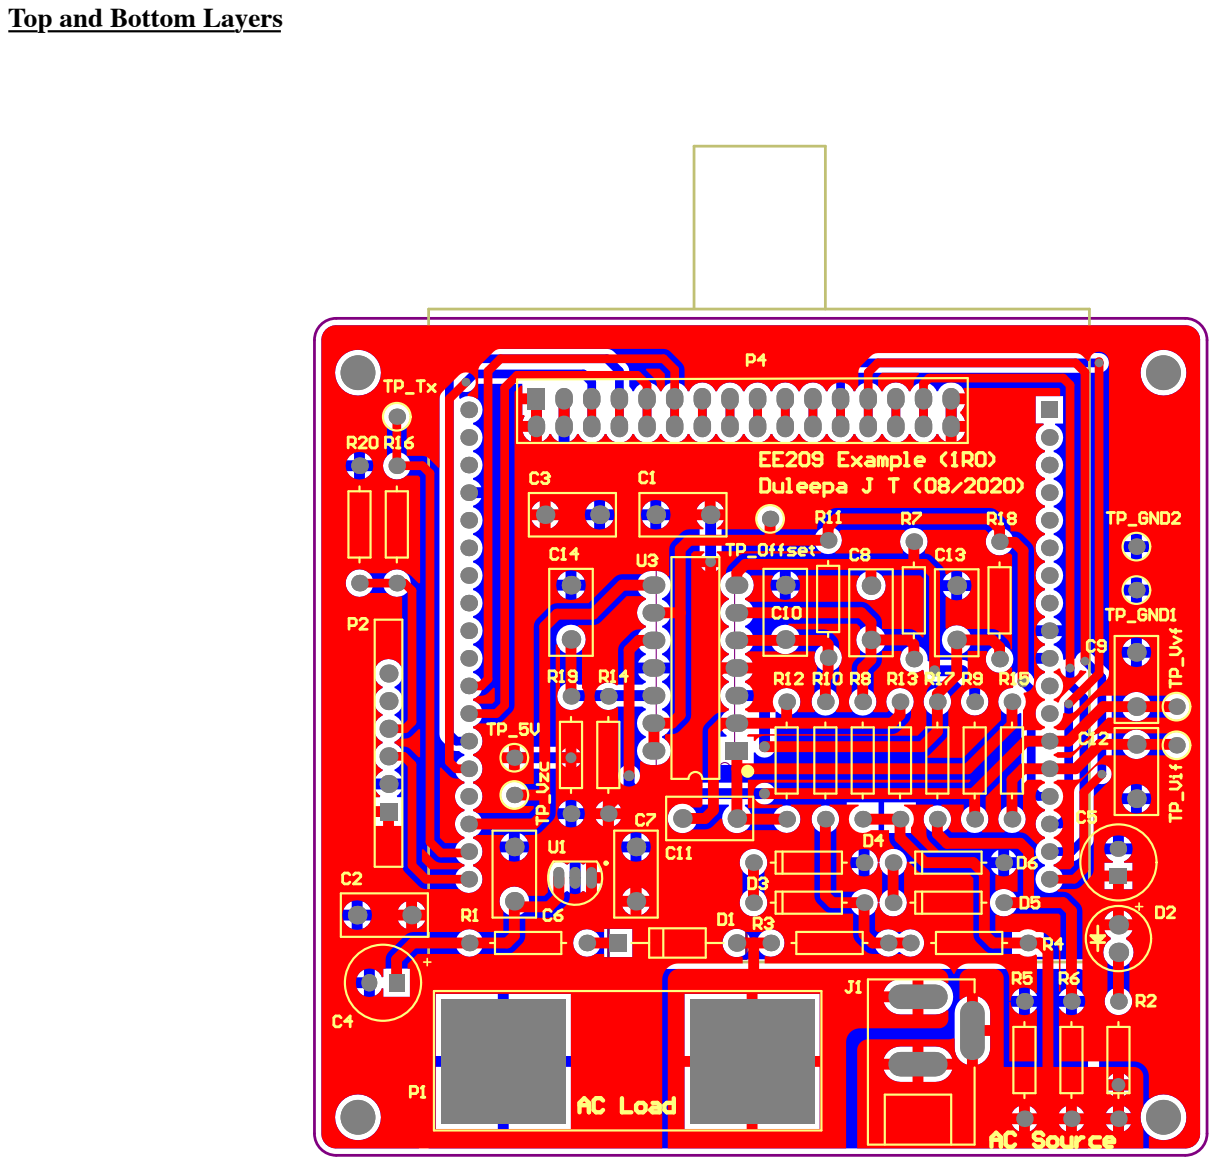
[picture p101: page 2]

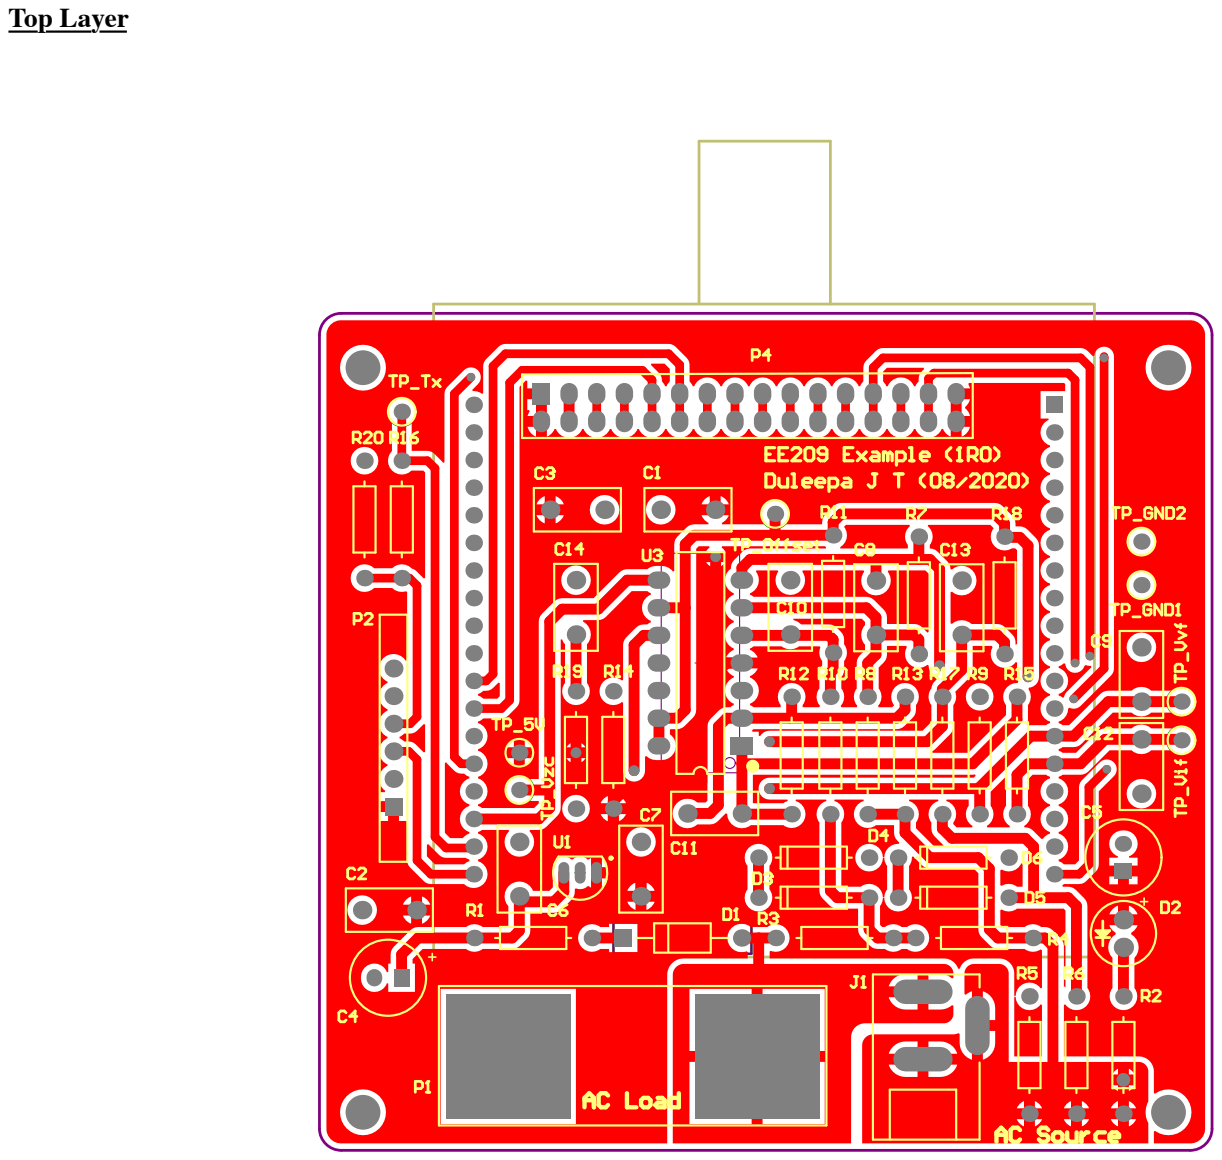
[picture p102: page 3]

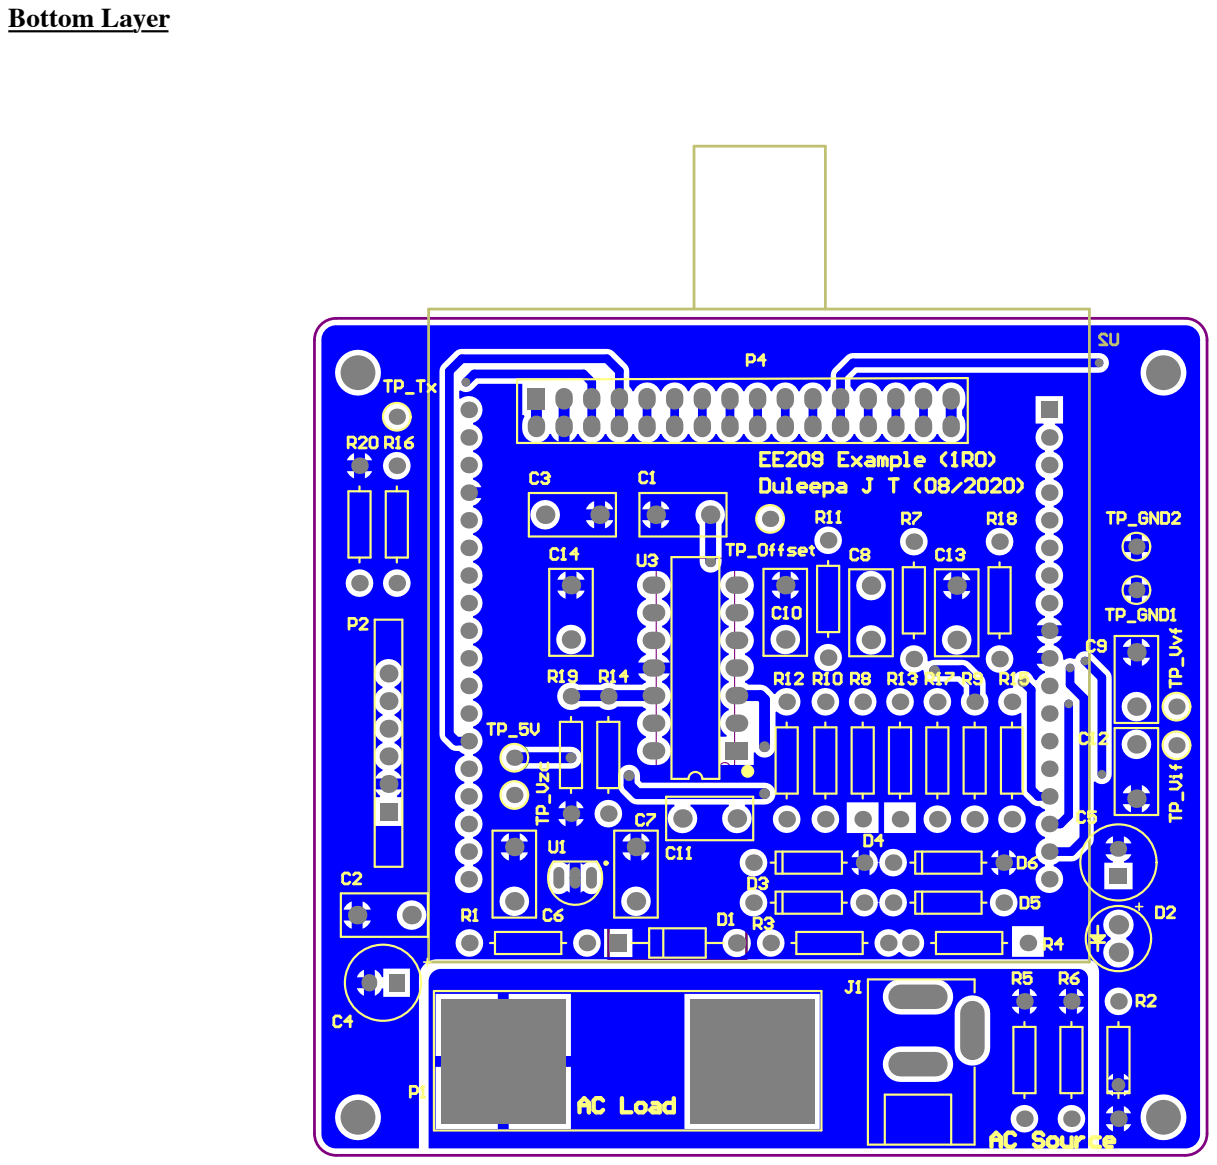
[picture p103: page 4]

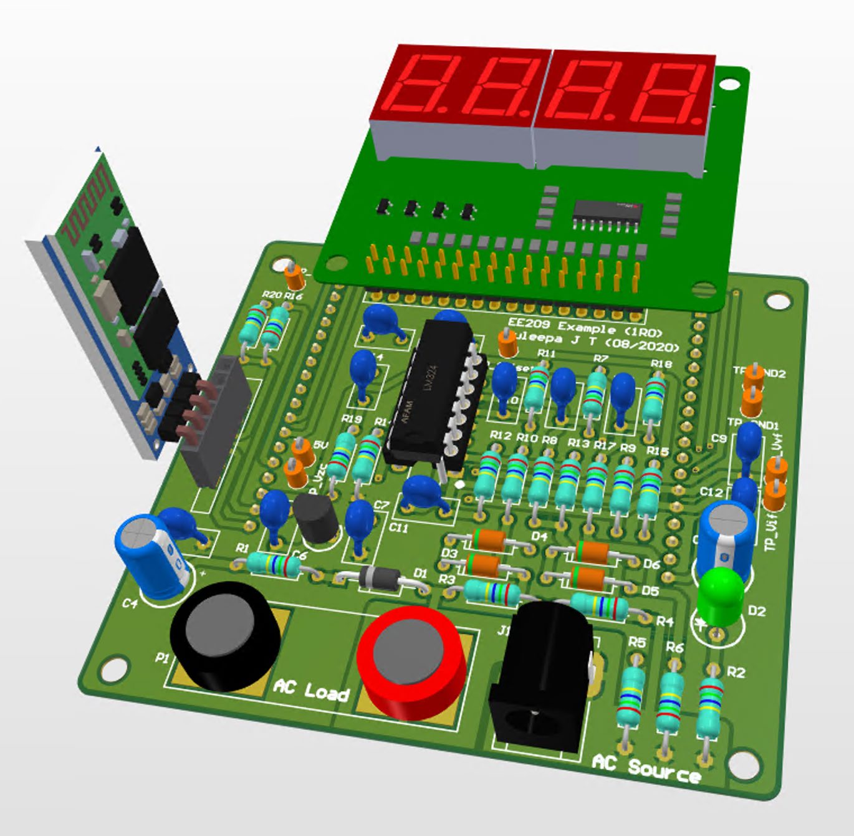
[picture p104: page 5]

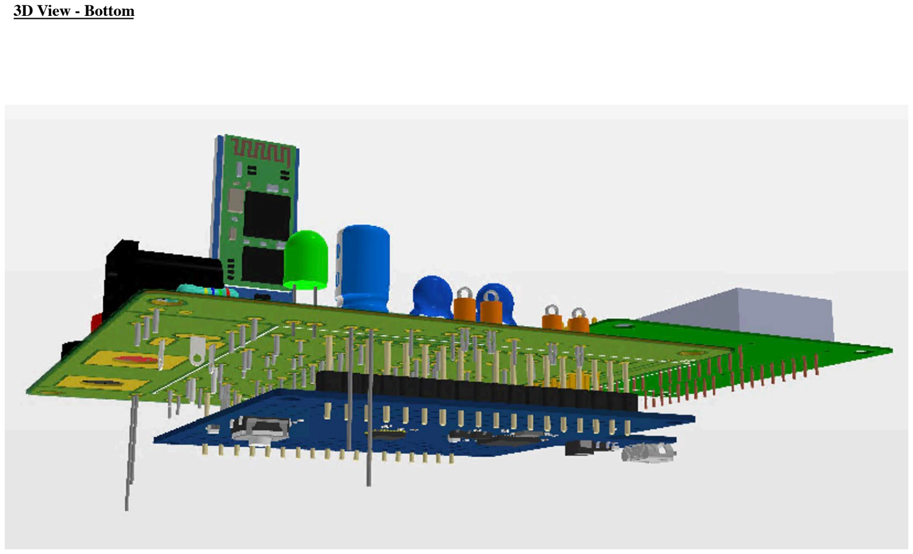
[picture p105: page 6]
