Puthikunkim/capstone/compsys-team/ProjectResource/Specification/PCBforUniDirectional.pdf

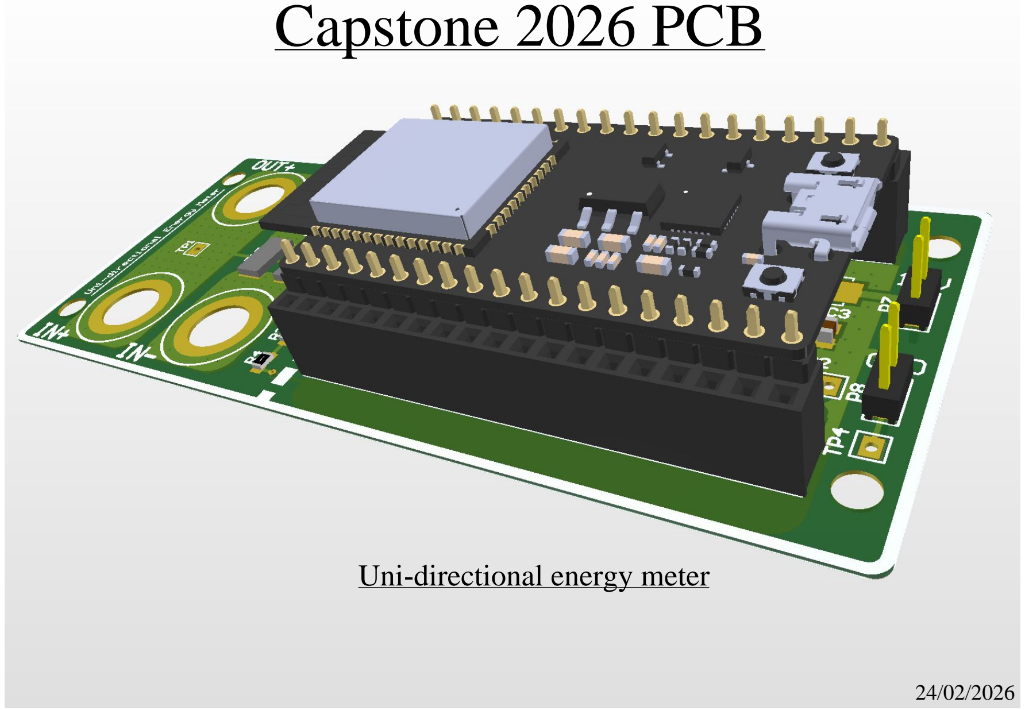
[picture p106: page 1]

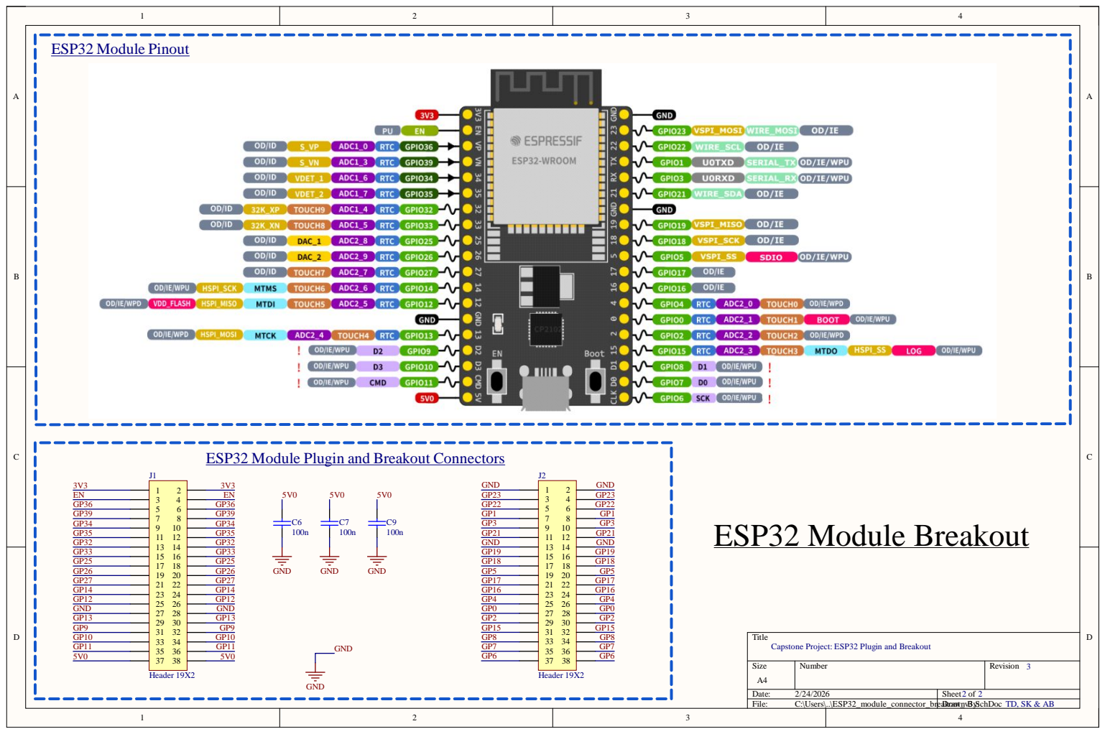
[picture p107: page 2]

ESP32 Module Plugin and Breakout Connectors

Title
Capstone Project: ESP32 Plugin and Breakout

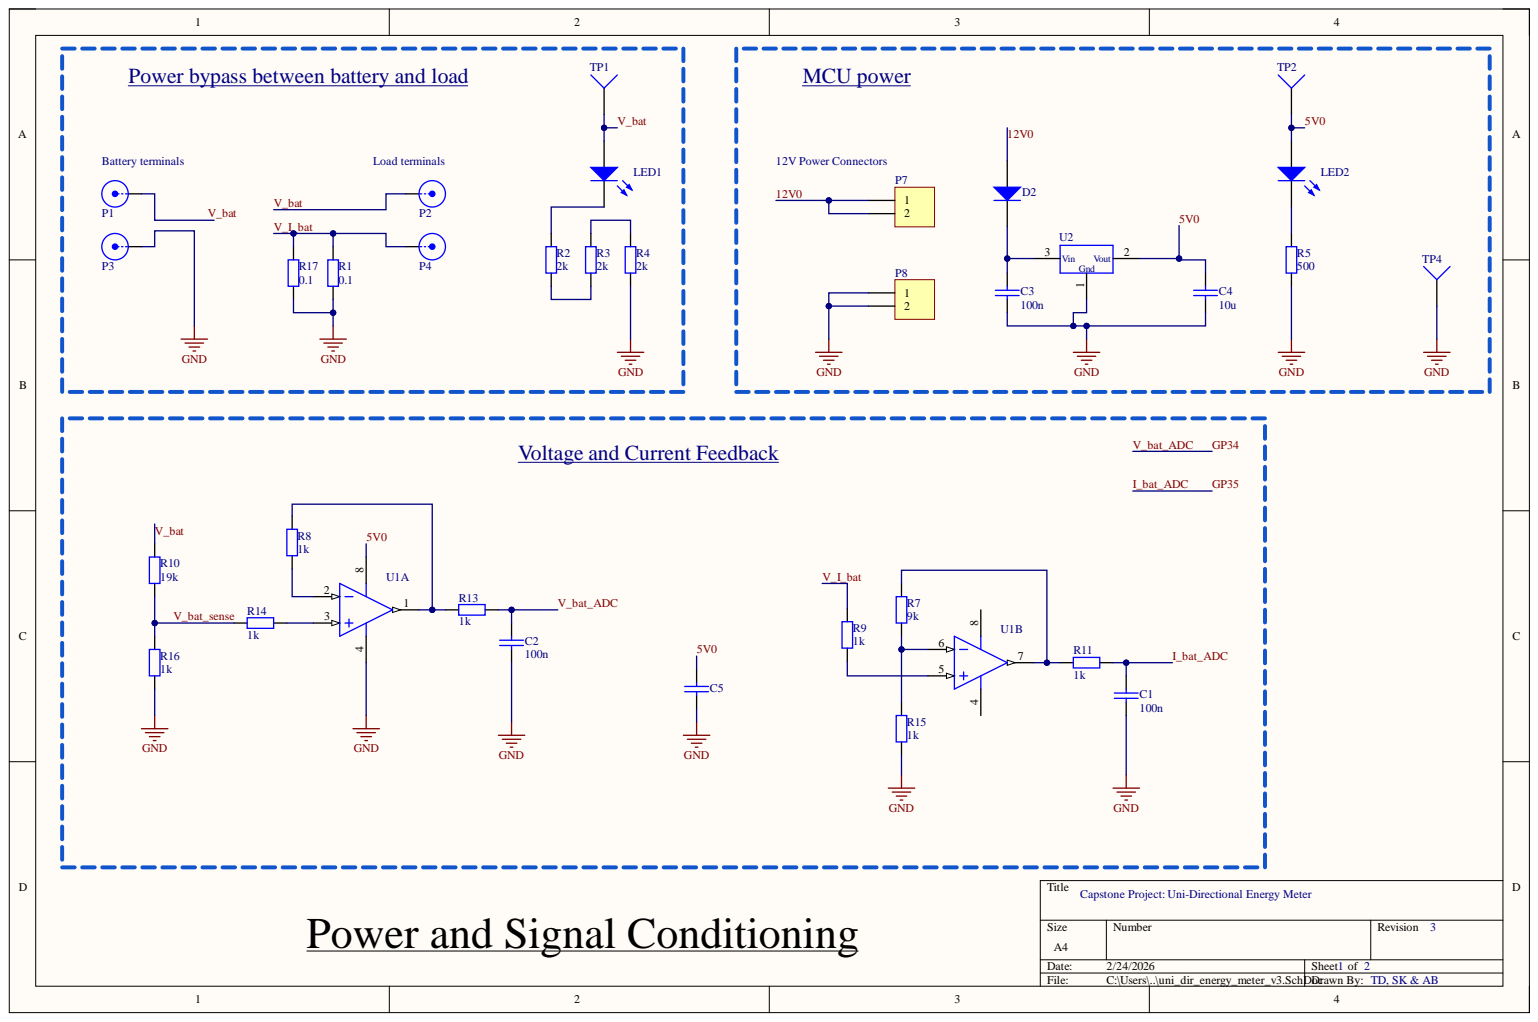
[picture p108: page 3]

Power bypass between battery and load

Voltage and Current Feedback

Title
Capstone Project: Uni-Directional Energy Meter

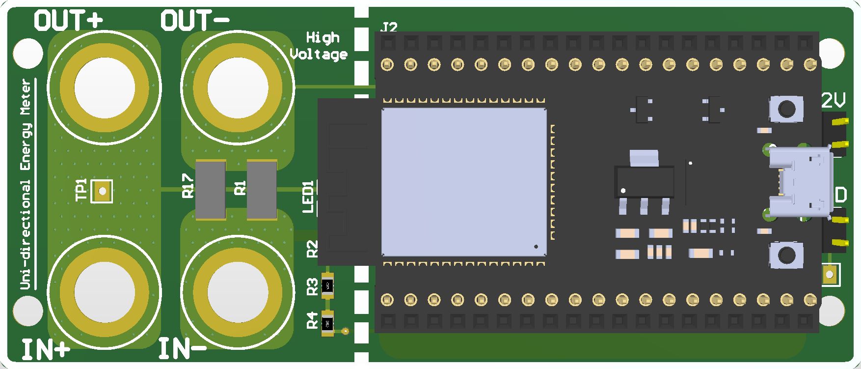
[picture p109: page 4]

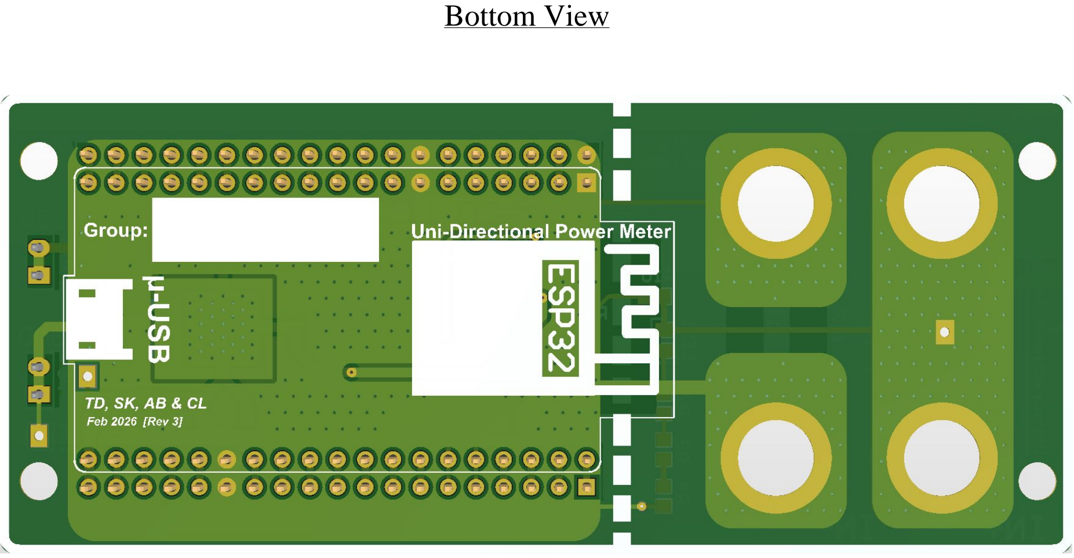
[picture p110: page 5]

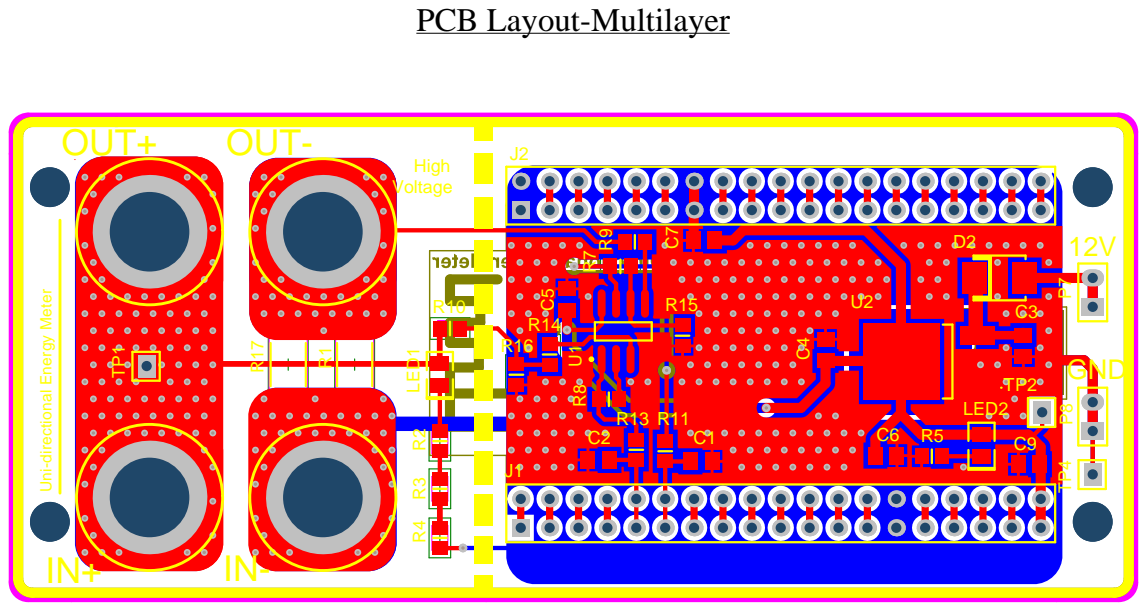
[picture p111: page 6]

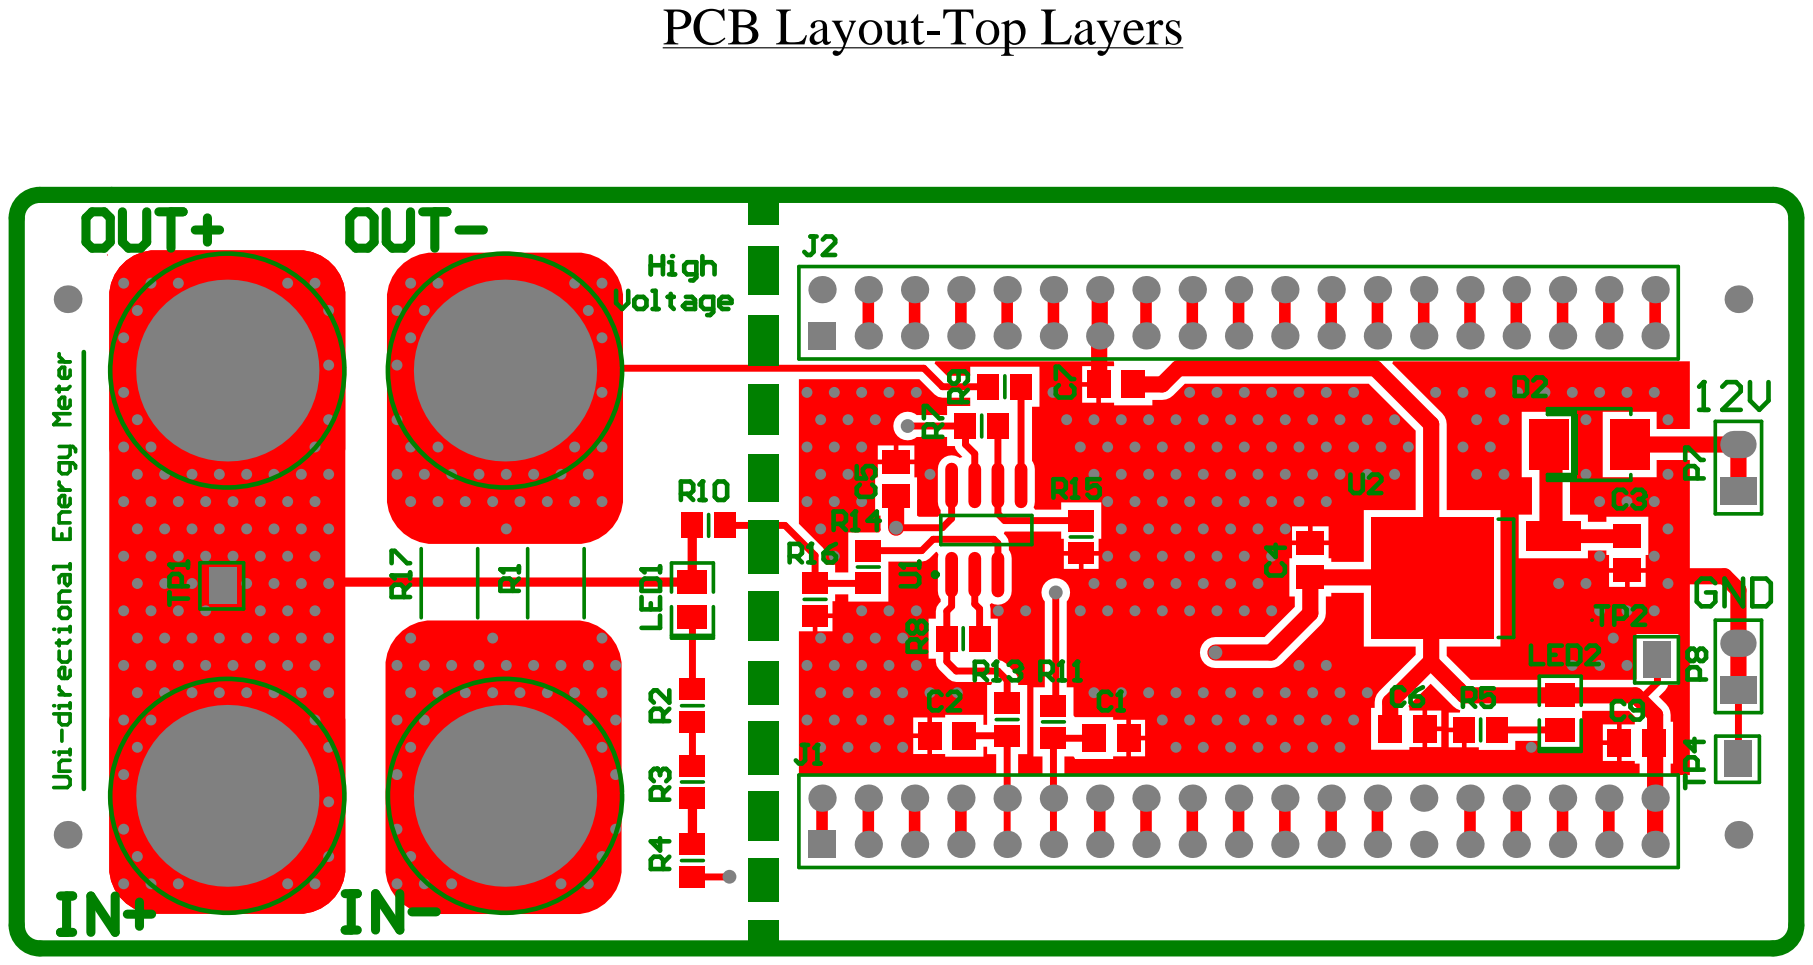
[picture p112: page 7]

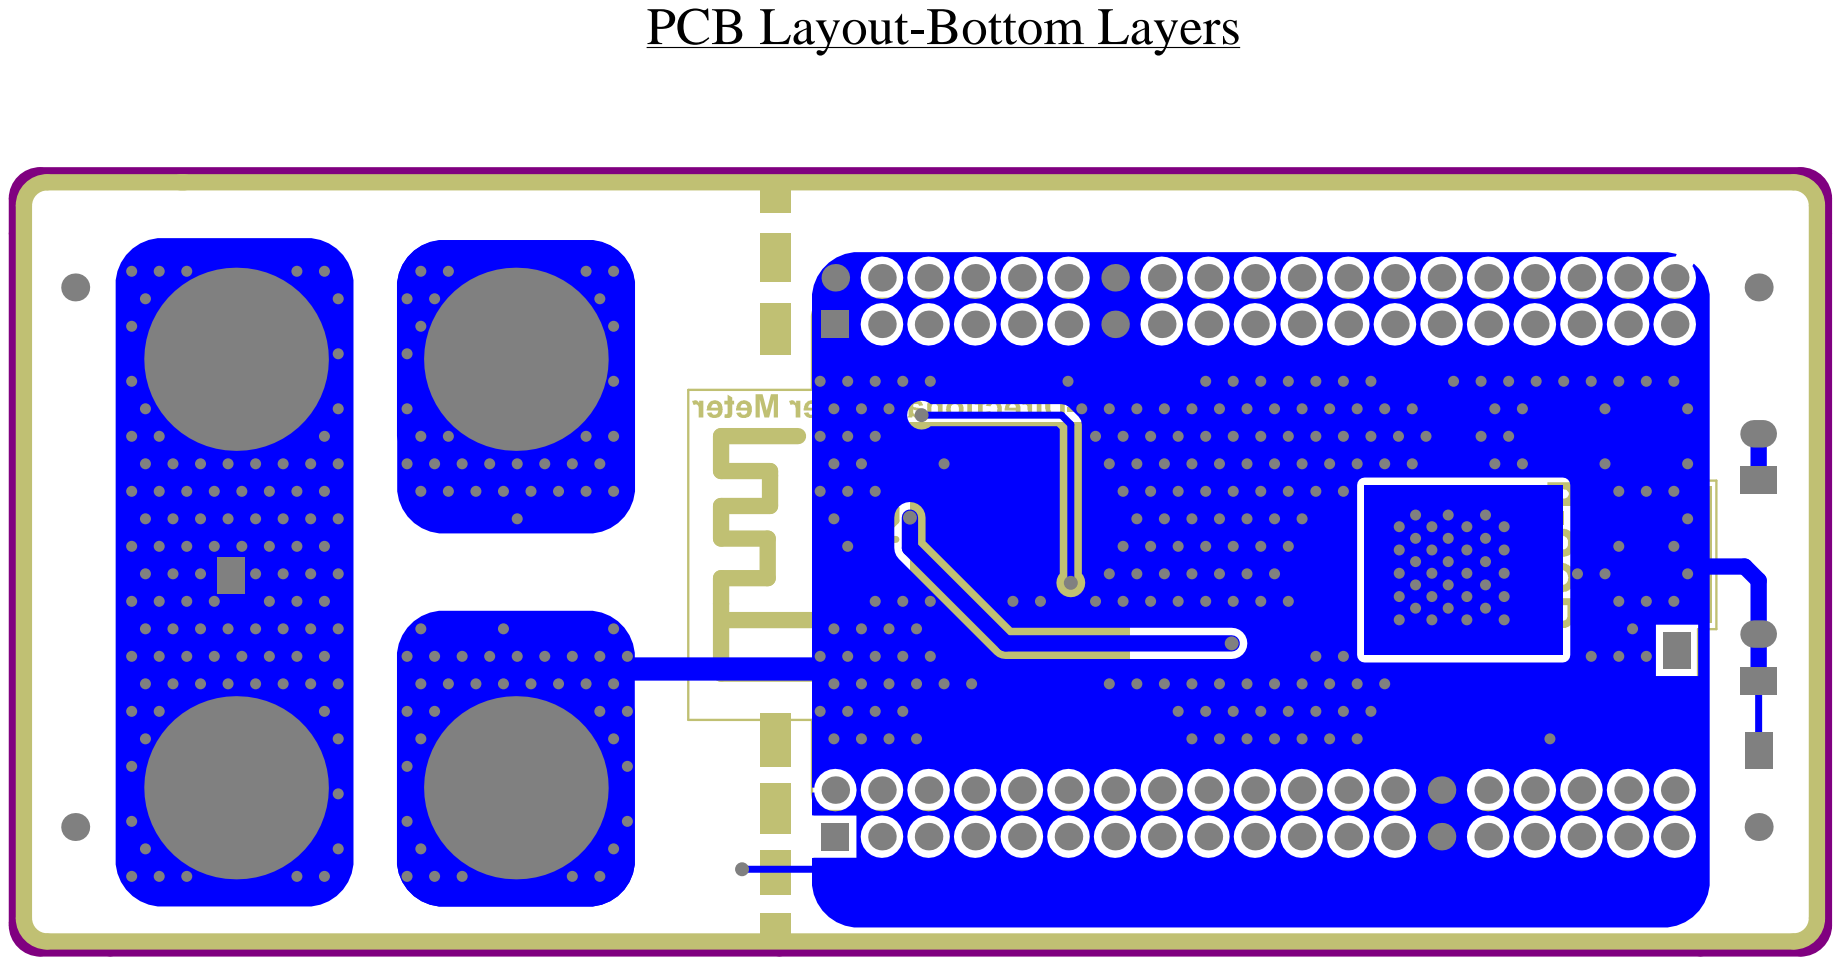
[picture p113: page 8]
