Puthikunkim/capstone/compsys-team/LTSPICE/CourseExample.asc

C1: cap; 100n
C2: cap; 100n
I1: current; -3
R7: res; 9k
R8: res; 1k
R9: res; 1k
R10: res; 19k
R11: res; 1k
R13: res; 1k
R14: res; 1k
R15: res; 1k
R16: res; 1k
R17||R1: res; 0.05
U2: UniversalOpAmp
U3: UniversalOpAmp
V1: voltage; 0; Rser=1
V2: voltage; 5
V3: voltage; 120; Rser=1
Named nets: 0, Vbat, 5V, Ibat
.tran 1s
