Puthikunkim/capstone/(commit log)

2026-03-11 chore: Addressing comment discrepancy between sampling rate of ESP32 and display rate of frontend
2026-03-11 Example Simulation
    Added LT Spice simulation of current and voltage sensing cct of example board
2026-03-16 ADC implementation - One shot mode.
2026-03-16 Created dummy server that ESP32 can send data to over laptops mobile hotspot IP
2026-03-17 ltSpice Changes
    Change voltage values to test
2026-03-17 feat: Finish implementing the energy frames model file
2026-03-17 feat: Implemented the storage.py which contains logic for managing ECUs, frames and alerts
2026-03-17 Create esp32_datasheet_en.pdf
    ESP32 datasheet
2026-03-18 Create Schematic Analysis Unidirectional.pdf
2026-03-18 Create L2 - Voltage and Current Sensors.pdf
2026-03-18 Create L4 - Practical Circuits and RC Filters.pdf
2026-03-20 Update L4 - Practical Circuits and RC Filters.pdf
2026-03-21 Feat/backend api routes (#10)
    * made request reponse schemas for data validation
    * finished writing api endpoints and made a test script to simulate esp32 sending data
    * removed db file from tracking
    * added end points for wireless firmware updates
    ---------
2026-03-22 feat: Graphing voltage, current and energy
2026-03-23 Added ADC integration and fixed time bug
    [hello_world_main.c]
2026-03-30 Add ADC calibration to get more accurate ADC values.
2026-04-21 backend: persist power_watts through frame pipeline
2026-04-23 backend: add 30s efficiency leaderboard with power-integrated energy
2026-04-27 feat: redesign dashboard with ECU config, alerts, firmware upload and displaying extra datas like temperature:
2026-04-29 Revert "changed from sending json to raw bytes"
    This reverts commit 730234b98d2d9e070c4adfa128a83cb7c4ec7df9.
    [hello_world_main.c]
2026-04-30 Decoupled ADC and send logic
2026-05-02 feature/ Team Creation and Competition Creation (#23)
    * add competitions, team creation, ECU assignment and dashboard improvements
    * fix: minor fixes to pass CI tests
    * feature: removed power limit changes in ECU configuration
    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
    [database.py]
2026-05-04 fixed websocket to stream to frontend
    [config.py, main.py, serial_reader.py]
2026-05-04 Fixed the patchy packet sending
    [main.py, serial_reader.py]
2026-05-08 fix: fixing the linting issues
    [config.py, main.py, serial_reader.py]
2026-05-09 fix: fixing the current tests
2026-05-15 refactor: replace serial_number with mac_address in ECU model and related schemas
    [serial_reader.py]
2026-05-15 refactor: add power_limit_watts to ECU configuration and handle power limit requests in serial reader
2026-05-15 Implement time synchronization and power limit request handling in sender and controller
2026-05-15 refactor: update power limit test to allow changes via configuration
2026-05-15 fixed time sync and mac Adress issues
    [hello_world_main.c]
2026-05-18 fix: fixing unused variable issue
    [main.py]
2026-05-19 refactor: no longer averaging the voltage/current values
    [database.py, serial_reader.py]
2026-05-19 refactor: calculating 10 power values per frame
2026-05-20 Reset registration status on disconnection in sender task
    [hello_world_main.c]
2026-05-20 Enhance sender functionality with flash persistence and update frame handling
    [partitions.csv]
2026-05-20 Increase buffer size for UART JSON transmission and fix CMake dependencies
    [hello_world_main.c]
2026-05-20 feature: configuring power limit input
2026-05-20 fix: changing how energy frame data is displayed
2026-05-21 Refactor power threshold initialization and task creation in sender module
2026-05-22 feat: toast for warning, red dot for violation start, panel log for resolved
    [simulate_esp32-3.py]
2026-05-22 added sleep mode and adc to work with dual inputs
2026-05-22 fix some sleep bugs
    [hello_world_main.c]
2026-05-23 refactor: revert MAX_FRAMES to 3 and update logging for non-JSON lines
    [serial_reader.py]
2026-05-23 Add buzzer functionality and GPIO configuration to handle power limit breaches
    [hello_world_main.c]
2026-05-23 fix: remove unused useSessionTimer function and fix flake8 alignment errors
    - Remove unused useSessionTimer function definition from Dashboard.jsx (no-unused-vars lint error)
    - Fix E221 multiple-spaces-before-operator in simulate_esp32-3.py constants
    [simulate_esp32-3.py]
2026-05-23 refactor: reduced the number of add buttons
2026-05-23 Restore missing BUZZER_BEEP_HALF_MS define dropped in merge
    [hello_world_main.c]
2026-05-23 feature: back button to leaderboard
2026-05-23 fixed build error in the sender file
    [hello_world_main.c]
2026-05-23 fixed voltage accuracy
2026-05-23 refactor: removed voltage and current conversions since the esp is already sending stepped up values
2026-05-24 refactor: changing current to 3dp
2026-05-24 refactor: changed the frontend flow of events and teams in competitions
2026-05-24 refactor: using the average value for the box for current
2026-05-24 include sleep mode and proper adc channel reading
2026-05-25 fix: display correct team information
    [simulate_esp32-4.py]
2026-05-25 fix: fixing the way time filtering works
2026-05-25 feat: add average voltage, current, and power calculations to dashboard
2026-05-25 fix: improve WebSocket close handling and set default props for Navbar component
